nexus4812/nixie-jjy-clock/hardware/pcb/generated/routing/README.md

# control-r1 配線セッションの保存版

2026-11-08のローカル配線入力DSN、結果SES、SHA-256対応記録を保存する。`build/control-board/` から検査後にコピーした生成物で、直接編集しない。製造用出力ではない。

現在のPCBを開いて検査するだけなら、このSESを再取り込みする必要はない。配置/接続/制約/ライブラリ版やclone先のパスを変えた場合は、現在のDSNを生成して再配線する。DSN先頭の絶対パスもハッシュ対象なので、他PCで保存セッションを無条件に再利用しない。

再開コマンド、ツール取得元/版/チェックサム、線幅拡幅後の再DRCについては `git show 4e38a86:HANDOFF.md` を参照。`.routing.json` は実行時のパスを含む履歴であり、ユーザー設定ではない。
