nexus4812/nixie-jjy-clock/docs/decisions.md

# 設計判断と変更履歴

状態の意味：採用方針＝要求に基づく進め方、候補＝定格/調達/実測待ち、未決定＝比較に必要な証拠が不足。

| ID / 日付 | 状態 | 判断・理由 | 比較・影響範囲 |
| --- | --- | --- | --- |
| D01 / 2026-11-08 | 採用方針 | macOS/Ubuntu両対応、Python標準ライブラリ中心 | 実ホストはmacOS。OS固有のシェル加工を避け、KiCad版とライブラリは両OSで揃える |
| D02 / 2026-11-08 | 採用方針 | 利用者の追加希望でArduino IDE / CLIを優先 | 調査途中のPico第一候補案を変更。5V Nano互換を優先し、RTC/I2Cも5Vへ。価格の安さは未保証 |
| D03 / 2026-11-08 | 候補 | クラシックNano互換 ATmega328P 5V/16MHz | 純正/国内互換/Picoと総額比較。RAM 2KB前提、USB逆給電とブートローダー差を要検証 |
| D04 / 2026-11-08 | 候補 | 4桁静的駆動、K155ID1×4と74HCT595×2 | 多重化より制御・負荷の見通しがよく高速スキャン不要。非選択出力の保護が解決しなければ再選定 |
| D05 / 2026-11-08 | 候補 | 1桁表示子板×4、制御板とコロンを分離 | 固定4桁基板より管間隔の調整が容易。配線・カバー・基板費用が増える |
| D06 / 2026-11-08 | 候補 | 12Vアダプター＋既製HV＋5V降圧＋JJY3V LDO | 自作HV不要。5V回路と3V受信部の変換、昇降圧の雑音対策が必要 |
| D07 / 2026-11-08 | 未決定 | HV170〜180Vを確定しない | 管原資料の200V以上条件と不一致。抵抗、ドライバー、絶縁、モジュール容量まで影響するためR01/R02で比較 |
| D08 / 2026-11-08 | 採用方針 | DS3231 IC＋CR2032の非充電構成を優先 | 安価なモジュールの充電回路差を避けるため。ICの正規調達費が増える可能性 |
| D09 / 2026-11-08 | 候補 | 3V JJY OUT→HCT125、選局入力は別途降圧変換 | AVR直結のしきい値余裕がない。HCT14はLow側しきい値の余裕を保証できず第一候補にしない |
| D10 / 2026-11-08 | 採用方針 | KiCad公式CLIの検査・出力を基準、MCPは任意 | CLI未導入で検証未実施。MCP/APIは導入後に実ツールとスキーマで確認する |
| D11 / 2026-11-08 | 採用方針 | KiCad 10.0.8でPhase 2回路図初版を作成 | 公式S式書式で生成しCLIで読戻し、ERC/ネットリスト/BOM/PDFを検査。SWIGは機械基板に使用。MCP追加設定は不要 |
| D12 / 2026-11-08 | 採用方針 | 利用者の追加指定でケースを並行設計、OpenSCADを採用 | `enclosure/layout.json` を共通寸法の正本にし、管中心・基板/穴・操作/電源・アンテナ・隙間を共有。寸法は現物確認前の暫定値 |
| D13 / 2026-11-08 | 候補 | 595 OEをGND固定に変更しD8を予備にする | 起動時の高インピーダンス入力を避ける。ラッチ初期値は未定義なので、HV許可前のデータ設定とハードウェア停止が必要。回路図・ピン表へ反映 |
| D14 / 2026-11-08 | 候補 | 表示板は42mmピッチ、コロン板は表示板より10mm前へ | 同一平面のコロン板が中央2枚と重なることを包絡検査で検出し解消。ケース240×110×90mmの仮案。R04/R08/R15で再評価 |
| D15 / 2026-11-08 | 候補 | 制御板の54部品に標準フットプリントを割当。595はNexperia 74HCT595D、バッファはSN74HCT125D | メーカー資料のSOICと整合。DS3231SN#、Keystone 1060、0805、TO-92 Wideを候補配置。R04の現物確認は継続 |
| D16 / 2026-11-08 | 採用方針 | 制御板へ5V/3V/論理のみ配置し、HV許可とコロン制御はJ42で別板へ | HV_RAW/12V/SHDNの配線を含めない。共通GNDは維持、絶縁を保証しない。J41/J45/J40/J50〜53を追加し全体111部品へ |
| D17 / 2026-11-08 | 候補 | RTC直下は両面の配線・ビア禁止。基板外形/穴はケースJSONから導出 | DS3231実装指示S06を反映。放射ノイズ/部品高さ/現物は未検証。GNDベタは未作成 |
| D18 / 2026-11-08 | 採用方針 | Freerouting 2.5.0 JVM＋KiCad取り込み/DRCで配線を検証 | ルーターの細線化に対し配線時0.30mmの間隔を指定し、取り込み後に幅0.20mm以上へ拡幅して再DRC。設計クリアランス0.25mm・線幅下限0.20mmは維持。実機/製造承認は別 |
| D19 / 2026-11-08 | 採用方針 | DSN/SESのSHA-256対応、回路図フィールド/NCネットも照合 | 古いSESの誤取り込み防止。KiCad 10のXMLの/とPCBの{slash}差をNC名で正規化。標準MountingHoleの識別子を保持してSESの空component問題を回避 |
| D20 / 2026-11-08 | 利用者指定 | 作業を引き継ぎ資料へ整理しcommit/push | HANDOFF、README、AGENTSと最新検査スナップショットを保存。設計作業の次の続行は引き継ぎ先へ |
| D21 / 2026-11-08 | 候補 | HV 200V候補・アノード18kΩ候補 | S01の電源200V以上に合わせる。維持電圧145Vは仮定で未実測。R01継続。回路図値を `18k_0.5W_R01_CANDIDATE` に変更 |
| D22 / 2026-11-08 | 候補 | K155ID1を維持し、桁ごとにダイオード10本＋47Vツェナーでクランプ | S03の55V以下/60V超で寿命500時間に基づく。40ch個別駆動より部品が少ない。型番未選定・未実測でR02継続。各桁に11部品追加 |
| D23 / 2026-11-08 | 候補 | 表示板は4桁共通の1設計、コロンのHV/論理コネクターを分離、コロンの放電抵抗を削除 | 発注設計を1種に減らす。コロン板に蓄電部品がないため放電抵抗は不要と判断 |
| D24 / 2026-11-08 | 候補 | 電源板90×60mmを新設、HVモジュールはS12の固定穴で載せハーネス接続 | 端子/ヘッダー版の差を基板へ持ち込まない。`hv_module_envelope` を電源板上へ移動。R06継続 |
| D25 / 2026-11-08 | 候補 | コロン板を14×42→16×60mm、穴±26へ変更 | HV間隔と部品配置に必要。管ガラスとの横隙間は2.5mmに減る。R15で現物確認 |
| D26 / 2026-11-08 | 候補 | HV-LV 2.5mm等のDRC規則を基板別 `.kicad_dru` に定義 | 当初案3mmより小さい。根拠は5.08mmコネクターとTO-92等の物理制約で、規格由来ではない。Q4のみ例外。R08継続 |

次の変更では、対象リスクID、根拠資料、BOM・ピン表・回路図・基板・ソフトウェア・検査手順への影響を追記する。Gitへのコミットは利用者の明示指示がある場合に行う。
