nexus4812/nixie-jjy-clock/docs/hv-boards-r1.md

# HV表示/コロン/電源板 r1

2026-11-08、状態：候補フットプリント・現物未照合・**製造/通電不可**。ERC/DRCの結果は幾何とネットの整合だけを示し、定格・絶縁・感電防止を保証しない。

| 基板 | 正本 | KiCad | 外形 | 部品 |
| --- | --- | --- | --- | --- |
| 表示板（4桁共通の1設計） | [display_layout.json](../hardware/pcb/display_layout.json) | [display-board](../hardware/pcb/generated_display/display-board.kicad_pro) | 34×54 | 18 |
| コロン板 | [colon_layout.json](../hardware/pcb/colon_layout.json) | [colon-board](../hardware/pcb/generated_colon/colon-board.kicad_pro) | 16×60 | 9 |
| 電源板 | [power_layout.json](../hardware/pcb/power_layout.json) | [power-board](../hardware/pcb/generated_power/power-board.kicad_pro) | 90×60 | 24 |

表示板の回路図は桁0の定義を基準とし、桁1〜3は同じPCBを4枚使う（全体回路図では別参照番号）。外形/穴は `enclosure/layout.json`。

## 根拠から決めた候補と、未確定のまま残すもの

**事実（資料）**

- S01 p.4：始動電圧 最大170V、電源200V以上、数字電流 DC 2.5〜3.5mA。p.5：DC動作は250V推奨。維持電圧の規定なし。
- S01 p.3 図A：底面視で 列±5.75（端子2〜4, 8〜10）、y=±4.5, 0、±4（端子1,5,7,11）y=±8、0（端子6,12）y=±9、ピンφ1。端子1から番号順。
- S03 p.2：閉じた出力は点灯ちらつき防止に55V以下、外付けの抵抗/ツェナー/共通カソードのダイオードマトリクスで60V以下へ制限する。60V超（内蔵ツェナーの降伏領域）での使用は寿命500時間。S03は原メーカー不明。
- S12 p.1, p.3：12V入力で170V時 typ 35mA、220V時 typ 24mA。外形45×37×17.6、固定穴φ2.2×2（間隔41）。SHDNはVINへ接続で停止。

**計算上の候補（実測なし）**

- HV公称200V（S01下限）。R100系を18kΩと仮定：維持145V・ドライバー降下1Vで (200−146)/18k ≈ 3.0mA。維持135Vなら約3.6mA（上限超）、155Vなら約2.4mA（下限未満）。維持電圧は実測値ではないためR01を閉じない。モジュールの可変出力で調整する前提。損失は3.5mAで約0.22W。短絡故障時 200²/18k≈2.2Wで定格を超える。
- 非選択出力クランプ：10本のダイオード＋47V共通ツェナー。47V±5%＋順方向約1Vで最大約50V。S03の55V以下を狙う。ダイオードとツェナーの個別型番・定格は未選定（`CLAMP_DIODE_100V_R02`、`ZENER_47V_R02`）。ゴースト点灯、ツェナー電流は実測が必要。R02は閉じない。
- BCD 10〜15のブランク時：HV−クランプ≈150Vは最大始動170Vより低く無点灯を見込むが、全ロットの保証ではない。ブランク機能を消灯の安全手段として扱わない。

**未確定のまま**：ネオン抵抗（`TBD_R07_NEON`）、ヒューズ、降圧器/HVモジュールの個別品、ソケット。数字の上下（端子12が上の候補）とソケット寸法は1:1印刷と現物で確認する（R04）。

## 回路変更

- 各桁に D100〜D109（カソード→クランプ）と Z10（クランプ→GND）。
- コロンのHVと論理を分離（J30=HV_RAWのみ、J31=GND/COLON_ENABLE）。コロン板には蓄電部品がないので放電抵抗R154を削除。J30.2はNC。
- 電源板へ保護・JP2・HV許可・放電、J43（→制御J41）、J44（←制御J42）、J47（降圧器）、J48/J49（HVモジュール LV/HV）、J60〜J63（→表示J20〜J23）、J64（→J30）、J65（→J31）を追加。モジュールはS12の固定穴でスペーサー固定し、端子はハーネス接続（端子/ヘッダー版の差を基板に持ち込まない）。

## 検査規則（`*.kicad_dru`）

| 対象 | 最小 | 備考 |
| --- | --- | --- |
| HV ↔ 低電圧 | 2.5mm | 当初案の3mmより小さい。5.08mmコネクターのパッド間は3.0mm |
| HV ↔ カソード系 | 1.5mm | 管の隣接ピン（端子1-2）は約1.9mm |
| カソード系 ↔ 低電圧 | 0.9mm | DIP隣接ピンの制約 |
| HV ↔ 基板端 / NPTH | 1.5 / 2.5mm | |
| 例外 | 1.0mm | Q4のコレクター(NEON_CATHODES)とベース(COLON_BASE)。TO-92端子間隔による |

これらは配置検討値で、材料/汚損/標高/規格から導いた絶縁距離ではない（R08）。

## 実行結果（KiCad 10.0.8 / macOS）

| 基板 | ERC | DRC | 未配線 | 等価性 | パッド照合 | 配線+ビア |
| --- | --- | --- | --- | --- | --- | --- |
| display | 0 | 0 | 0 | 0 | 64 | 260+14 |
| colon | 0 | 0 | 0 | 0 | 19 | 37+0 |
| power | 0 | 0 | 0 | 0 | 54 | 121+4 |

全体回路図：11ページ/166部品/543接続、資料基準106ピン、ERC 0。制御板は再取り込み後も ERC/DRC/未配線/等価性 0（共通寸法のハッシュ更新のため再生成）。記録は [validation/2026-11-08-hv](validation/README.md)。

配線は Freerouting 2.5.0。HV・カソードの一部と表示板のGND幹線は `seed_tracks` の手動定義で、残りを自動配線した。ルーターには実際より大きい間隔と内側へ寄せた外形を渡し、結果はKiCad DRCで再検査した。片面接続のビアは除去している。

## 未実施

実物照合、実装/通電、HV定格/過渡/放電/絶縁/熱、ゴースト点灯、Ubuntu、Arduino、OpenSCADの再実行（今回は共通寸法の定数とKiCad機械基板のみ更新）、Gerber出力。**製造データは意図して出力していない**。HV部の絶縁カバーは基板と別に必要（R08/R16）。
