nexus4812/nixie-jjy-clock/docs/requirements.md

# 要求仕様 v0.1

作成日：2026-11-08。状態：設計入力。以下の「必須」は利用者指定、「提案」は今回の構成案であり、実装済みではない。

## 必須要件と受け入れ方法

| ID | 要求 | 最終的な確認方法 |
| --- | --- | --- |
| REQ-01 | IN-12B ×4、24時間 `HH:MM`、交換可能なソケット | 全数字・00:00/23:59を表示、電源切断・放電後に交換確認 |
| REQ-02 | JJY 40kHz/60kHz、Wi-Fi/GPS/インターネット不使用 | 両選局の電気試験と実受信、ネットワーク依存がない構成確認 |
| REQ-03 | DS3231と電池で時刻保持、受信失敗中も時計を継続 | アンテナ切断、停電/復帰、RTCを独立した基準と比較 |
| REQ-04 | JJY未受信を識別できる状態表示、手動時刻設定 | 状態遷移、手動操作、無効RTC起動を試験 |
| REQ-05 | 安全性を確認できる市販低電圧ACアダプター、既製HVモジュール | 選定品の証憑・極性・定格と現物を照合 |
| REQ-06 | 高電圧端子に接触できない構造、交換と保守が可能 | カバー・ハーネス・固定具・放電の実物検査 |
| REQ-07 | 管位置と間隔を変更可能、ケース外形・穴は今確定しない | 独立表示子基板の仮配置とケースモックで確認 |
| REQ-08 | 調達、製造、はんだ付け、検査まで実行可能な日本語資料 | Phase 5の成果物・検査記録を照合 |
| REQ-09 | macOS/Ubuntuで開発を引き継げる | 同一KiCadメジャー版で開く、両OSでスクリプトとビルドを実行 |
| REQ-10 | Arduino系の開発環境で動く | Arduino IDEとArduino CLIで同じスケッチをコンパイル・書込 |

## 優先条件・任意機能

| 区分 | 内容 |
| --- | --- |
| 第一候補 | 橙色ネオン2灯でコロン、表示用と制御用の分離、AliExpress/秋月/aitendo等で調達 |
| 予算目標 | 完成電子回路15,000〜20,000円。アダプター、基板、コネクターを含めて評価。送料・予備品は別にも集計 |
| 任意 | 夜間消灯、定期数字巡回、受信中の表示消灯、診断用USBシリアル |
| 今回対象外 | 木製ケース・真鍮板の実製作、秒用の追加管、RGB演出、ネット同期、自作HV昇圧回路。ケース設計は追加指定により並行実施 |

## 使用・表示動作の提案

- 時刻・日付はJSTで保持し、DS3231は24時間モード。JJYの西暦下2桁は2000〜2099年として扱う案で、年の扱いをテストで固定する。
- `SET / + / -` の3ボタン。長押しで設定へ入り、時・分と必要な日付を設定できるようにする。表示は4桁なので日付は順番に編集する案。
- 状態は `RTC_INVALID / RTC_ONLY / RECEIVING / SYNCED / STALE` を区別する。LEDの点滅パターンと対応表を用意する。
- 有効なRTCがない起動時は架空の時刻を表示しない。管を消灯し状態LEDで設定待ちを知らせる。
- 初回未受信でも手動設定後は時刻表示を続ける。最新JJY成功日時を保持し、古い成功を「現在同期済み」と誤認させない。
- 自動受信は夜間の静かな時間帯に有限回、40/60kHzを順番に試す。具体的な時間、タイムアウト、消灯の許容時間はR09で調整する。
- 管の数字巡回は寿命を保証するものではない。表示電流・時間を守り、劣化した管への過大電流による復活処理は仕様に入れない。

## Phase 1資料整備の完了条件

仕様、出典付きの部品調査、構成比較、仮BOM、保留条件、Phase 2以降の計画があり、検査の実施状況を第三者が追跡できること。主要部品の採用や製造移行まで承認されたことは意味しない。
