nexus4812/nixie-jjy-clock/docs/components.md

# 採用候補部品・互換性調査

調査日：2026-11-08。資料IDのURLは [資料台帳](references/sources.json) にまとめる。資料記載と現物保証は異なる。購入可能なロット、写真、寸法はまだ照合していない。

## 選定の結論（暫定）

| 機能 | 第一候補 | 判定 |
| --- | --- | --- |
| MCU | ATmega328P、5V/16MHzのクラシックNano互換機 | Arduinoの希望により優先。販売品未確定（R03） |
| 数字 | IN-12B ×4、ソケット式 | 指定を維持。HV動作条件の確認が必要（R01/R04） |
| カソード駆動 | K155ID1 ×4 | 条件付き候補。非選択端子の電圧を要検討（R02） |
| 出力拡張 | Nexperia 74HCT595D ×2 | control-r1候補：SOIC-16。現物・調達未確認 |
| RTC | DS3231SN#のIC＋CR2032/Keystone 1060候補 | 基板上に充電回路を設けない構成を優先 |
| JJY | RCCM-6181B-JJY＋付属アンテナ | モジュール資料あり、調達は未成立（R05） |
| JJY信号変換 | SN74HCT125D | control-r1候補：SOIC-14。下り制御は別の変換回路 |
| HV | NCH6100HV相当の資料と実物が一致する既製品 | 電圧と負荷試験、出荷版照合が必要（R06） |
| コロン | 抵抗を内蔵しない橙色ネオン2個 | NE-2等の名称だけでは同定しない（R07） |

control-r1では上記に加えMCP1700-3002E/TO、0805受動部品、2.54mmヘッダーを候補配置した。端子表と標準ライブラリの全パッド番号を照合し、元ライブラリファイルのSHA-256を保存した。現物確認・購入見積は未完了。[制御板記録](control-board-r1.md) を参照。

## Arduino系MCUと費用の比較

Arduinoは開発環境・ボードの系統であり、Raspberry Pi PicoはLinuxを動かす通常のRaspberry Piとは別のマイコン基板。Picoが高価とは限らないが、今回の優先条件はArduino IDEで使いやすい構成とする。

| 候補 | 電気・開発上の差 | 価格の根拠 | 判断 |
| --- | --- | --- | --- |
| 汎用Nano互換 ATmega328P 5V/16MHz | 5Vロジックと直結しやすい。USB部品・寸法の差がある | 500〜1,000円は予算仮置き。AliExpress等の個別見積は未取得 | 第一候補。安価と断定して購入しない |
| Maker Nano | 国内販売のArduino互換候補 | 秋月116282の税込1,680円表示（S20） | 汎用品が不確かな場合の代替。付加回路と寸法を再調査 |
| AE-ATMEGA328-MINI | Arduino互換の小型ボード。外部書込器等が必要 | 秋月110347の税込950円表示（S21） | 書込器を含む総額で比較。Nanoとピン互換とはしない |
| Arduino Nano純正 | 5V、16MHz（S13） | 国内検索で税込4,200円の表示。確定BOMには未採用 | 初回予算には高め |
| Raspberry Pi Pico SC0915 | 無線なし、3.3V GPIO、Arduino対応には別コアが必要 | 秋月116132の税込800円表示（S19） | 比較候補。現在の第一候補から外す |
| ESP32-C3 | 無線を使わない方針に対して機能過多、3.3V | 今回価格・全端子の精査は行わない | 暫定候補から外す |

ATmega328PはRAM 2KBなので、受信の動的文字列や大きな波形保存を避ける。60秒フレーム、固定長イベントバッファ、整数のタイムスタンプで実現する案。NanoのD0/D1は書込・診断のため空ける。純正Nanoの資料を互換機の電源回路保証に流用しない。

## IN-12B

S01のPDF p.3〜4を画像として確認し、S02の翻訳とも比較した。

- 原資料の始動電圧は最大170V、DCの数字電流は2.5〜3.5mA。数字の表示試験値2.5mAとDC動作範囲を混同しない。
- 原資料の電源条件は200V以上、英訳の使用説明にはDC250Vの推奨もある。**170〜180Vでの全ロット・暗所・低温の始動を保証できない**（R01）。250Vへ自動的に引き上げる判断もしない。
- 外形図の最大高さ35mm、ピン径は約1mm。穴寸法はソケットの実際の端子寸法・推奨穴径から決める。
- 底面の矢印と図の視点が基準。正面から見た番号をそのままPCBへ置かない。座標・間隔・ソケットの向きはR04で実物と照合する。

| 図中端子 | 機能 | 図中端子 | 機能 |
| --- | --- | --- | --- |
| 1 | Anode | 7 | Cathode 5 |
| 2 | Cathode 0 | 8 | Cathode 4 |
| 3 | Cathode 9 | 9 | Cathode 3 |
| 4 | Cathode 8 | 10 | Cathode 2 |
| 5 | Cathode 7 | 11 | Cathode 1 |
| 6 | Cathode 6 | 12 | Cathode comma |

端子表は原資料の図中番号。KiCad番号との対応は独立レビューする。commaは今回未使用で開放し、HV領域に含める。ソケットはSK-136または適合した個別レセプタクルを比較し、接触径・保持力・挿抜力・耐電圧を確認する。安価な丸ピンICソケットで代用できるとはみなさない。

## K155ID1

S03は販売元配布のロシア語技術資料で、原メーカーと版は特定できていない。図と端子説明は画像で確認したが、調達品への適用保証は保留。

| 端子 | 機能 | 端子 | 機能 |
| --- | --- | --- | --- |
| 1 | Y8 | 9 | Y3 |
| 2 | Y9 | 10 | Y7 |
| 3 | X1（重み1） | 11 | Y6 |
| 4 | X4（重み8） | 12 | GND |
| 5 | VCC | 13 | Y4 |
| 6 | X2（重み2） | 14 | Y5 |
| 7 | X3（重み4） | 15 | Y1 |
| 8 | Y2 | 16 | Y0 |

資料記載の電源5V±5%、消費電流最大25mA/個を予算計算に用いる。入力Low時の負荷は端子3が最大1.6mA、4/6/7が最大3.2mAで、CMOS入力の軽負荷と同じ扱いにしない。

10〜15のBCDは選択出力なしとの記載があるが、これを安全な消灯保証には使わない。非選択出力は60V以下の制約とクランプに関する注意があり、管の電源180〜200Vを出力に直接加えてよいICではない。消灯・始動・断線・管抜去・停電中を含む全状態を評価する（R02）。SN74141等への置き換えも型番ごとに再評価する。

R02が解消しなければ、300V級の個別トランジスター40ch＋シフトレジスター等を比較する。これは部品点数・面積・価格が大きく変わり、現BOMには含めていない。

## 74HCT595 ×2

S04/S05で論理と端子を確認。5Vで使用し、各出力はK155ID1入力1本だけを駆動する。HCTとHCは入力しきい値が異なる。S04のTI `SN74HCT595PW` はTSSOPであり、DIP品の見積やフットプリントと混在させない。

| 端子 | 機能 |
| --- | --- |
| 16 / 8 | VCC / GND |
| 14 / 11 / 12 | SER / SRCLK / RCLK |
| 13 / 10 | OE（Lowで有効） / SRCLR（Lowでシフトレジスター消去） |
| 15,1,2,3,4,5,6,7 | QA〜QH |
| 9 | QH'（次段SERへ、MCUの入力へ戻さない） |

5V HCTの入力はHigh最小2.0V、Low最大0.8V。出力の試験条件±6mAはK155ID1の最大3.2mA入力負荷を上回る。1パッケージで2桁分のLow負荷は `2 × (1.6 + 3×3.2) = 22.4mA`。ただし採用メーカーの全温度・VCCでのVOL、電源/GND合計電流、配線、余裕をPhase 2で最終照合する。

OEはHighで**高インピーダンス**になるだけ。K155ID1入力の浮きと表示電源の許可を別に設計する。SRCLRだけでは出力ラッチを消去しない。起動時はHVをハードウェアで禁止し、データ設定・ラッチ確定後に許可する。

## DS3231とバックアップ

S06：VCC 2.3〜5.5V、I2C 7bitアドレス `0x68`、SO-16 300mil。5VのMCUに合わせてVCCとI2Cプルアップを5Vへ統一する案。Picoへ変更する場合は電源・プルアップも見直す。

| 端子 | 接続案 |
| --- | --- |
| 1 32kHz | 未使用、出力無効化し開放 |
| 2 VCC | +5V、直近に0.1µF〜1µF |
| 3 INT/SQW | MCUへ1Hz同期用、外部プルアップ |
| 4 RST | 使わなければ開放。外部プルアップは付けない |
| 5〜12 N.C. | 資料指示に従ってGNDへ接続 |
| 13 GND / 14 VBAT | GND / CR2032正極。電池負極はGND |
| 15 SDA / 16 SCL | Nano A4 / A5、短い配線、プルアップ4.7kΩは初期検討値 |

CR2032は一次電池で充電しない。DS3231のIC自身と、市販RTCモジュールに追加された充電回路は区別する。廉価な充電回路付きモジュールをそのまま使わない。OSFと日付・時刻範囲を確認し、有効時刻を書き込んでからOSFをクリアする。RTCの初回発振開始条件も実機で検証する。

## RCCM-6181B-JJYとレベル変換

S07の税込1,045円は価格表示であり、「準備中」のため購入成立とは扱わない。S08のPDF p.3〜4で基板22×13.5mm、端子ピッチ2.5mmと記載される。**2.54mmと決めつけない**。図は配線面を示しており、現物と表裏・PIN1を照合する（R04）。

| モジュール端子 | 記載名 | 接続案 |
| --- | --- | --- |
| 1 | VDD | 専用LDOによる3.0V |
| 2 | GND | 静かな電源リターン |
| 3 | PON/PDN2 | 3V領域の選局/停止制御 |
| 4 | OUT | SN74HCT125等の高入力抵抗バッファを介してMCU |
| 5 | SEL/PDN1 | 3V領域の選局/停止制御 |

| PDN1（pin5） | PDN2（pin3） | S08の動作 |
| --- | --- | --- |
| H | H | Power Down |
| H | L | 60kHz |
| L | H | 40kHz |
| L | L | 40kHz |

S08には1.1〜5.0Vとあるが、S07と搭載ICのS09は1.1〜3.6Vで、ICの絶対最大も3.6V。モジュールの5V動作は採用しない。3V電源でも電圧変換を省略してよいとは限らない。

MAS6181BのOUTは搬送波最大時Low、減衰時High。出力能力はµA級で、一般的な数kΩのプルアップやLEDは駆動しない。MCUの内部プルアップも無効にする。

5V AVR入力へ直結するのは保証を満たさない可能性があるため、S32のHCT125を候補にする。3V時の `VOH > 0.8 VDD ≈ 2.4V`、`VOL < 0.2 VDD ≈ 0.6V` を、HCT125のHigh最小2.0V / Low最大0.8Vと比較できる。電源誤差、入力漏れ、起動中の電流、実モジュールの出力段はR05で詰める。HCT14はヒステリシスのLow側しきい値に対する余裕を保証できないため第一候補にしない。

MCU→PDN1/PDN2は5V直結不可。3Vへのプルアップ＋小信号NPNによるオープンコレクター等を検討し、初期状態をH/H＝停止とする。抵抗、トランジスター型番、信号の反転、立上り中の逆給電は未確定。モジュールOUTの反転極性をファームウェアで正規化し、NICTのRFパルス幅を出力High幅と取り違えない。

## 既製HVモジュール

S12のNCH6100HVは、入力12〜24Vを想定、出力85〜235V可変。表には12V入力/170V出力時35mAのtyp値があるが、全ロットでの連続保証値とはみなさない。200V付近の必要負荷・温度特性は未確認。SHDNは開放/Lowで動作、VIN側で停止という記載で、入力逆接保護はない。

3V/5V GPIOをSHDNへ無条件に直結しない。12V領域の変換段と、起動時停止を保証する入力電源ゲートを検討する。出力遮断・残留電荷・放電抵抗は別に必要。販売中の同名品/類似NCH8200HV/NCH6300HVの定格やピン配置を流用しない。個別販売ページ、価格、出荷版写真、EN回路は未確認（R06）。

## ネオン・電源・受動部品

- NE-2という通称には始動電圧・電流・寸法の異なる品がある。S18はNE-2とNE-2Hの差を示す参考で、採用品の確定資料ではない。2灯には独立した抵抗を付ける。並列2灯を抵抗1本で共用しない。
- MPSA42（S17）のVCEOは300V。端子1=Emitter、2=Base、3=Collectorはこのメーカーの当該パッケージに限定する。ネオン1〜2mA級のローサイド制御候補だが、実際の抵抗・飽和条件とピン形状を確定していない。
- アダプター候補ATS012S-W120UはS22で12V1A、税込980円、センタープラス5.5/2.1mmを確認。PSE等の証憑・現物ラベルと絶縁の確認は未完了なので、安全性確認済み部品とはまだ呼ばない（R10）。
- 12→5Vは既製降圧モジュールを優先。型番、リップル、待機電力は未確定。12→5Vのリニア方式は仮0.15Aでも約1.05Wとなるので放熱・受信雑音との比較が必要。
- HV抵抗は抵抗値・W数だけでなく連続使用電圧、故障時電圧、難燃性を確認。HVコンデンサーとコネクターはモジュール最大出力も考慮し、最終部品の定格を個別に確認する。

## 既存設計・ライブラリの再利用候補

| 候補 | 利用できそうな部分 | 制約・現状 |
| --- | --- | --- |
| Adafruit RTClib（S29） | Arduino向けDS3231の読書き | MITを確認。版・依存関係を固定してから評価、未導入 |
| STM32_NixieClock（S30） | 作者公開KiCadでの制御/表示分離、RTC接続の考え方 | MITを確認。管とMCUが異なり、そのまま流用しない。未取り込み |
| KiCad公式標準ライブラリ | ロジック、RTC、受動部品、Nano関連の候補検索 | KiCad 10.0.8導入版を使用し、54部品と取り付け穴に候補を選定。全ピン番号/ネットを検査、ファイルハッシュを記録。現物適合は未確認。ライセンスはS39 |
| NICT（S10/S11） | JJY復号仕様と擬似フレームの根拠 | プロトコル一次資料。復号器は小さく自作する案、既存JJYライブラリは未選定 |

第三者の回路やフットプリントを取り込む際は、出典・commit・ライセンス・修正内容を記録する。既存設計の存在は電気的安全性の証明には使わない。
