nexus4812/nixie-jjy-clock/docs/validation/2026-11-08/system-bom.csv

Reference | Value | Sources | OpenRisks | ReviewStatus | Footprint | Qty
A1 | NANO_328P_5V16MHz | S13;S14 | R03;R11;R04 | HOLD | Module:Arduino_Nano | 1
BT1 | Keystone 1060 | S06 | R04 | HOLD | Battery:BatteryHolder_Keystone_1060_1x2032 | 1
C1 | 100u_25V |  |  | DRAFT |  | 1
C2 | 100n_50V |  |  | DRAFT |  | 1
C3 | 47u_16V |  | R04 | HOLD | Capacitor_THT:CP_Radial_D5.0mm_P2.00mm | 1
C4 | 100n_50V |  | R04 | HOLD | Capacitor_SMD:C_0805_2012Metric | 1
C10 | 100n_50V |  | R04 | HOLD | Capacitor_SMD:C_0805_2012Metric | 1
C11 | 100n_50V |  | R04 | HOLD | Capacitor_SMD:C_0805_2012Metric | 1
C12 | 10u_16V |  | R04 | HOLD | Capacitor_SMD:C_0805_2012Metric | 1
C20 | 100n_50V |  | R04 | HOLD | Capacitor_SMD:C_0805_2012Metric | 1
C30 | 10u_16V |  | R04 | HOLD | Capacitor_SMD:C_0805_2012Metric | 1
C31 | 100n_50V |  | R04 | HOLD | Capacitor_SMD:C_0805_2012Metric | 1
C32 | 1u_EFFECTIVE_MIN | S33 | R04 | HOLD | Capacitor_SMD:C_0805_2012Metric | 1
C33 | 100n_50V |  | R04 | HOLD | Capacitor_SMD:C_0805_2012Metric | 1
C34 | 100n_50V |  | R04 | HOLD | Capacitor_SMD:C_0805_2012Metric | 1
C40 | 100n_50V |  | R04 | HOLD | Capacitor_SMD:C_0805_2012Metric | 1
C41 | 100n_50V |  | R04 | HOLD | Capacitor_SMD:C_0805_2012Metric | 1
C42 | 100n_50V |  | R04 | HOLD | Capacitor_SMD:C_0805_2012Metric | 1
C100 | 100n_50V |  |  | DRAFT |  | 1
C110 | 100n_50V |  |  | DRAFT |  | 1
C120 | 100n_50V |  |  | DRAFT |  | 1
C130 | 100n_50V |  |  | DRAFT |  | 1
D1 | 1N5819 | S36 |  | DRAFT |  | 1
D2 | AMBER_STATUS |  |  | DRAFT |  | 1
F1 | FUSE_T1A_TBD |  | R06 | HOLD |  | 1
J1 | 12V_DC_INPUT |  | R10 | HOLD |  | 1
J2 | HV_RAW_GUARDED_TP |  | R08 | HOLD |  | 1
J3 | I2C_TEST |  | R04 | HOLD | Connector_PinHeader_2.54mm:PinHeader_1x04_P2.54mm_Vertical | 1
J4 | JJY_DIAGNOSTIC |  | R05;R04 | HOLD | Connector_PinHeader_2.54mm:PinHeader_1x03_P2.54mm_Vertical | 1
J10 | DIGIT0_LOGIC |  | R04 | HOLD |  | 1
J11 | DIGIT1_LOGIC |  | R04 | HOLD |  | 1
J12 | DIGIT2_LOGIC |  | R04 | HOLD |  | 1
J13 | DIGIT3_LOGIC |  | R04 | HOLD |  | 1
J20 | DIGIT0_HV_GUARDED |  | R04;R08 | HOLD |  | 1
J21 | DIGIT1_HV_GUARDED |  | R04;R08 | HOLD |  | 1
J22 | DIGIT2_HV_GUARDED |  | R04;R08 | HOLD |  | 1
J23 | DIGIT3_HV_GUARDED |  | R04;R08 | HOLD |  | 1
J30 | COLON_HARNESS_GUARDED |  | R04;R08 | HOLD |  | 1
J40 | REAR_UI_HARNESS |  | R04 | HOLD | Connector_PinHeader_2.54mm:PinHeader_1x05_P2.54mm_Vertical | 1
J41 | EXTERNAL_5V_BUCK |  | R11;R04 | HOLD | Connector_PinHeader_2.54mm:PinHeader_1x02_P2.54mm_Vertical | 1
J42 | LV_CONTROL_ONLY |  | R06;R08;R04 | HOLD | Connector_PinHeader_2.54mm:PinHeader_1x03_P2.54mm_Vertical | 1
J45 | TO_EXTERNAL_JJY |  | R04;R05 | HOLD | Connector_PinHeader_2.54mm:PinHeader_1x05_P2.54mm_Vertical | 1
J50 | TO_DIGIT0_LV |  | R04 | HOLD | Connector_PinHeader_2.54mm:PinHeader_1x06_P2.54mm_Vertical | 1
J51 | TO_DIGIT1_LV |  | R04 | HOLD | Connector_PinHeader_2.54mm:PinHeader_1x06_P2.54mm_Vertical | 1
J52 | TO_DIGIT2_LV |  | R04 | HOLD | Connector_PinHeader_2.54mm:PinHeader_1x06_P2.54mm_Vertical | 1
J53 | TO_DIGIT3_LV |  | R04 | HOLD | Connector_PinHeader_2.54mm:PinHeader_1x06_P2.54mm_Vertical | 1
JP1 | REMOVE_FOR_USB |  | R11;R04 | HOLD | Connector_PinHeader_2.54mm:PinHeader_1x02_P2.54mm_Vertical | 1
JP2 | HV_ARM_NORMALLY_OPEN |  | R06;R11 | HOLD |  | 1
NE1 | ORANGE_NEON_R07 | S18 | R07 | HOLD |  | 1
NE2 | ORANGE_NEON_R07 | S18 | R07 | HOLD |  | 1
PS1 | 12V_TO_5V_TBD |  | R06 | HOLD |  | 1
PS2 | NCH6100HV_R06 | S12 | R06 | HOLD |  | 1
Q1 | MPSA42 | S17 | R06;R11 | HOLD |  | 1
Q2 | MPSA42 | S17 | R04 | HOLD | Package_TO_SOT_THT:TO-92_Inline_Wide | 1
Q3 | MPSA42 | S17 | R04 | HOLD | Package_TO_SOT_THT:TO-92_Inline_Wide | 1
Q4 | MPSA42 | S17 |  | DRAFT |  | 1
R1 | 2k2_0.25W |  | R06 | HOLD |  | 1
R2 | 4k7 |  |  | DRAFT |  | 1
R3 | 100k |  |  | DRAFT |  | 1
R4 | 110k_0.5W_HV |  | R06;R08 | HOLD |  | 1
R5 | 110k_0.5W_HV |  | R06;R08 | HOLD |  | 1
R10 | 100R |  | R04 | HOLD | Resistor_SMD:R_0805_2012Metric | 1
R11 | 100R |  | R04 | HOLD | Resistor_SMD:R_0805_2012Metric | 1
R12 | 100R |  | R04 | HOLD | Resistor_SMD:R_0805_2012Metric | 1
R13 | 10k |  | R04 | HOLD | Resistor_SMD:R_0805_2012Metric | 1
R14 | 10k |  | R04 | HOLD | Resistor_SMD:R_0805_2012Metric | 1
R20 | 4k7 |  | R04 | HOLD | Resistor_SMD:R_0805_2012Metric | 1
R21 | 4k7 |  | R04 | HOLD | Resistor_SMD:R_0805_2012Metric | 1
R22 | 10k |  | R04 | HOLD | Resistor_SMD:R_0805_2012Metric | 1
R30 | 100R |  | R04 | HOLD | Resistor_SMD:R_0805_2012Metric | 1
R31 | 1k |  | R04 | HOLD | Resistor_SMD:R_0805_2012Metric | 1
R32 | 47k |  | R04 | HOLD | Resistor_SMD:R_0805_2012Metric | 1
R33 | 47k |  | R04 | HOLD | Resistor_SMD:R_0805_2012Metric | 1
R34 | 100k |  | R04 | HOLD | Resistor_SMD:R_0805_2012Metric | 1
R35 | 47k |  | R04 | HOLD | Resistor_SMD:R_0805_2012Metric | 1
R36 | 47k |  | R04 | HOLD | Resistor_SMD:R_0805_2012Metric | 1
R37 | 100k |  | R04 | HOLD | Resistor_SMD:R_0805_2012Metric | 1
R40 | 1k |  | R04 | HOLD | Resistor_SMD:R_0805_2012Metric | 1
R41 | 10k |  | R04 | HOLD | Resistor_SMD:R_0805_2012Metric | 1
R42 | 10k |  | R04 | HOLD | Resistor_SMD:R_0805_2012Metric | 1
R43 | 10k |  | R04 | HOLD | Resistor_SMD:R_0805_2012Metric | 1
R100 | TBD_R01_ANODE |  | R01;R02;R08 | HOLD |  | 1
R101 | 1M_0.25W_HV |  | R06;R08 | HOLD |  | 1
R110 | TBD_R01_ANODE |  | R01;R02;R08 | HOLD |  | 1
R111 | 1M_0.25W_HV |  | R06;R08 | HOLD |  | 1
R120 | TBD_R01_ANODE |  | R01;R02;R08 | HOLD |  | 1
R121 | 1M_0.25W_HV |  | R06;R08 | HOLD |  | 1
R130 | TBD_R01_ANODE |  | R01;R02;R08 | HOLD |  | 1
R131 | 1M_0.25W_HV |  | R06;R08 | HOLD |  | 1
R150 | TBD_R07_NEON |  | R01;R07;R08 | HOLD |  | 1
R151 | TBD_R07_NEON |  | R01;R07;R08 | HOLD |  | 1
R152 | 10k |  |  | DRAFT |  | 1
R153 | 100k |  |  | DRAFT |  | 1
R154 | 1M_0.25W_HV |  | R06;R08 | HOLD |  | 1
RX1 | RCCM-6181B-JJY | S08;S09 | R04;R05 | HOLD |  | 1
SW1 | SET |  |  | DRAFT |  | 1
SW2 | PLUS |  |  | DRAFT |  | 1
SW3 | MINUS |  |  | DRAFT |  | 1
U1 | 74HCT595D | S04;S05 | R04 | HOLD | Package_SO:SOIC-16_3.9x9.9mm_P1.27mm | 1
U2 | 74HCT595D | S04;S05 | R04 | HOLD | Package_SO:SOIC-16_3.9x9.9mm_P1.27mm | 1
U3 | DS3231SN# | S06 | R10;R04 | HOLD | Package_SO:SOIC-16W_7.5x10.3mm_P1.27mm | 1
U4 | MCP1700-3002E/TO | S33 | R04 | HOLD | Package_TO_SOT_THT:TO-92_Inline_Wide | 1
U5 | SN74HCT125D | S32 | R04 | HOLD | Package_SO:SOIC-14_3.9x8.7mm_P1.27mm | 1
U10 | K155ID1_R02_HOLD | S03 | R02;R04 | HOLD |  | 1
U11 | K155ID1_R02_HOLD | S03 | R02;R04 | HOLD |  | 1
U12 | K155ID1_R02_HOLD | S03 | R02;R04 | HOLD |  | 1
U13 | K155ID1_R02_HOLD | S03 | R02;R04 | HOLD |  | 1
V1 | IN-12B_SOCKET_R04 | S01 | R01;R04 | HOLD |  | 1
V2 | IN-12B_SOCKET_R04 | S01 | R01;R04 | HOLD |  | 1
V3 | IN-12B_SOCKET_R04 | S01 | R01;R04 | HOLD |  | 1
V4 | IN-12B_SOCKET_R04 | S01 | R01;R04 | HOLD |  | 1
