nexus4812/nixie-jjy-clock/enclosure/generated/layout.scad

layout_revision = "mechanical-r0";
layout_sha256 = "ad1ad668798e220fcee5c1cdb3e5d12154a8be6403f1569c8be29b2554062733";
case_size = [240, 110, 90];
case_wall = 10;
rear_thickness = 3;
brass_thickness = 1.5;
tube_centers = [[-63.0, -3, 48], [-21.0, -3, 48], [21.0, -3, 48], [63.0, -3, 48]];
tube_size = [21, 35, 31];
tube_radial_gap = 1;
tube_corner_radius = 5;
display_plane_y = 40;
colon_centers_z = [40, 56];
colon_aperture_diameter = 6;
colon_lamp_diameter = 5;
colon_center_x = 0;
colon_front_y = -2;
colon_depth = 16;
panel_mount_holes = [[-111, 9], [111, 9], [-111, 81], [111, 81]];
panel_hole_diameter = 3.2;
button_centers_x = [-35, -15, 5];
button_center_z = 42;
button_hole_diameter = 7;
power_jack_center = [75, 55];
power_jack_hole_diameter = 8;
status_led_center = [35, 42];
status_led_hole_diameter = 3.2;
antenna_center = [-75, 88, 70];
antenna_length = 60;
antenna_diameter = 10;
hv_center = [80.5, 78.5, 33];
hv_size = [46, 38, 20];
hv_cover_wall = 2;
hv_cover_gap = 4;
boards = [["display_0", "XZ", [-63.0, 40, 48], 34, 54, 1.6, [[-13, -23], [13, -23], [-13, 23], [13, 23]], 3.2], ["display_1", "XZ", [-21.0, 40, 48], 34, 54, 1.6, [[-13, -23], [13, -23], [-13, 23], [13, 23]], 3.2], ["display_2", "XZ", [21.0, 40, 48], 34, 54, 1.6, [[-13, -23], [13, -23], [-13, 23], [13, 23]], 3.2], ["display_3", "XZ", [63.0, 40, 48], 34, 54, 1.6, [[-13, -23], [13, -23], [-13, 23], [13, 23]], 3.2], ["control", "XY", [-45, 72, 16], 100, 55, 1.6, [[-46, -23.5], [46, -23.5], [-46, 23.5], [46, 23.5]], 3.2], ["power", "XY", [62, 75, 16], 90, 60, 1.6, [[-41, -26], [41, -26], [-41, 26], [41, 26]], 3.2], ["colon", "XZ", [0, 30, 48], 16, 60, 1.6, [[0, -26], [0, 26]], 2.2]];
