nexus4812/nixie-jjy-clock/manufacturing/README.md

# 製造準備の状態

**未製造承認。Gerber、穴あけデータ、発注用BOMはまだない。** `docs/bom.csv` は調査・費用見積用であり、確定部品番号や最終値を持つ製造BOMではない。

Phase 2の `build/phase2/bom.csv` も回路図由来のレビュー用BOM。`TBD` と保留項目が残る。`hardware/mechanical/generated/` の基板は外形・穴のみで回路を含まないため、JLCPCBへ送らない。ケースのSCAD/SVG/STLも現物公差を確認する前の検討用。

Phase 5で元のKiCadデータから `build/manufacturing/<revision>/` にGerber、Excellon、検査結果、出力履歴、ハッシュ一覧を生成する。ここにはリリース手順と発注条件を置き、手編集元と生成物を区別する。

発注前に確認する内容：

- 回路図/PCB/確定BOMの部品番号・ネット・フットプリントが一致し、ERC/DRCの未解決項目が説明されている。
- 外形、穴、管間隔、ソケット、保護カバー、コネクターを現物と照合できている。
- JLCPCBの加工条件、層/板厚/銅厚/表面処理、注文枚数、送料を見積で確認している。
- Gerberと穴あけデータを別ビューアーで確認し、層、原点、外形、表裏、穴とランドの対応を検査している。
- HVの耐圧・絶縁・放電・初期OFF・電源逆給電が別の検査対象になっている。

実装後は低電圧のみから段階通電し、HVダミー負荷、単管、全管、受信の順に進める。通電前の具体的な測定値・合否基準は最終回路が決まってから作成する。製造ファイルの出力成功と、安全に動く完成品の確認は別の記録にする。

低電圧制御板 `control-r1` は候補配置/配線済みでERC/DRC/未配線/回路図等価性の問題0を確認した。`hardware/pcb/generated/control-board.kicad_pcb` と保存したDSN/SESもレビュー用であり、現物未照合のまま発注しない。高電圧表示/電源/コロンPCBも候補配置/配線済みだが同じくレビュー用で、Gerberは出力していない。`git show 4e38a86:HANDOFF.md` を参照する。
