nexus4812/nixie-jjy-clock/docs/verification.md

# Phase 1の検証記録

このページはPhase 1時点の履歴。KiCad導入後の履歴は [Phase 2初版](phase2-review.md)、最新の制御PCB検査は [control-r1](control-board-r1.md) を参照する。このページの未実施一覧・32件という出典数・未導入状態はPhase 1当時の記録で、現在値ではない。実測は引き続き未実施。

2026-11-08。実施結果を追記するための正本。自動検査の成功は資料の整合性に限定する。

## 環境・資料の確認

- リポジトリは `LICENSE` とGit管理情報のみから開始した。既存ファイルや利用者の変更を上書きしていない。
- macOS 15.7.4 / arm64、Python 3.13.1、Git、curlを確認。KiCad CLIと現在のPythonのpcbnewは未検出。環境結果は [JSON](environment-2026-11-08.json)。
- メーカー、販売元、NICT、ツール開発元を閲覧し、URLと資料区分を [資料台帳](references/sources.json) に記録した。
- IN-12B原資料p.3〜4、K155ID1資料p.1〜2、JJYモジュール図面p.3はダウンロードしたPDFを画像化して確認した。補助のPDF画像化ツールはGit対象外の `build/research-tools/` に導入した一時調査用で、共通スクリプトの依存ではない。
- 初回と再取得の結果・SHA-256は [取得記録](references/retrieval-2026-11-08.json) に残す。ローカル取得できない資料は閲覧した資料と区別し、未取得として管理する。

## 金額の意味

`docs/bom.csv` の `observed` は税込販売表示、`budget` は見積未取得の予算枠。技術資料への参照は価格の根拠を意味しない。JJYの準備中表示やアダプターの安全証憑未確認も別の状態として記録している。

集計は資料整合性スクリプトで再計算する。外装、工具、測定器、予備管、再設計費用は未算入。K155ID1に追加保護が必要になった場合も増額する可能性がある。15,000〜20,000円は目標であり、達成した予算ではない。

| 集計区分 | 下限の予算枠 | 上限の予算枠 |
| --- | --- | --- |
| 電子回路・アダプター・初回裸基板 | 15,315円 | 26,325円 |
| 送料等 | 1,000円 | 2,500円 |
| 合計 | 16,315円 | 28,825円 |

予算目標に収まる可能性はあるが、現時点の幅では超過する。特に管とソケット、HVモジュール、RTC、分割基板の送料を見積で絞る必要がある。安全部品を削って帳尻を合わせない。

## 実行した資料検査

- `python3 scripts/check_phase1.py --output build/phase1-check.json`：成功。32件の出典と21行のBOM、必須資料、リンク、出典参照、金額区分を検査。取得済みキャッシュがある場合は記録のSHA-256とも照合した。
- `python3 -m py_compile scripts/inspect_environment.py scripts/fetch_references.py scripts/check_phase1.py`：Python構文検査に成功。
- PDF取得は16件を対象に11件を保存、5件は失敗。S05/S16はHTTP 403、S06は通信タイムアウト、S17は証明書期限エラー、S18は名前解決失敗。失敗を修正済みとして扱っていない。
- 通常の資料検査は未取得項目を報告しつつ続行する。`--require-downloads` は全PDF取得を要求する厳格モードで、現状では失敗するのが正しい。
- 厳格モードの終了コード1を確認。作業ディレクトリを `/tmp` に変えて資料検査を実行しても成功した。新規資料・スクリプトは `git diff --no-index --check` で空白エラーがないことを確認した。
- この記録のコマンドはmacOSで実行。両OS対応はスクリプトの実装方針であり、Ubuntu上で成功したという記録ではない。

## 未実施の検査

| 検査 | 状態・理由 |
| --- | --- |
| KiCad読込・ERC・DRC・ネット整合 | 未実施。KiCad未準備、設計データ未作成 |
| Gerber・穴あけ出力・製造適合 | 未実施。基板未設計、JLCPCBの個別条件/見積未確認 |
| Arduinoのビルド・書込・ロジック単体試験 | 未実施。ファームウェアと開発ツール未準備 |
| Ubuntu上の実行 | 未実施。現在のホストはmacOS |
| 部品現物・ソケット/フットプリント | 未実施。部品未調達 |
| HV電圧・電流・熱・放電・絶縁・接触防止 | 未実施。回路・実装品未作成 |
| JJY40/60kHzの実受信・雑音評価 | 未実施。受信品未調達 |

未実施項目は将来の試験計画であり、成功扱いにしない。
