nexus4812/nixie-jjy-clock/docs/validation/2026-11-08/enclosure.png

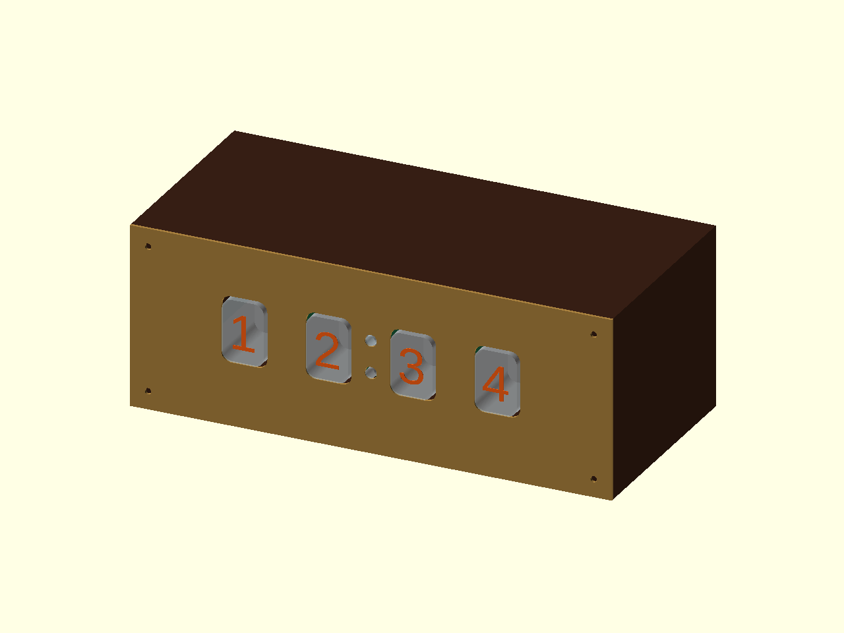
docs/validation/2026-11-08/enclosure.png
