nexus4812/nixie-jjy-clock/docs/risks.md

# 未確定事項と設計上のリスク

2026-11-08時点。R13のKiCad導入・回路図検査は進展したが、各項目の現物条件は未完了。資料があること、試算できること、実測で確認したことを別に扱う。担当AIは資料・回路・試験設計、人間は購入品の現物照合と通電測定。

| ID | 重要度 | 未確定事項・危険 | 閉じるための証拠 / 次の作業 | 保留する工程 |
| --- | --- | --- | --- | --- |
| R01 | 高 | IN-12Bの原資料は電源200V以上。170〜180Vでの始動・電流保証がない | 原資料の条件を再確認、180V/200V案の比較、実ロットの全数字・暗所・温度での始動と2.5〜3.5mAの確認 | HV電圧・抵抗確定、製造リリース |
| R02 | 高 | K155ID1の非選択出力に60V制約。消灯・断線時の過電圧、クランプ、資料の原メーカー不明 | 通常/起動/停止/管抜去を解析、保護と電源遮断を設計、現物と負荷で測定。解消しなければ別ドライバーを比較 | ドライバー回路凍結 |
| R03 | 中 | Nano互換機の製品、価格、ブートローダー、電源回路が未確定 | ATmega328P 5V/16MHz品の個別ページ、回路図、寸法、写真、書込試験。LGT8F等は別製品として評価 | MCUフットプリント・書込条件確定 |
| R04 | 高 | 管/ソケットの向き、穴径、モジュールの2.5mmピッチ、現物寸法未照合 | 実物写真と寸法、原図とKiCadピン表の独立照合、1:1印刷と挿抜確認 | 対象フットプリント確定 |
| R05 | 高 | JJYモジュールは準備中。資料5V表記とIC3.6V上限が矛盾。OUTはµA級 | 調達成立または代替資料、3V給電、双方向のレベル変換と逆給電を設計、出力極性/遅延/選局を測定 | JJYインターフェース凍結 |
| R06 | 高 | HV販売品の出荷版、連続電流、最大電圧、EN、出力容量、過渡が未確認 | 個別販売URL・設計者資料と照合、ダミー負荷/温度/無負荷/起動/停止の実測。15mA級を無条件採用しない | 電源・保護・放電回路確定 |
| R07 | 中 | ネオンの正式仕様、消灯時漏れ、抵抗未確定 | 供給品の電流・維持/始動電圧・暗所特性・寸法とメーカーの端子資料 | コロン抵抗/フットプリント確定 |
| R08 | 高 | HV/LV距離、ソケット/DIP隣接端子、真鍮や固定具への絶縁が未評価 | 電圧・材料・汚損・標高・コネクター定格を定義し規格根拠を確認、配置レビュー、カバー/沿面距離の現物検査 | PCB安全設計・通電許可 |
| R09 | 中 | 昇降圧・USB・真鍮板による受信妨害、受信場所の電界強度 | 両局で表示/昇圧/USBのON/OFF比較、アンテナ位置方向と受信率・有限タイムアウトを記録 | ケース配置・受信スケジュール確定 |
| R10 | 高 | アダプターの安全証憑未確認、CR2032への誤充電、市販RTCモジュールの差 | 型番のPSE等資料と現物ラベル、一次電池の非充電構成・逆流確認 | 電源/RTCの最終調達 |
| R11 | 高 | Nano互換機のUSBと外部5Vによる逆給電、MCU起動中の意図しないHV許可 | 実際の電源回路を確認し電源選択・初期OFFを設計、USBのみ/外部のみ/両方/リセット時を測定 | 初回通電手順の承認 |
| R12 | 中 | 実売価格の大半は未取得、送料・再試作・追加保護で予算超過 | 部品別見積、基板見積、構成変更をBOMへ反映。安全部品を削らず再計算 | 購入総額の確定 |
| R13 | 中 | KiCad 10.0.8導入/制御PCB検査済み。Arduino CLI未準備、Ubuntu実行未確認 | 導入版とヘルプ記録、両OSで読込/出力/ビルド。MCPは必要時に設定を案内 | Ubuntuでの再現とPhase 4ビルド |
| R14 | 中 | PDFの一部がHTTP拒否/証明書/通信問題でローカル取得不可 | 取得記録を確認し公式別経路または供給元から入手、TLS検証を無効化しない | 該当資料のオフライン照合 |
| R15 | 高 | ケース・基板は共通寸法で生成したが、実寸/公差/保持治具/カバー固定は未照合 | ソケット高さ、管窓とガラスの隙間、基板部品高さ、穴、背面部品、木材伸縮を実物と照合。`enclosure/layout.json` を更新し再検査 | ケース加工・外形と穴の凍結 |
| R16 | 高 | 木製ケース内の熱、通風、表示子/ハーネスの接触防止が未設計 | 温度測定、放熱・難燃材料・独立カバー、ストレインリリーフと保守時の接触確認 | 外装完成・通電状態での運用 |

## HV基板r1の進展

- R01：HV200V/18kΩを計算上の候補にした。維持電圧は未実測で未解決。
- R02：S03に基づき外付けクランプを回路/基板へ追加。型番未選定・ゴースト/電流未実測で未解決。
- R04：IN-12Bの候補フットプリントをS01図Aから作成。数字の上下とソケット寸法は未照合。
- R06：電源板はモジュール固定穴とハーネス接続に限定。出荷版/端子順/過渡は未照合。
- R08：HV-LV 2.5mm等をDRCへ定義したが、規格根拠のある絶縁距離ではない。Q4に端子間隔の例外あり。
- R15：コロン板拡大と電源板追加で共通寸法を更新。OpenSCADは未再実行、現物未照合。

## control-r1までの進展

- R04：54部品に候補フットプリントを割り当て、219パッドとネット、M3穴、RTC禁止領域を読戻し検査。現物未照合のため確定ではない。Keystone 1060極性/寸法、Nano互換の外形/電源、TO-92リード成形等は残る。
- R13：macOSで制御板のERC/DRC/未配線/回路図等価性の問題0。配線はFreerouting JVM、APIはKiCad付属Pythonを使用。保存記録は `docs/validation/`。Ubuntu・Arduinoは未実施。
- R15：制御PCB100×55mm/板厚1.6mm/穴4個をケース正本と照合。部品高さを含む3D干渉、保持具、現物公差は未検証。

## Phase 2初版時点の進展

- R13：KiCad 10.0.8を検出。CLIのERC/PDF/ネットリスト/BOM、付属Pythonのpcbnewによる機械基板の生成/読戻しを実行。Arduino開発環境とUbuntu実行は未確認なので項目全体は閉じない。
- R04/R15：共通JSONに管中心・外形・穴を記録し、OpenSCAD定数とKiCad外形の一致を検査した。寸法そのものの現物適合は未確認。
- R01/R02/R06：回路図にTBDと保留理由を記録。ERCで検出できない部品定格・保護条件は未解決のまま管理する。

## 購入・製造に向けた扱い

回路図の検討はOpen項目を明示して進められるが、未確認端子を仮の番号で配線しない。既製モジュールが変われば周辺電源・EN・コネクター・フットプリントを再評価する。

部品購入の前に少なくとも管/ソケット、MCU、JJY、HVモジュールの個別販売品を特定する。大量購入ではなく現物照合用の少数サンプルから進める。基板発注と試作通電は別の判定で、Openな高重要度項目を自動的に承認扱いにしない。
