nexus4812/nixie-jjy-clock/docs/validation/2026-11-08/schematic.pdf

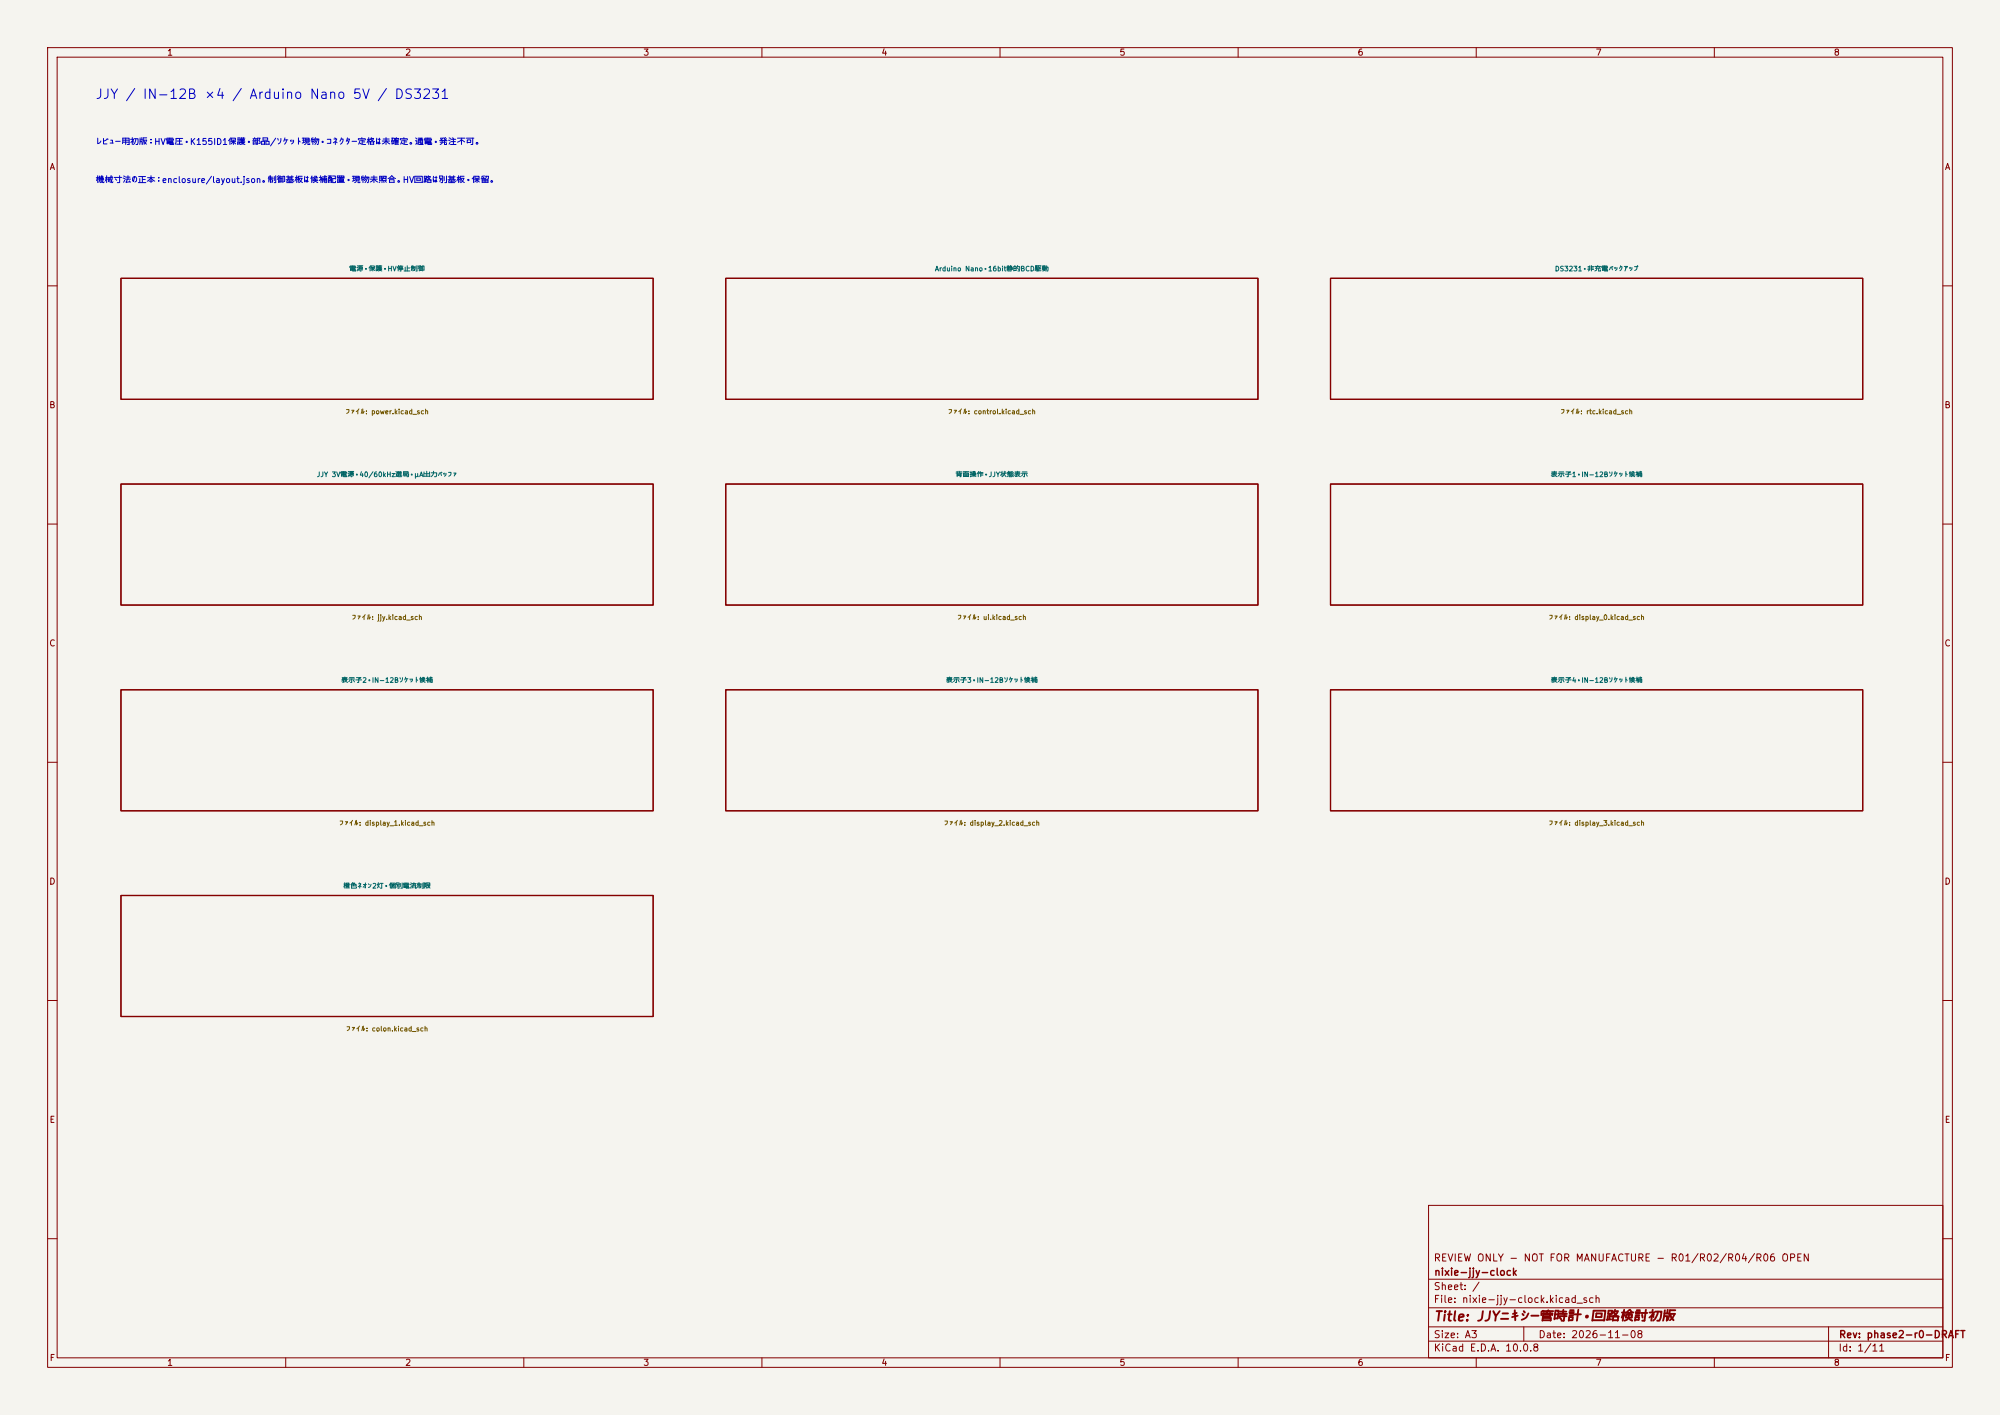
[picture p2: page 1]

JJY / IN-12B ×4 / Arduino Nano 5V / DS3231

レビュー用初版：HV電圧・K155ID1保護・部品/ソケット現物・コネクター定格は未確定。通電・発注不可。

機械寸法の正本：enclosure/layout.json。制御基板は候補配置・現物未照合。HV回路は別基板・保留。

ファイル: rtc.kicad_sch 背面操作・JJY状態表示

REVIEW ONLY - NOT FOR MANUFACTURE - R01/R02/R04/R06 OPEN
nixie-jjy-clock
Sheet: /
File: nixie-jjy-clock.kicad_sch
Title: JJYニキシー管時計・回路検討初版

F Date: 2026-11-08

KiCad E.D.A. 10.0.8 | Id: 1/11

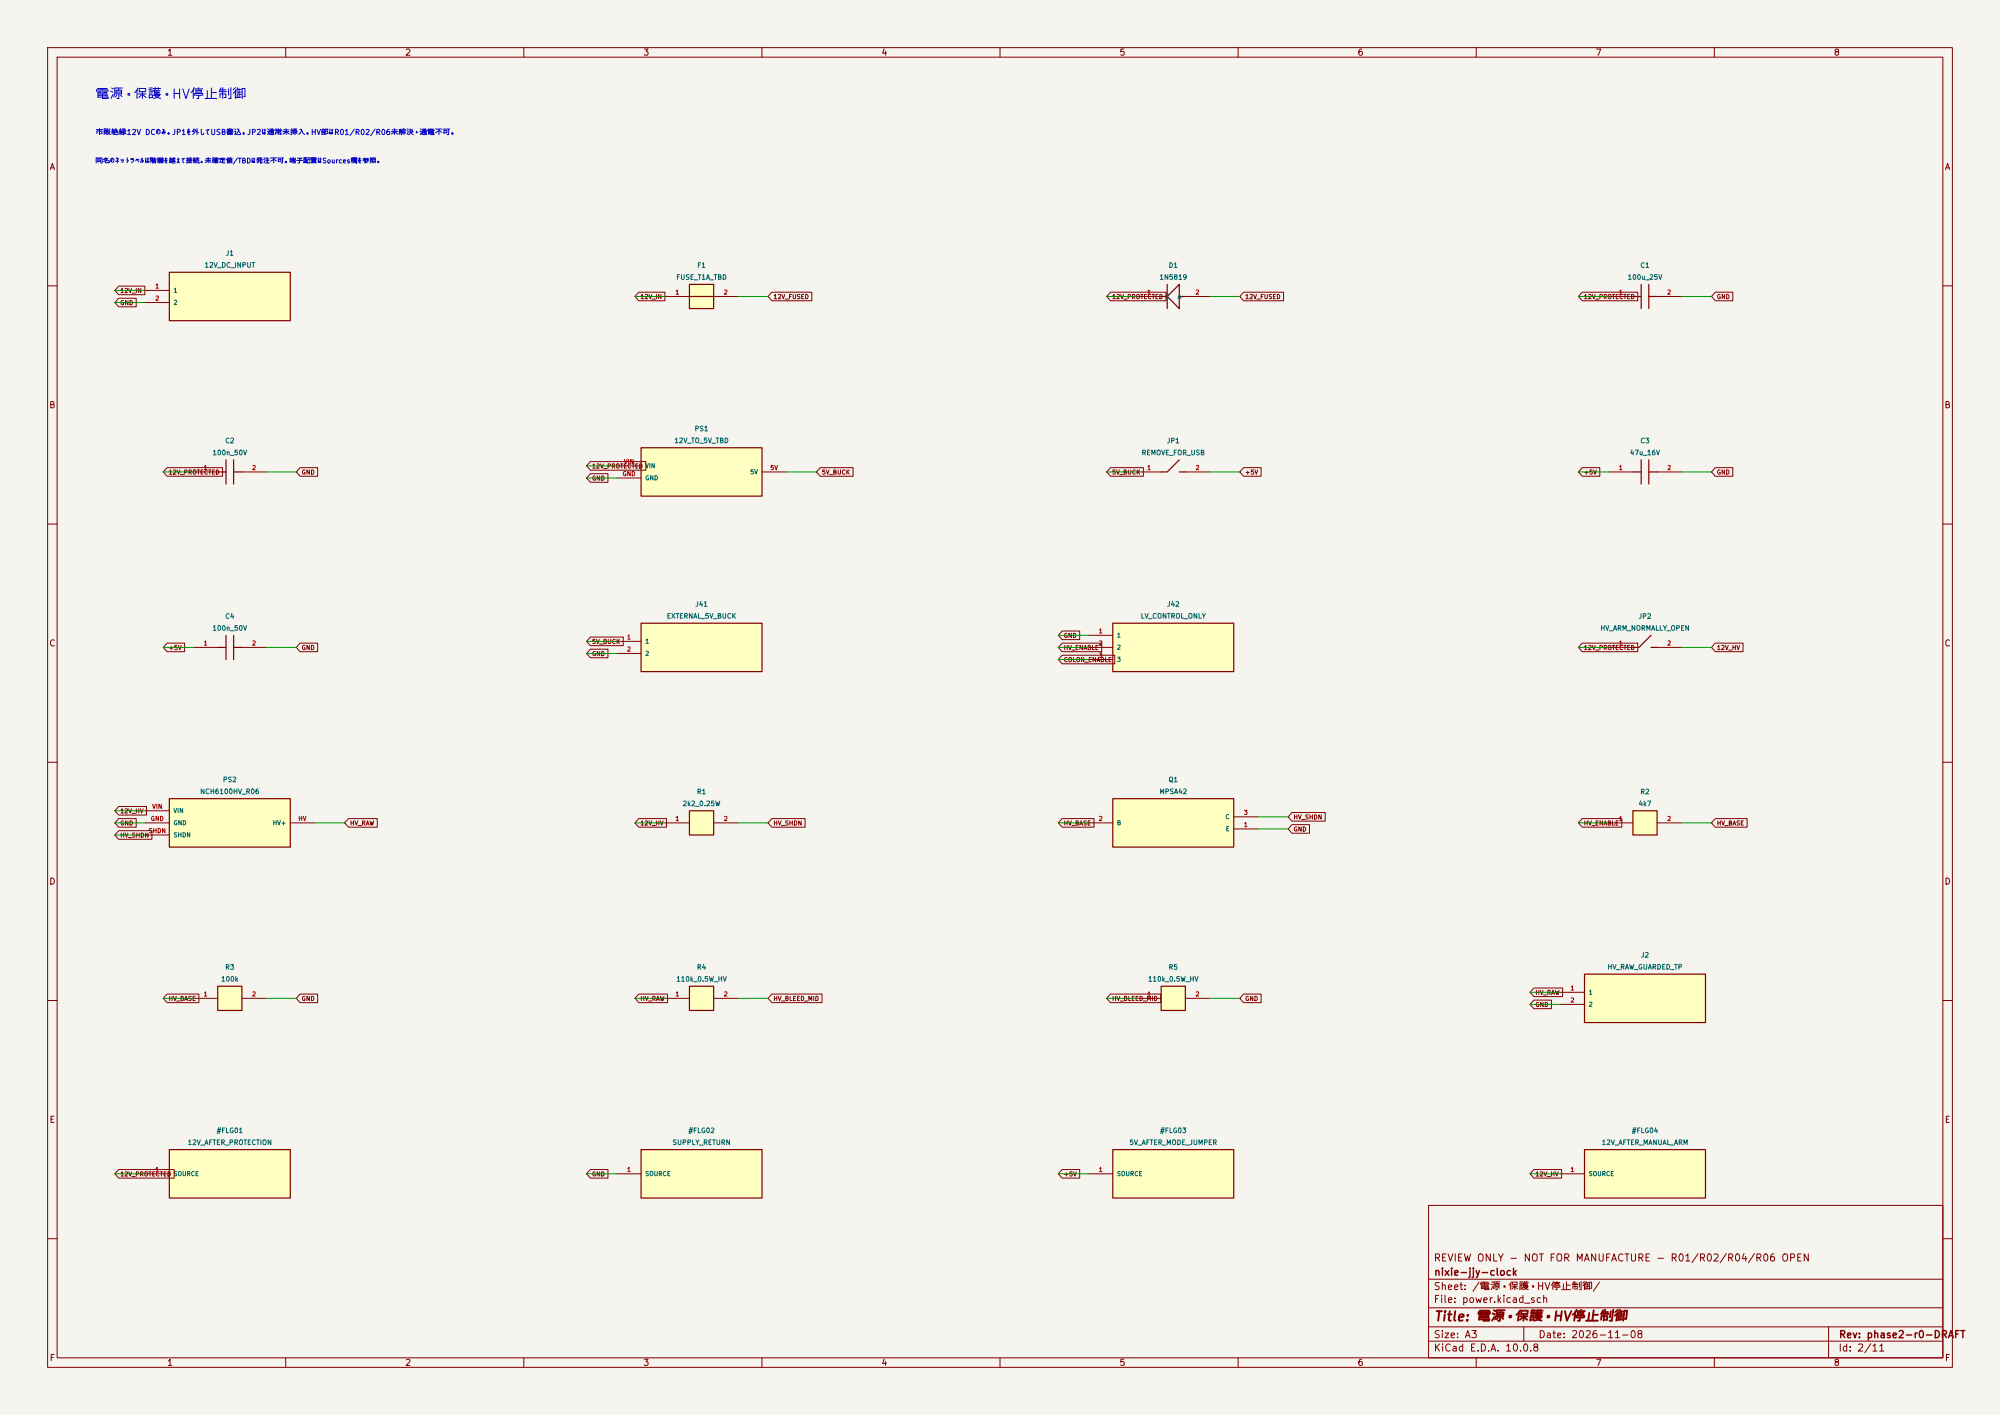
[picture p3: page 2]

市販絶縁12V DCのみ。JP1を外してUSB書込。JP2は通常未挿入。HV部はR01/R02/R06未解決・通電不可。 同名のネットラベルは階層を越えて接続。未確定値/TBDは発注不可。端子配置はSources欄を参照。 電源・保護・HV停止制御

REVIEW ONLY - NOT FOR MANUFACTURE - R01/R02/R04/R06 OPEN
nixie-jjy-clock
Sheet: /電源・保護・HV停止制御/
File: power.kicad_sch
Title: 電源・保護・HV停止制御

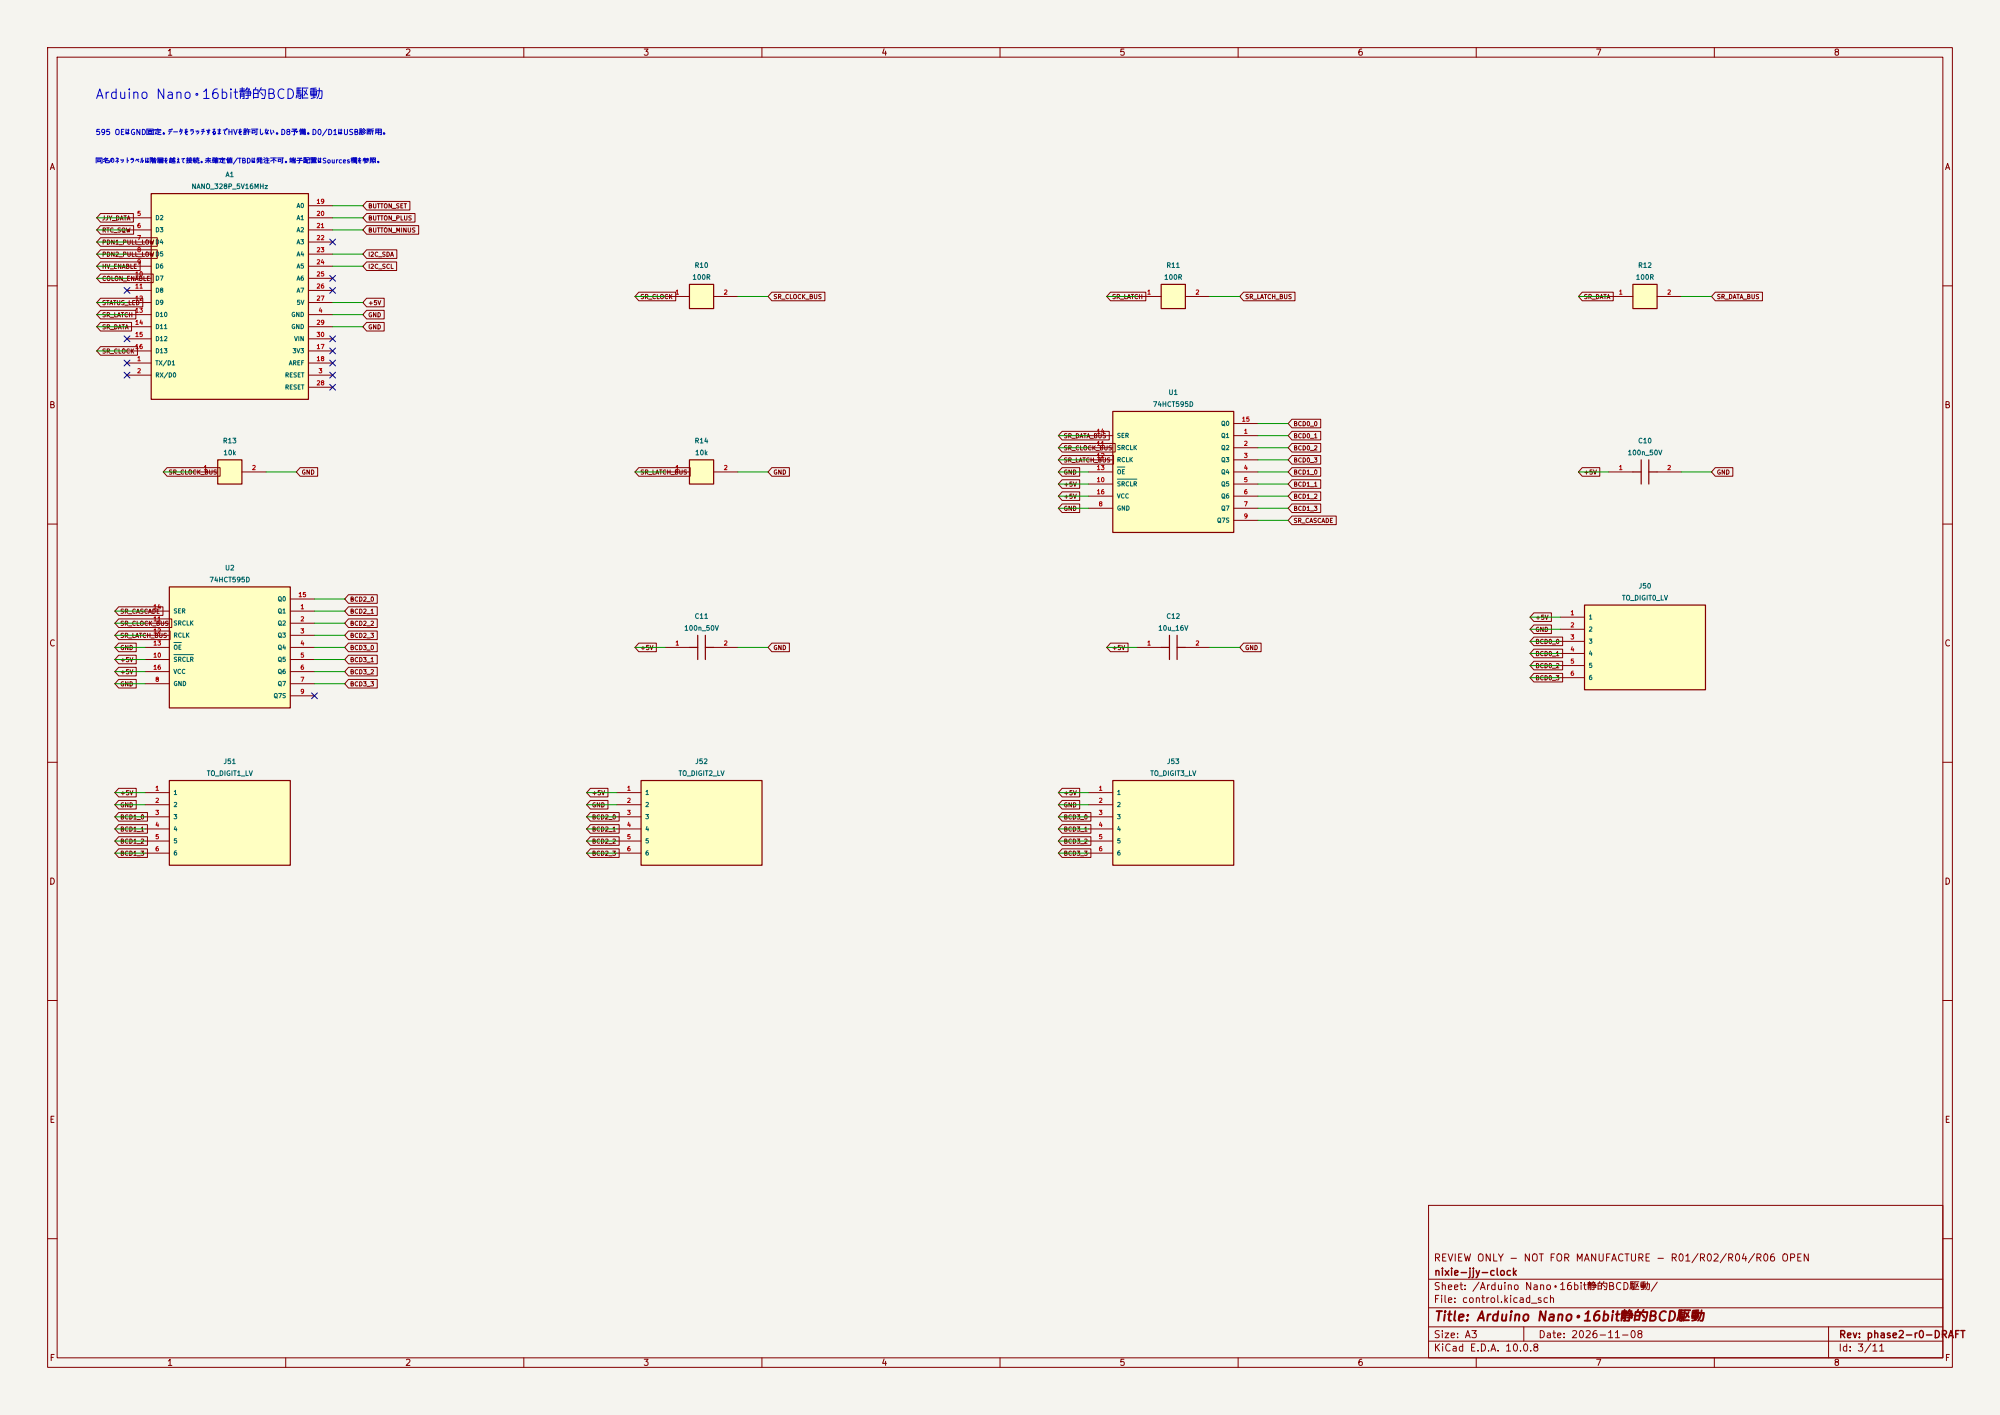
[picture p4: page 3]

SR_LATCH_BUS BCD0_1 HV_ENABLE 同名のネットラベルは階層を越えて接続。未確定値/TBDは発注不可。端子配置はSources欄を参照。

REVIEW ONLY - NOT FOR MANUFACTURE - R01/R02/R04/R06 OPEN
nixie-jjy-clock
Sheet: /Arduino Nano・16bit静的BCD駆動/
File: control.kicad_sch
Title: Arduino Nano・16bit静的BCD駆動

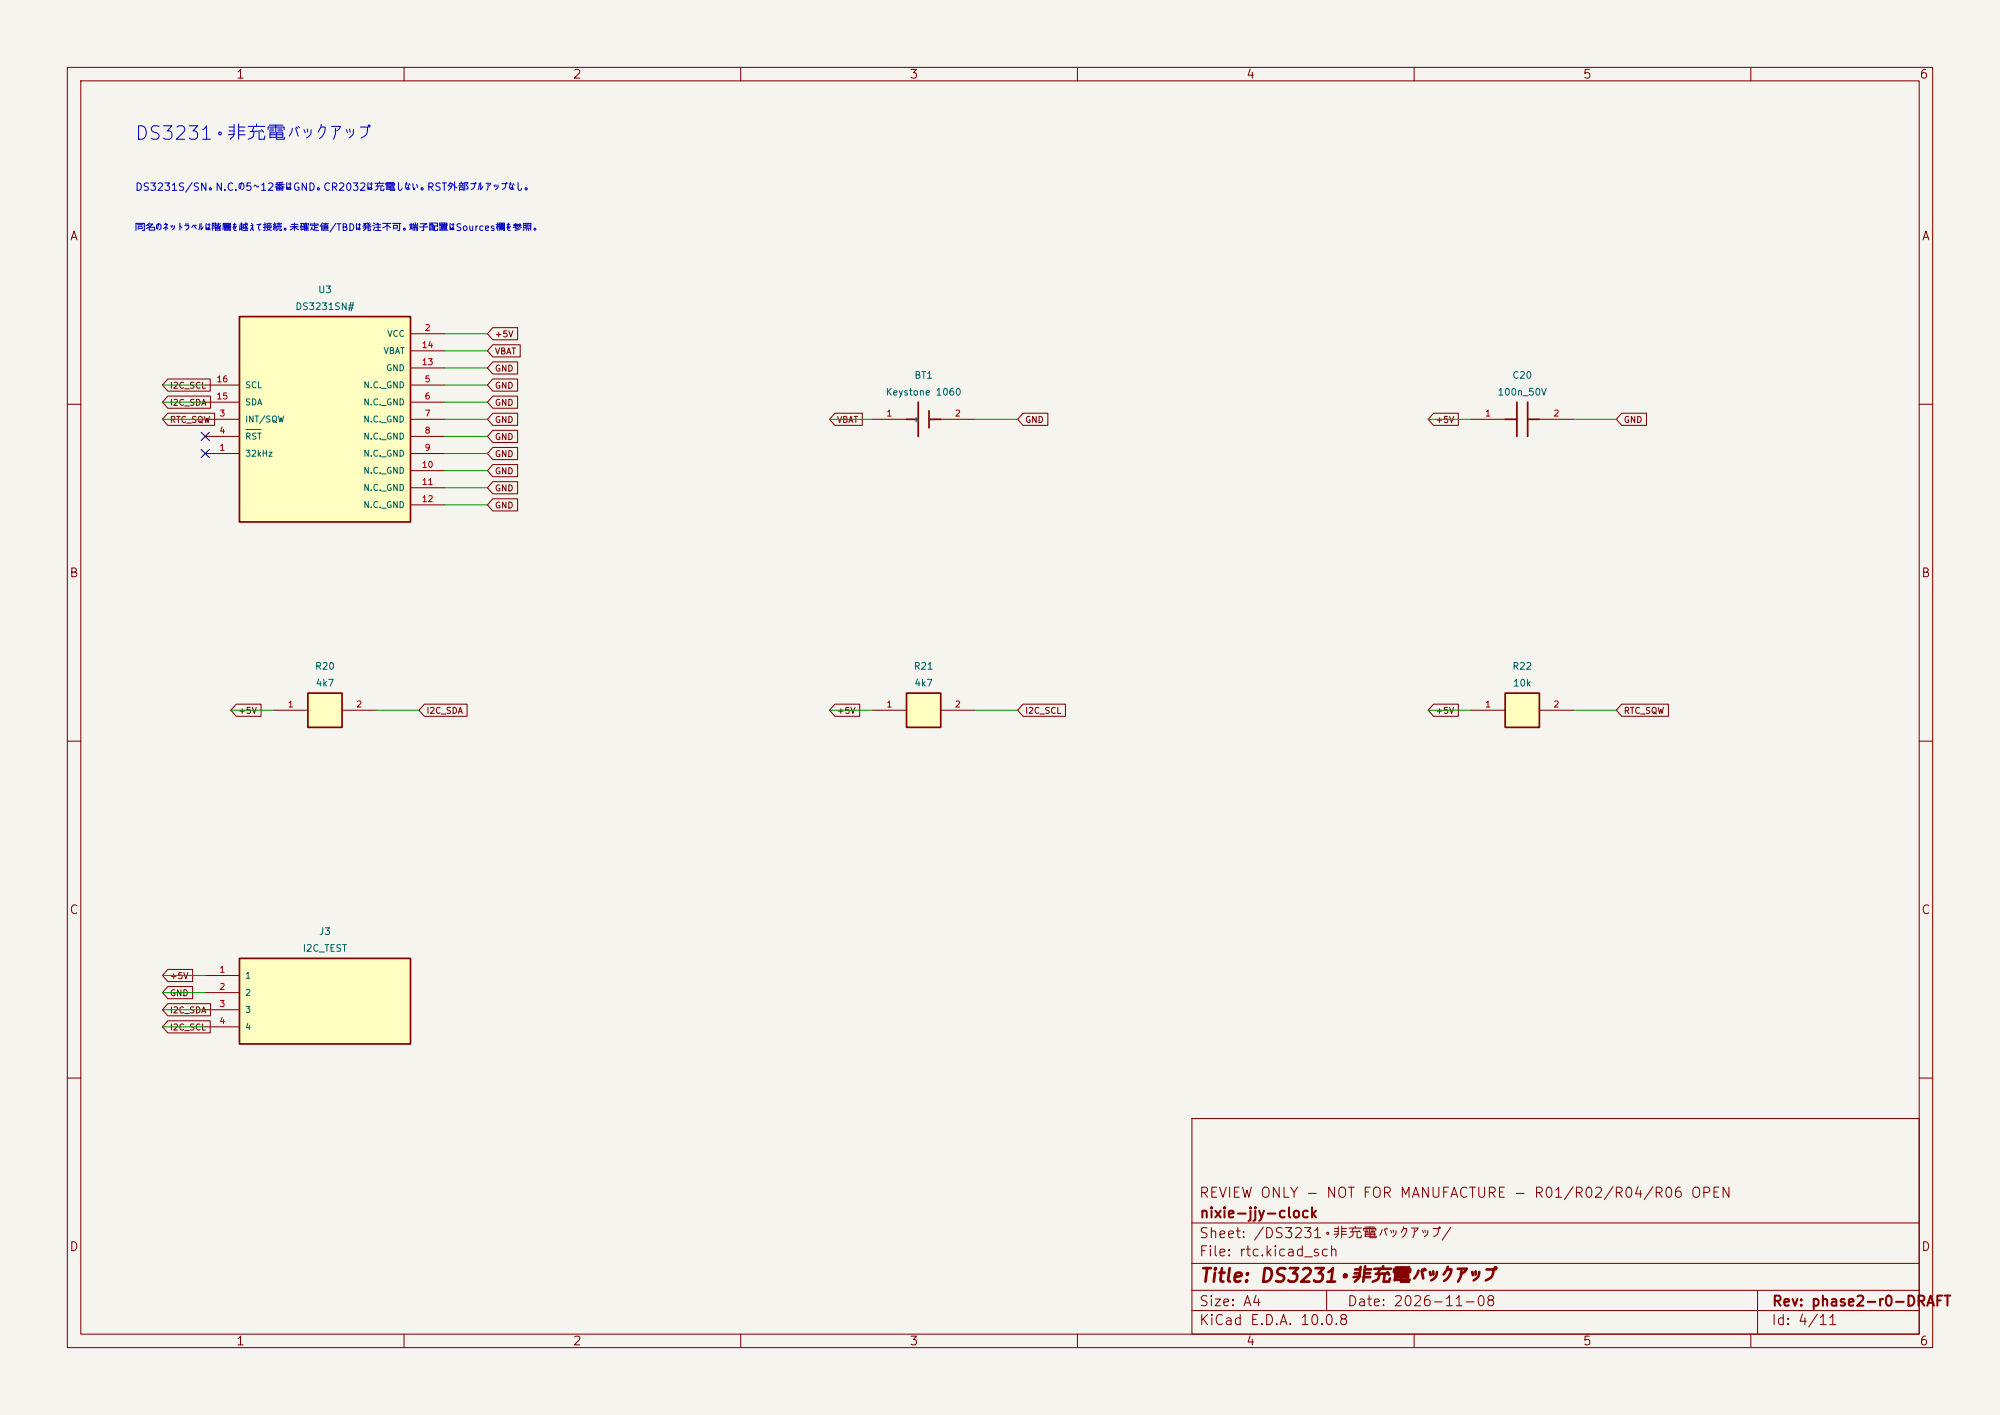
[picture p5: page 4]

REVIEW ONLY - NOT FOR MANUFACTURE - R01/R02/R04/R06 OPEN
nixie-jjy-clock
Sheet: /DS3231・非充電バックアップ/
File: rtc.kicad_sch
Title: DS3231・非充電バックアップ

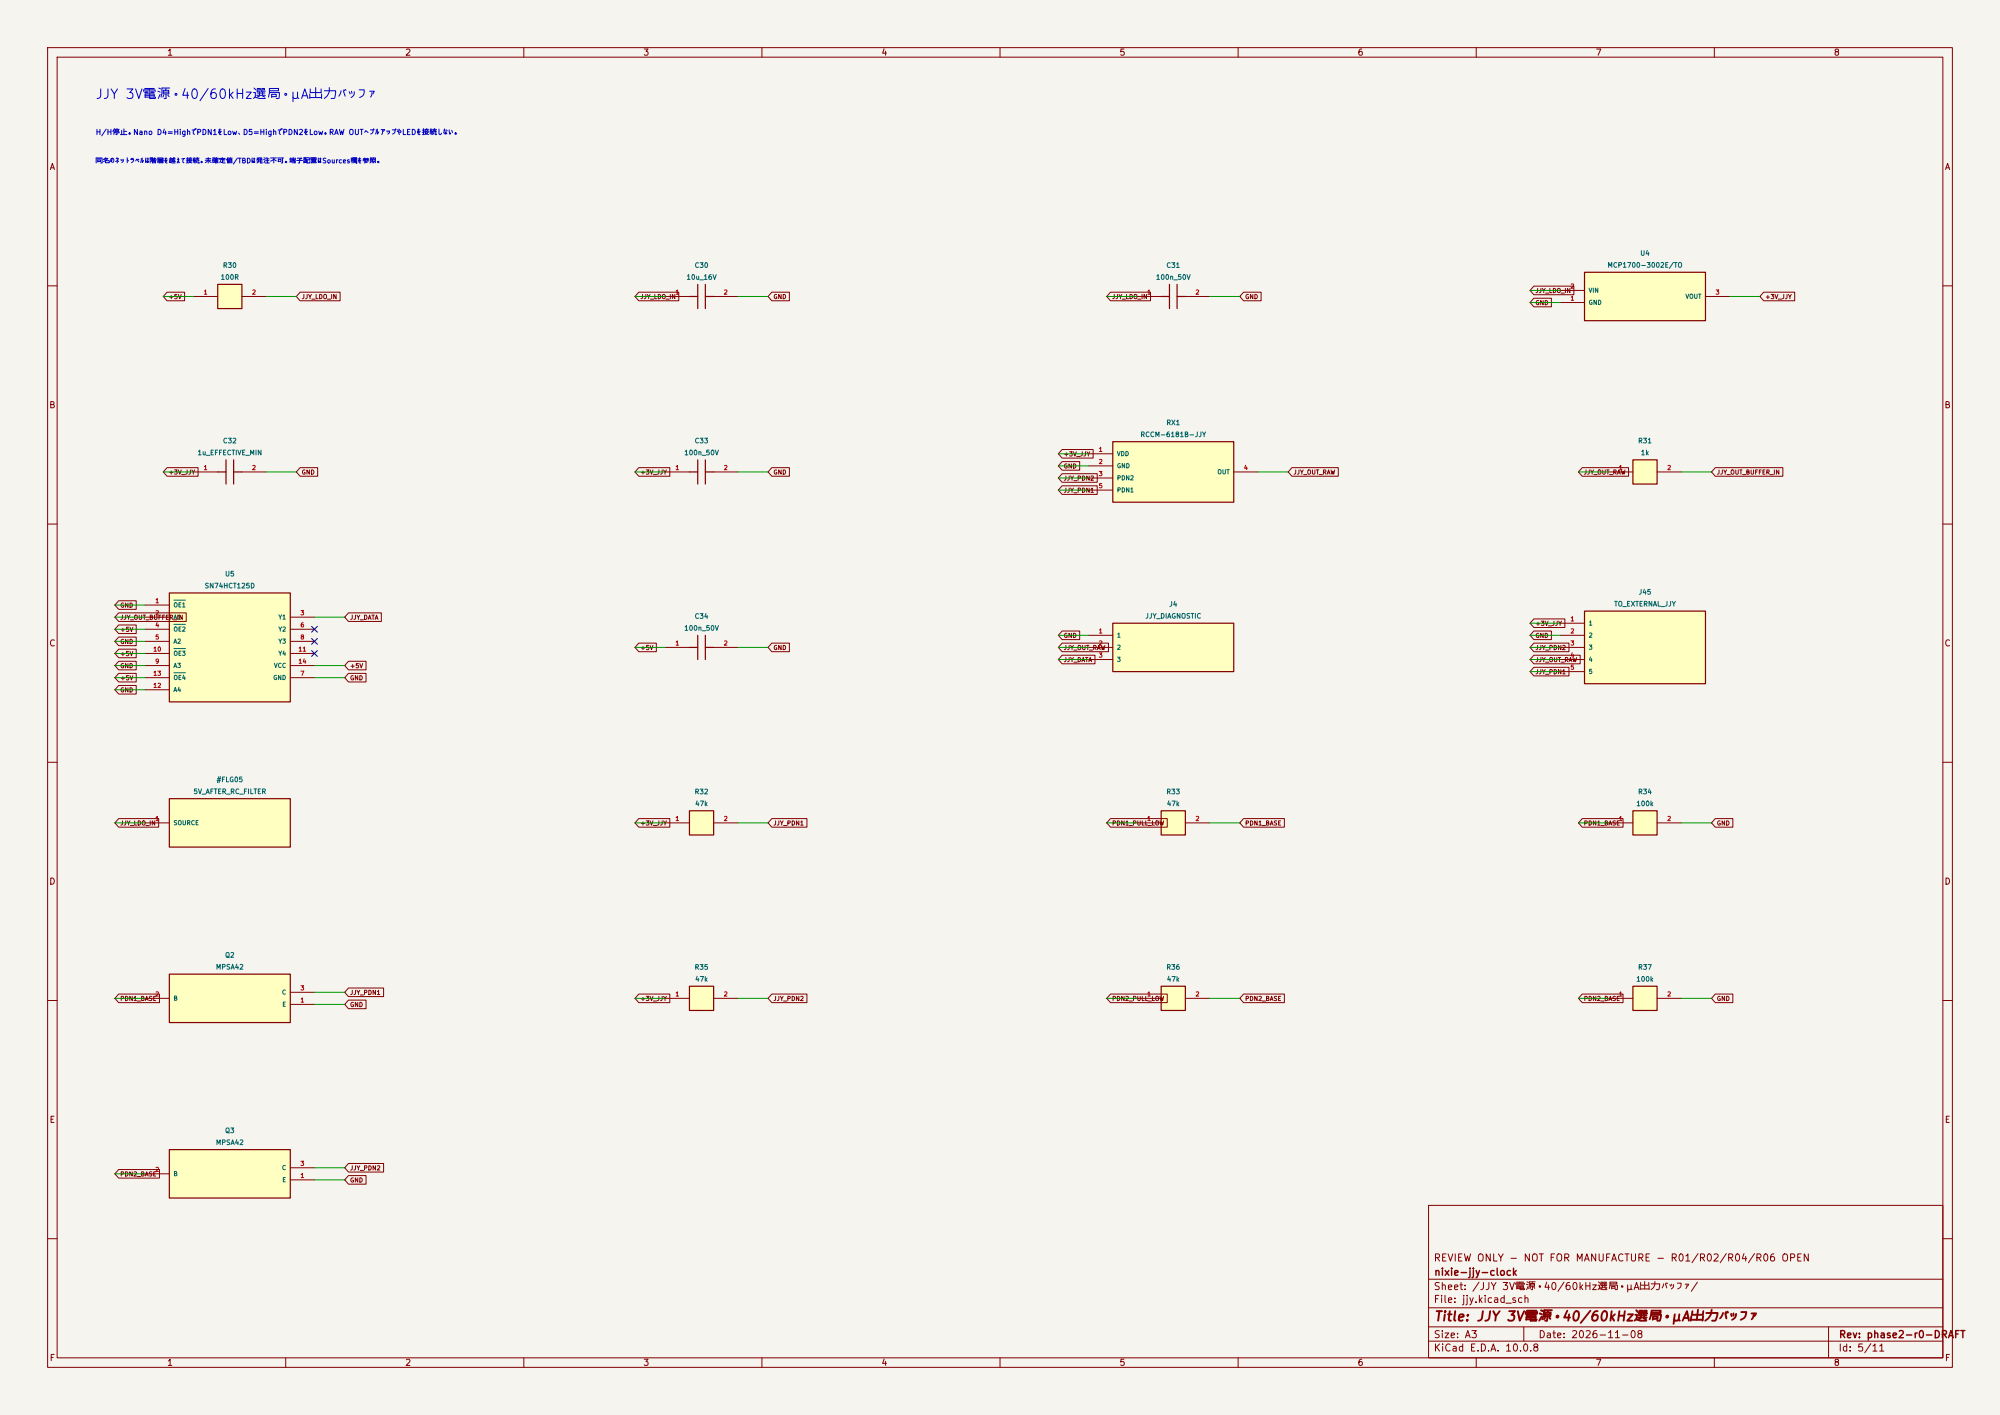
[picture p6: page 5]

同名のネットラベルは階層を越えて接続。未確定値/TBDは発注不可。端子配置はSources欄を参照。 H/H停止。Nano D4=HighでPDN1をLow、D5=HighでPDN2をLow。RAW OUTへプルアップやLEDを接続しない。 JJY 3V電源・40/60kHz選局・µA出力バッファ

REVIEW ONLY - NOT FOR MANUFACTURE - R01/R02/R04/R06 OPEN
nixie-jjy-clock
Sheet: /JJY 3V電源・40/60kHz選局・µA出力バッファ/
File: jjy.kicad_sch
Title: JJY 3V電源・40/60kHz選局・µA出力バッファ

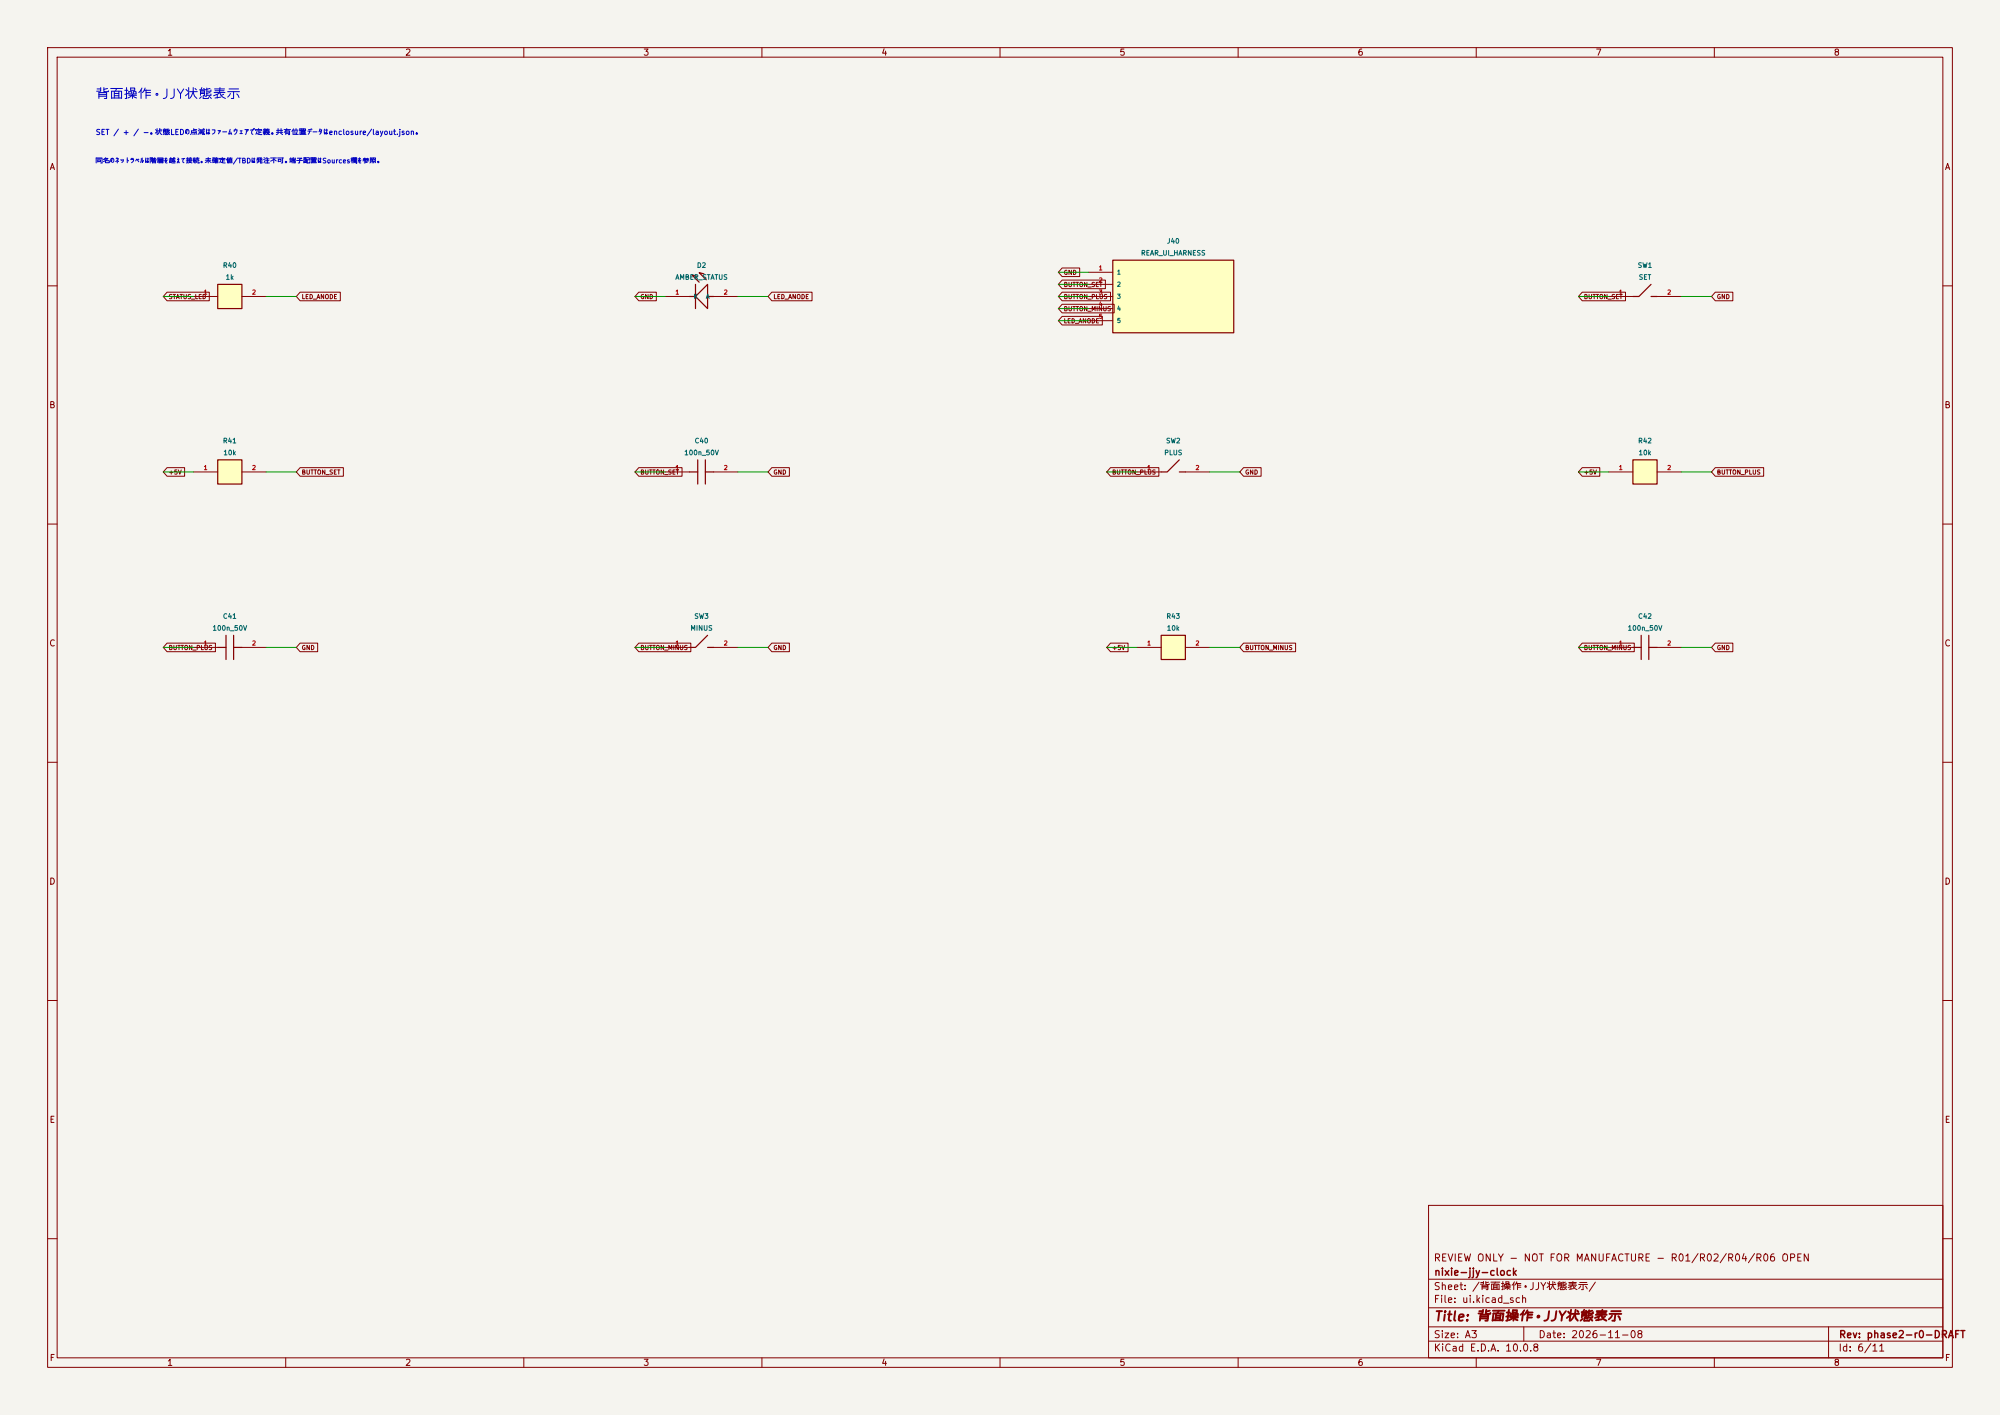
[picture p7: page 6]

LED_ANODE GND SET / + / -。状態LEDの点滅はファームウェアで定義。共有位置データはenclosure/layout.json。 同名のネットラベルは階層を越えて接続。未確定値/TBDは発注不可。端子配置はSources欄を参照。 背面操作・JJY状態表示

REVIEW ONLY - NOT FOR MANUFACTURE - R01/R02/R04/R06 OPEN
nixie-jjy-clock
Sheet: /背面操作・JJY状態表示/
File: ui.kicad_sch
Title: 背面操作・JJY状態表示

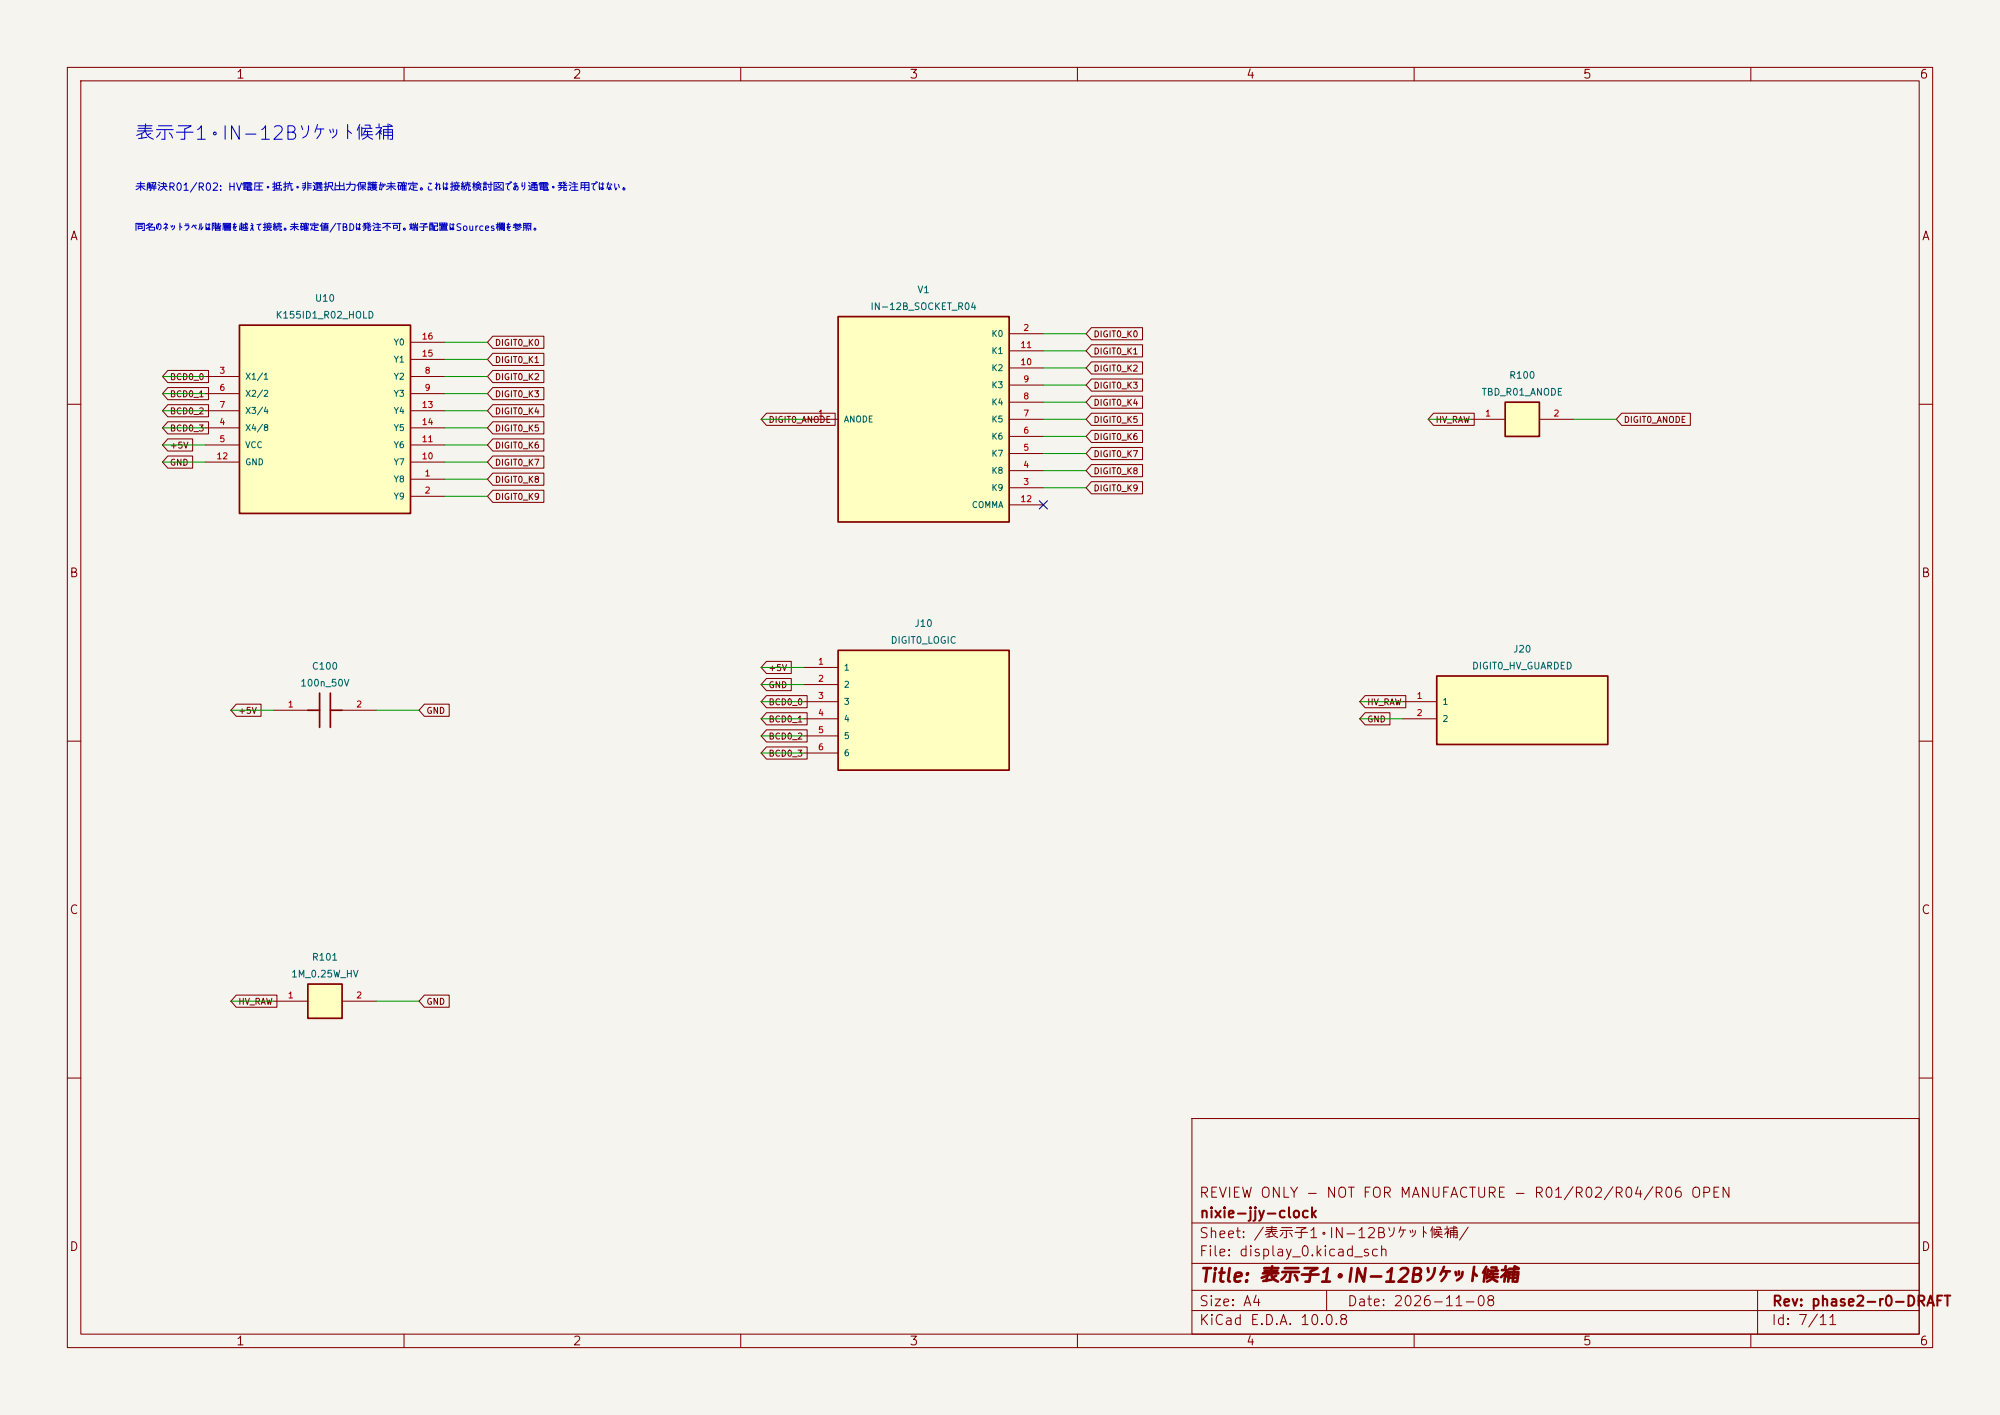
[picture p8: page 7]

BCD0_1 同名のネットラベルは階層を越えて接続。未確定値/TBDは発注不可。端子配置はSources欄を参照。 未解決R01/R02: HV電圧・抵抗・非選択出力保護が未確定。これは接続検討図であり通電・発注用ではない。 表示子1・IN-12Bソケット候補

REVIEW ONLY - NOT FOR MANUFACTURE - R01/R02/R04/R06 OPEN
nixie-jjy-clock
Sheet: /表示子1・IN-12Bソケット候補/
File: display_0.kicad_sch
Title: 表示子1・IN-12Bソケット候補

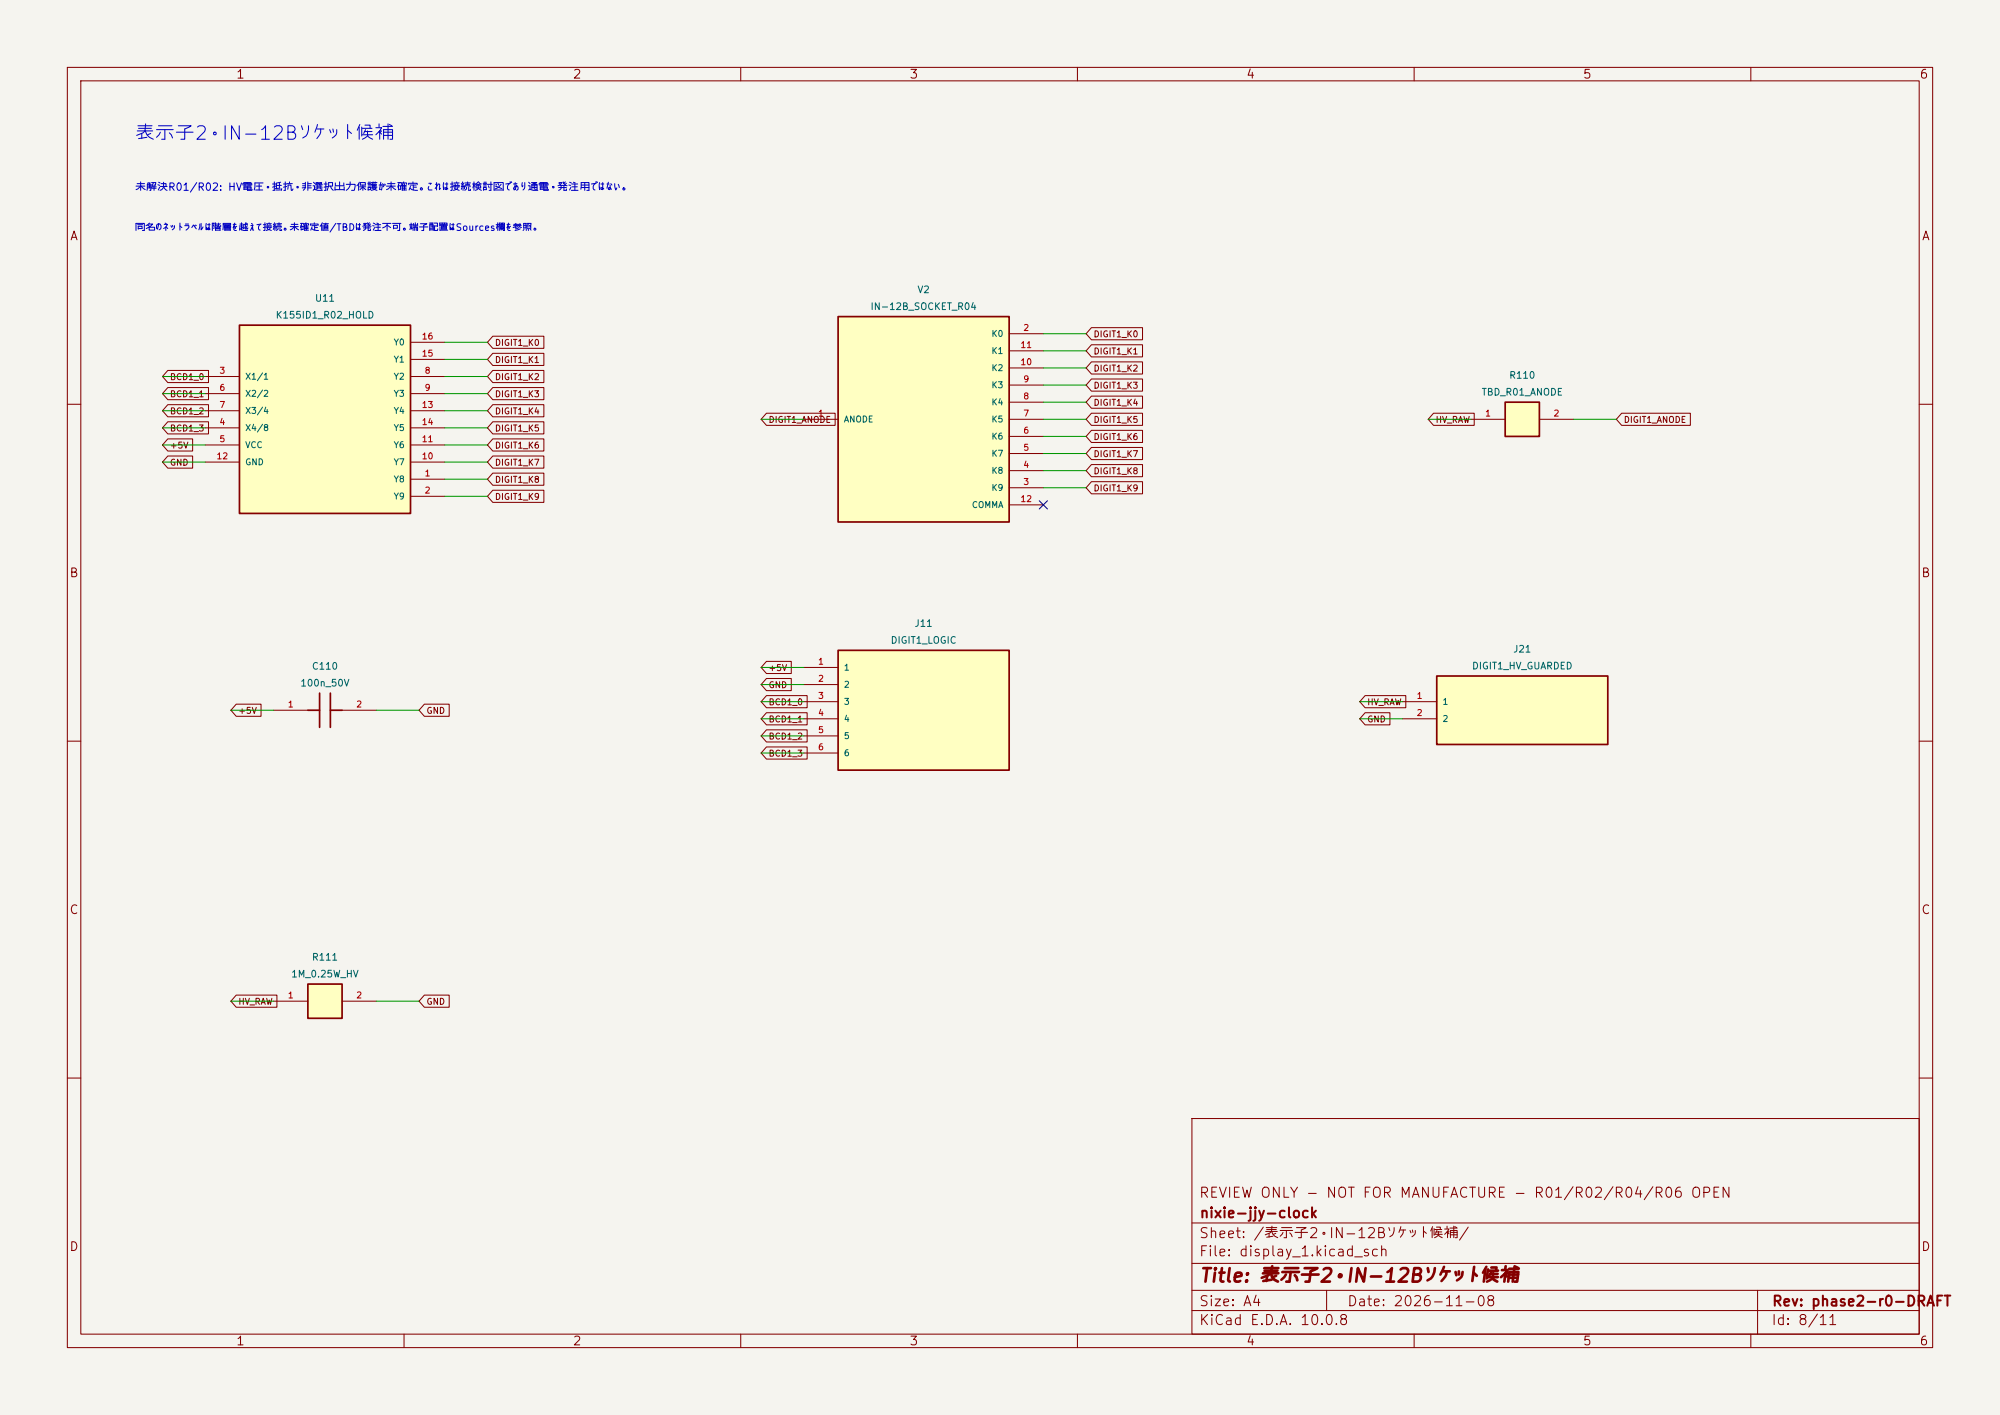
[picture p9: page 8]

BCD1_1 同名のネットラベルは階層を越えて接続。未確定値/TBDは発注不可。端子配置はSources欄を参照。 未解決R01/R02: HV電圧・抵抗・非選択出力保護が未確定。これは接続検討図であり通電・発注用ではない。 表示子2・IN-12Bソケット候補

REVIEW ONLY - NOT FOR MANUFACTURE - R01/R02/R04/R06 OPEN
nixie-jjy-clock
Sheet: /表示子2・IN-12Bソケット候補/
File: display_1.kicad_sch
Title: 表示子2・IN-12Bソケット候補

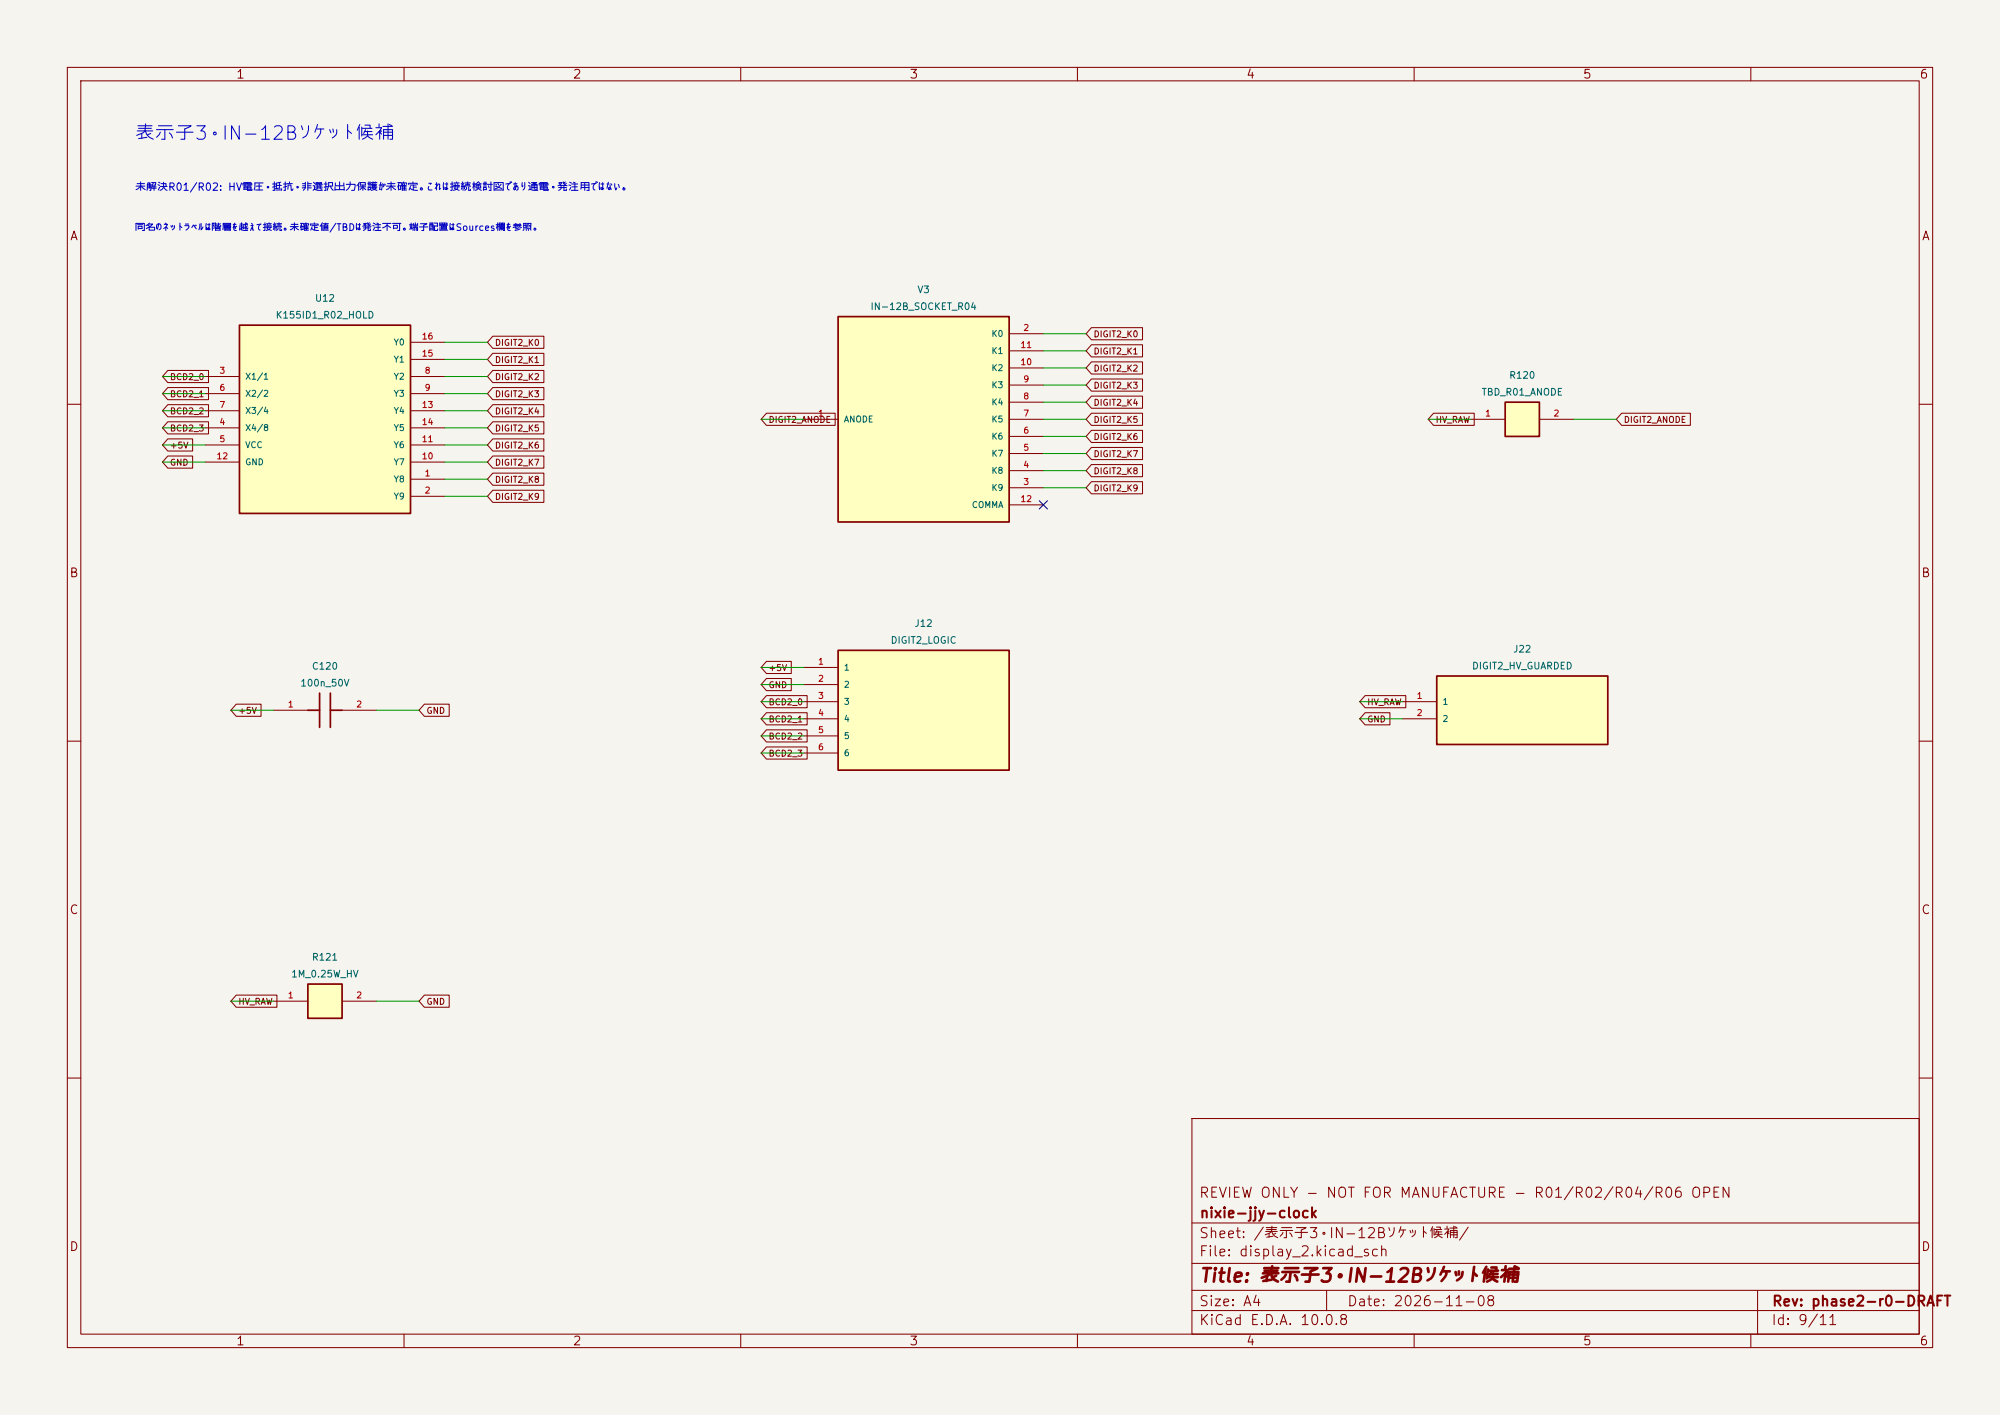
[picture p10: page 9]

BCD2_1 同名のネットラベルは階層を越えて接続。未確定値/TBDは発注不可。端子配置はSources欄を参照。 未解決R01/R02: HV電圧・抵抗・非選択出力保護が未確定。これは接続検討図であり通電・発注用ではない。 表示子3・IN-12Bソケット候補

REVIEW ONLY - NOT FOR MANUFACTURE - R01/R02/R04/R06 OPEN
nixie-jjy-clock
Sheet: /表示子3・IN-12Bソケット候補/
File: display_2.kicad_sch
Title: 表示子3・IN-12Bソケット候補

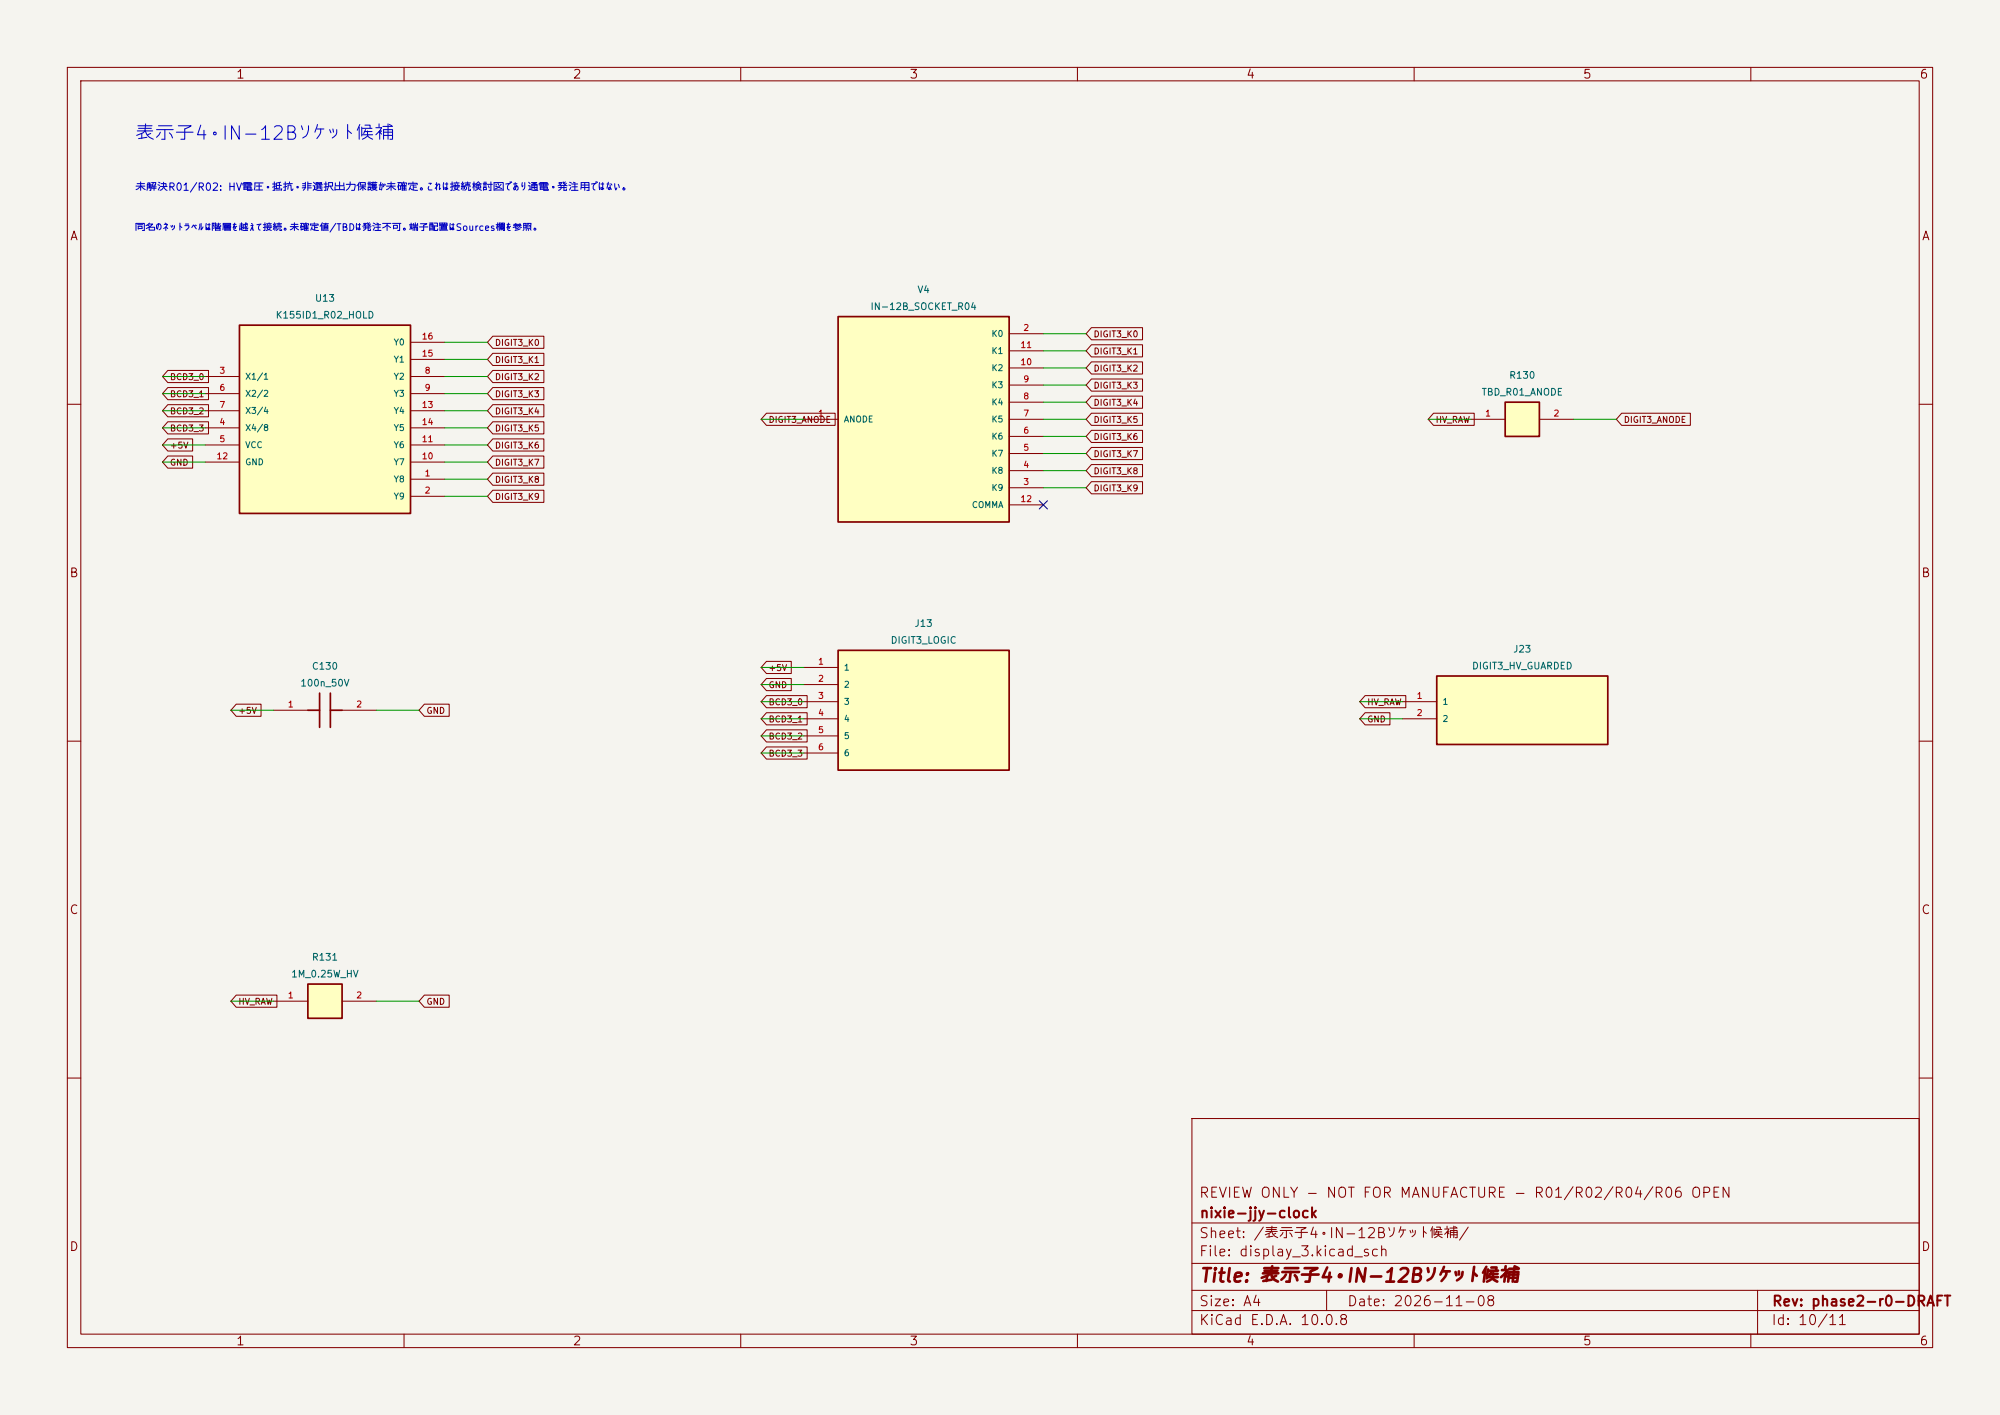
[picture p11: page 10]

BCD3_1 同名のネットラベルは階層を越えて接続。未確定値/TBDは発注不可。端子配置はSources欄を参照。 未解決R01/R02: HV電圧・抵抗・非選択出力保護が未確定。これは接続検討図であり通電・発注用ではない。 表示子4・IN-12Bソケット候補

REVIEW ONLY - NOT FOR MANUFACTURE - R01/R02/R04/R06 OPEN
nixie-jjy-clock
Sheet: /表示子4・IN-12Bソケット候補/
File: display_3.kicad_sch
Title: 表示子4・IN-12Bソケット候補

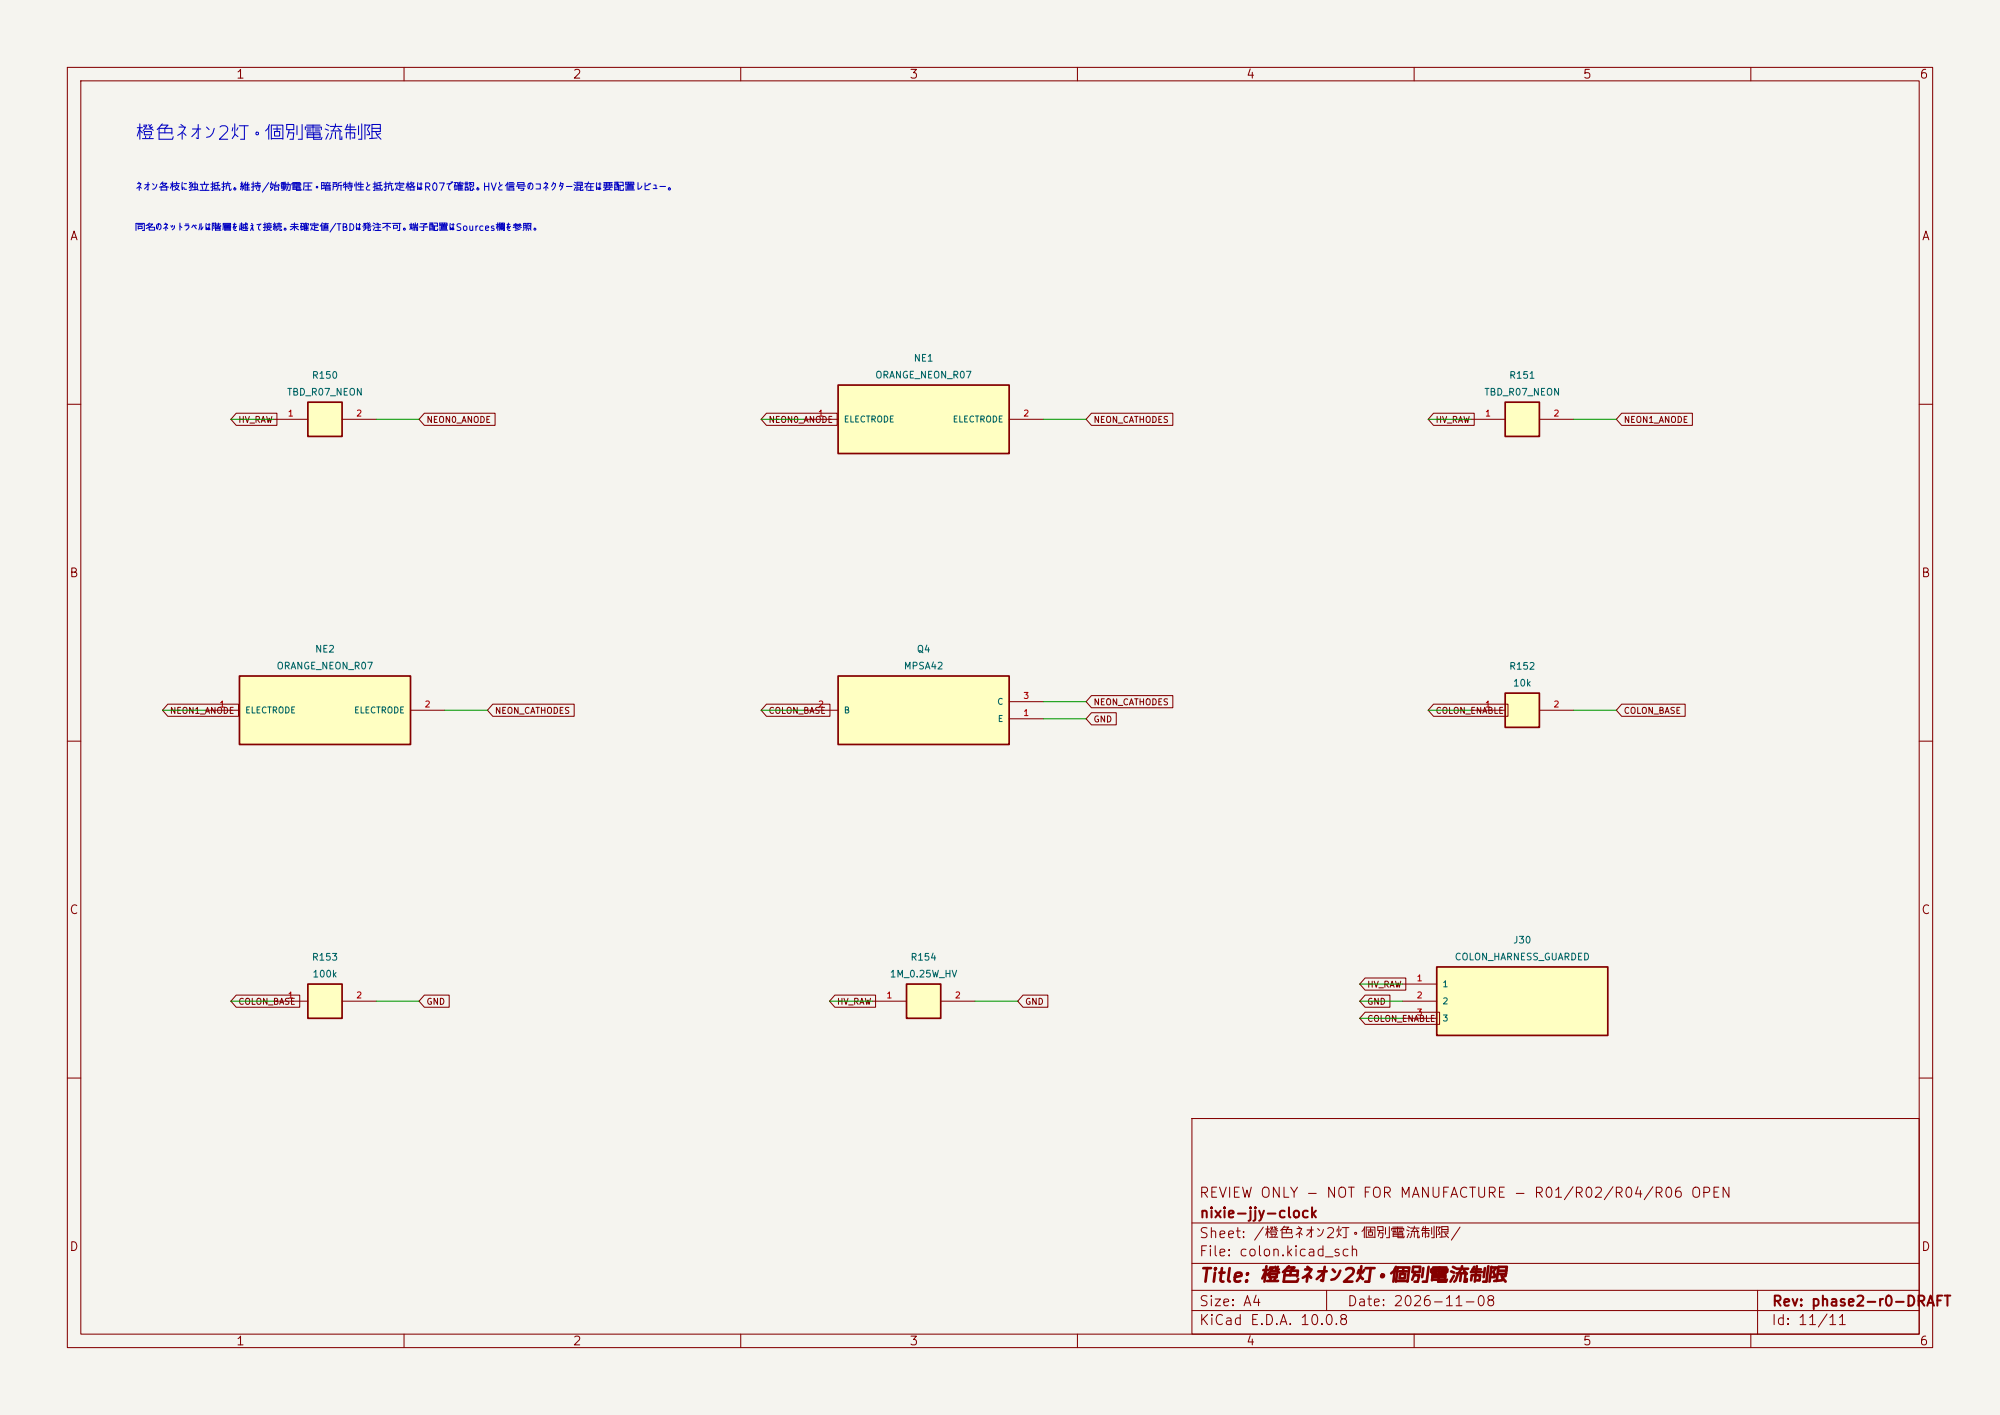
[picture p12: page 11]

NEON0_ANODE COLON_BASE 同名のネットラベルは階層を越えて接続。未確定値/TBDは発注不可。端子配置はSources欄を参照。 ネオン各枝に独立抵抗。維持/始動電圧・暗所特性と抵抗定格はR07で確認。HVと信号のコネクター混在は要配置レビュー。

REVIEW ONLY - NOT FOR MANUFACTURE - R01/R02/R04/R06 OPEN
nixie-jjy-clock
Sheet: /橙色ネオン2灯・個別電流制限/
File: colon.kicad_sch
Title: 橙色ネオン2灯・個別電流制限
