nexus4812/nixie-jjy-clock/(list of files, drawings)

Other design files:
hardware/pcb/generated/routing/control-board.dsn
hardware/pcb/generated_colon/routing/colon-board.dsn
hardware/pcb/generated_display/routing/display-board.dsn
hardware/pcb/generated_power/routing/power-board.dsn
