nexus4812/nixie-jjy-clock/hardware/pcb/generated_colon/colon-board.kicad_pcb

## KiCad design hardware/pcb/generated_colon/colon-board.kicad_pcb (2026-11-08)

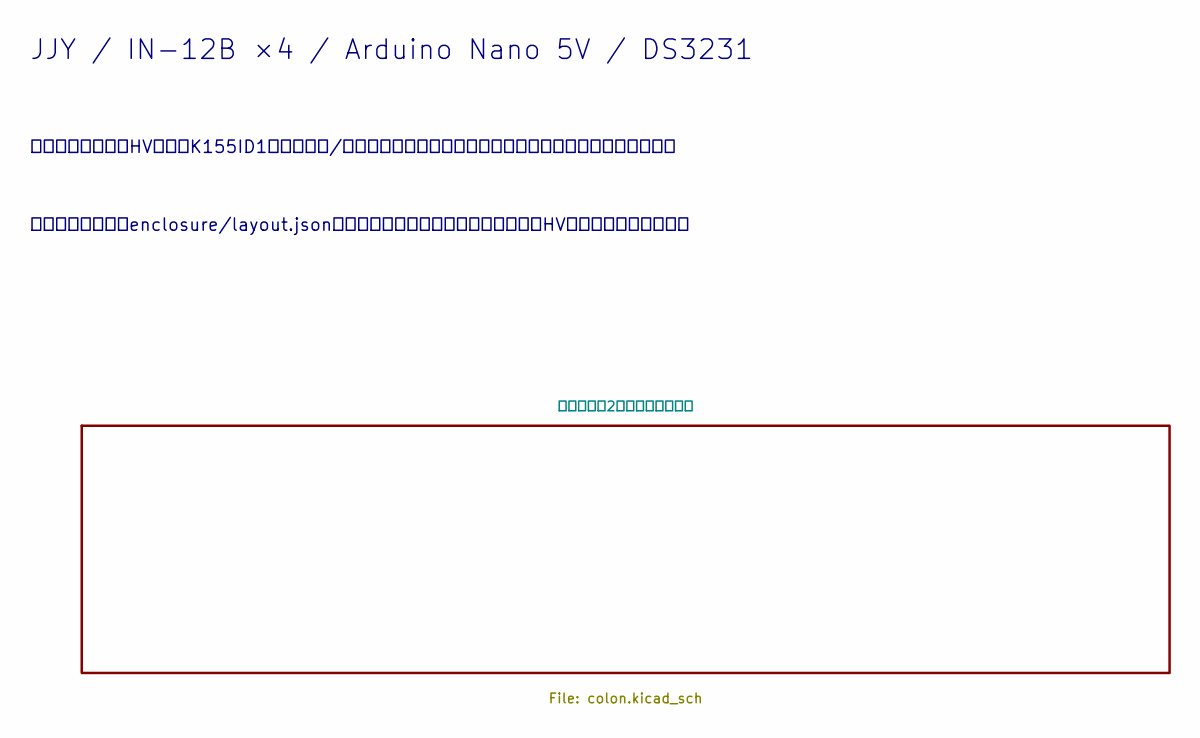
[picture p17: schematic colon-board.kicad_sch, JJYニキシー管時計・回路検討初版]

Notes on the sheet:
JJY / IN-12B ×4 / Arduino Nano 5V / DS3231
レビュー用初版：HV電圧・K155ID1保護・部品/ソケット現物・コネクター定格は未確定。通電・発注不可。
機械寸法の正本：enclosure/layout.json。制御基板は候補配置・現物未照合。HV回路は別基板・保留。

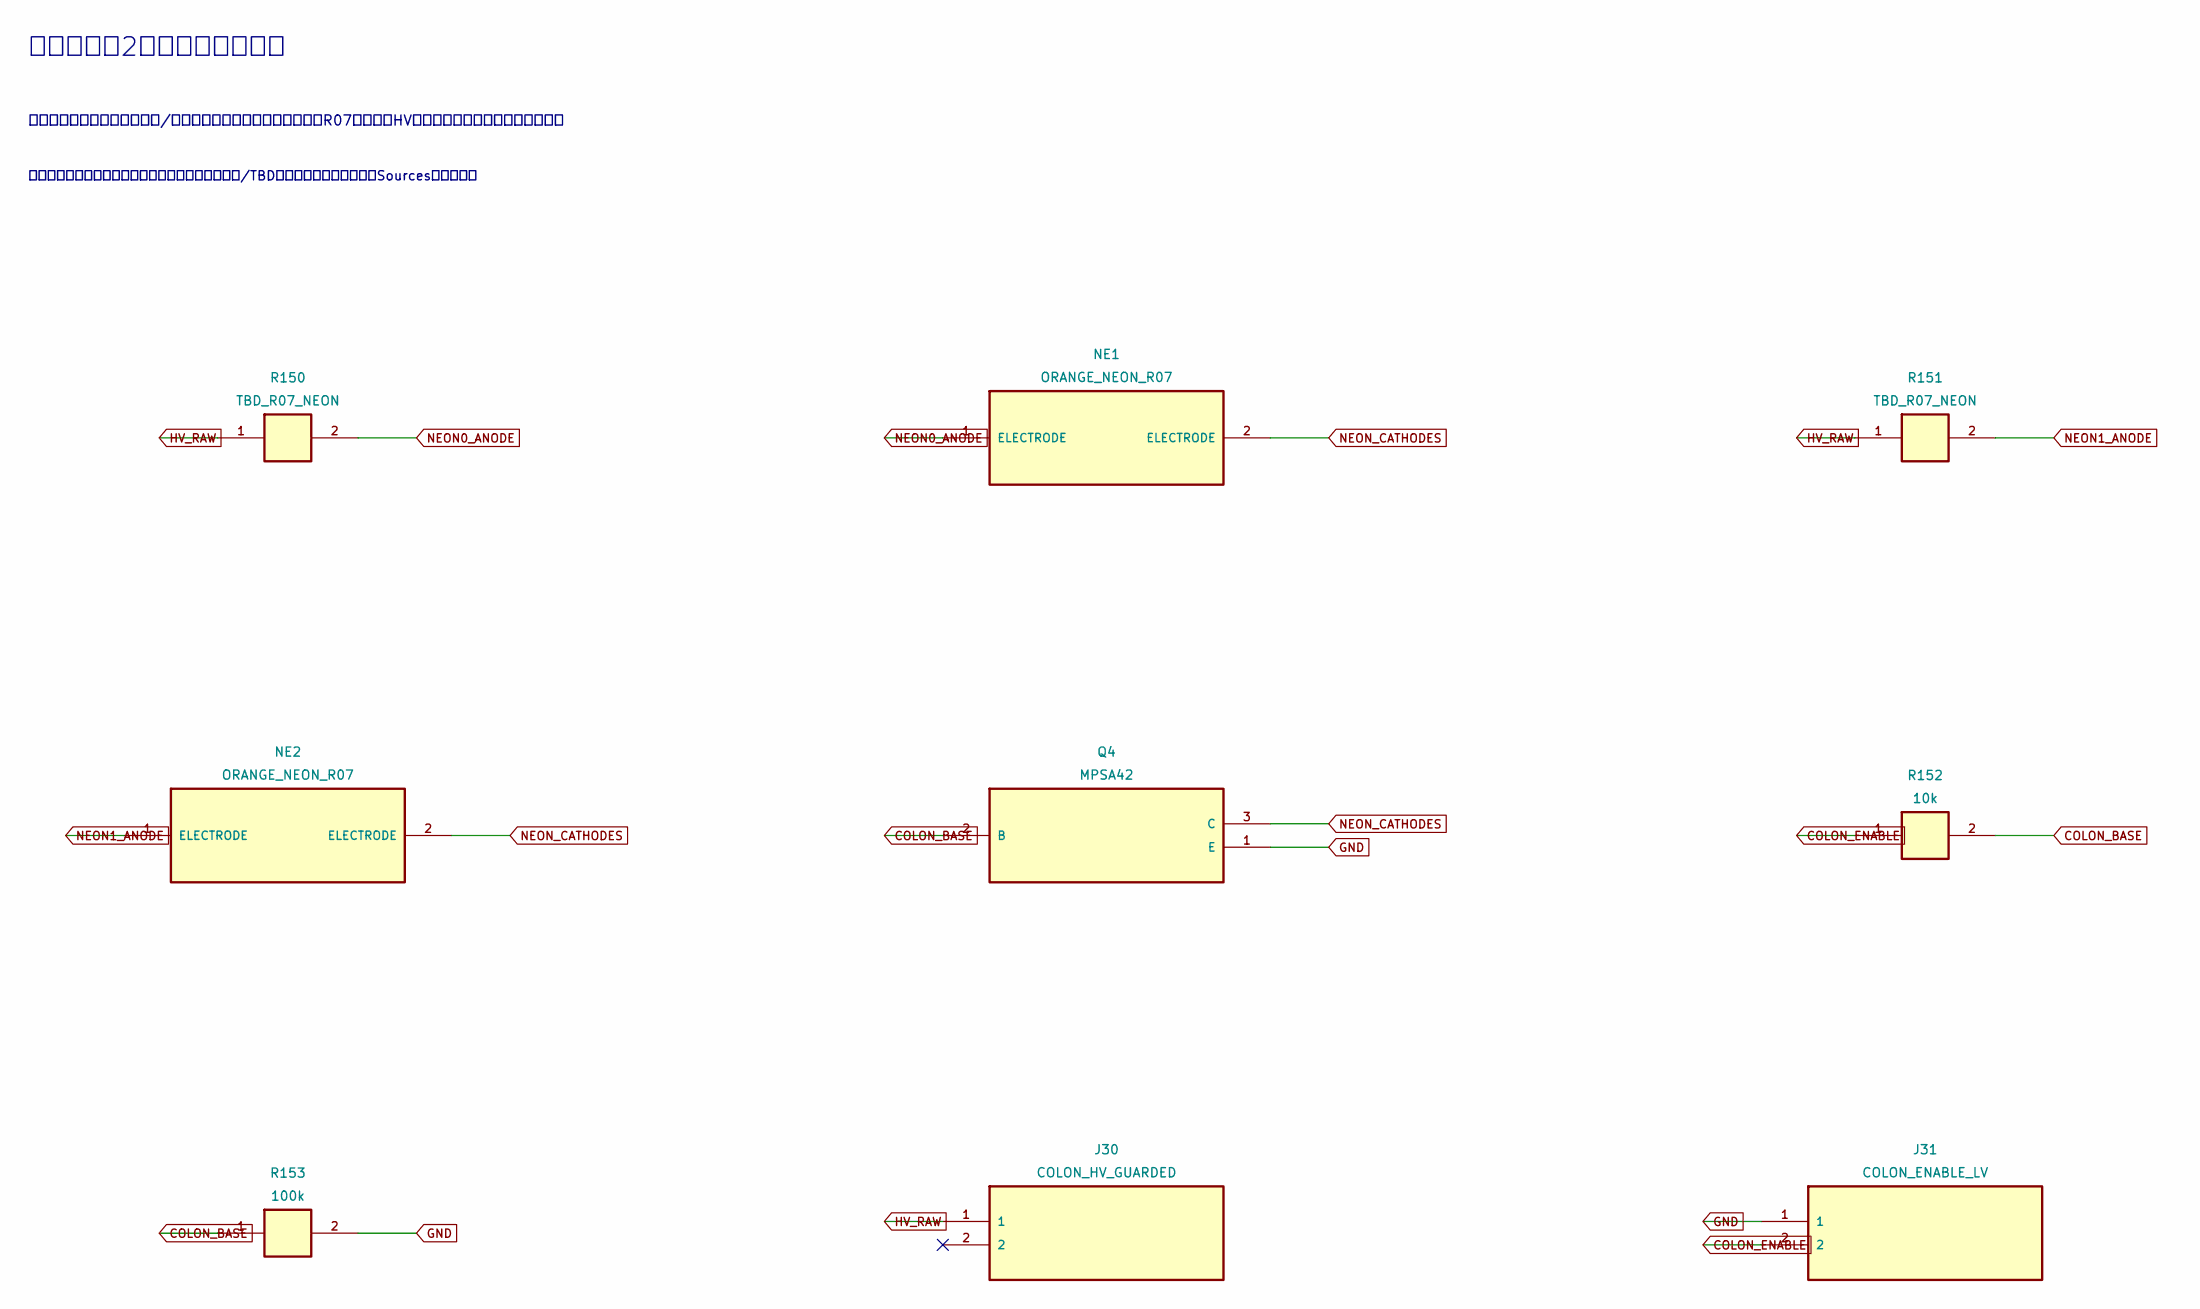
[picture p18: schematic colon.kicad_sch, 橙色ネオン2灯・個別電流制限]

Parts:
J30: COLON_HV_GUARDED; PhoenixContact_MSTBVA_2,5_2-G-5,08_1x02_P5.08mm_Vertical
J31: COLON_ENABLE_LV; PinHeader_1x02_P2.54mm_Vertical
NE1, NE2: ORANGE_NEON_R07; R_Axial_DIN0207_L6.3mm_D2.5mm_P5.08mm_Vertical
Q4: MPSA42; TO-92_Inline_Wide
R150, R151: TBD_R07_NEON; R_Axial_DIN0207_L6.3mm_D2.5mm_P5.08mm_Vertical
R152: 10k; R_0805_2012Metric
R153: 100k; R_0805_2012Metric

Connections:
COLON_BASE: Q4.2 (B), R152.2, R153.1
COLON_ENABLE: J31.2, R152.1
GND: J31.1, Q4.1 (E), R153.2
HV_RAW: J30.1, R150.1, R151.1
NEON0_ANODE: NE1.1, R150.2
NEON1_ANODE: NE2.1, R151.2
NEON_CATHODES: NE1.2, NE2.2, Q4.3 (C)

Notes on the sheet:
橙色ネオン2灯・個別電流制限
ネオン各枝に独立抵抗。維持/始動電圧・暗所特性と抵抗定格はR07で確認。HVと信号のコネクターは分離済み。
同名のネットラベルは階層を越えて接続。未確定値/TBDは発注不可。端子配置はSources欄を参照。

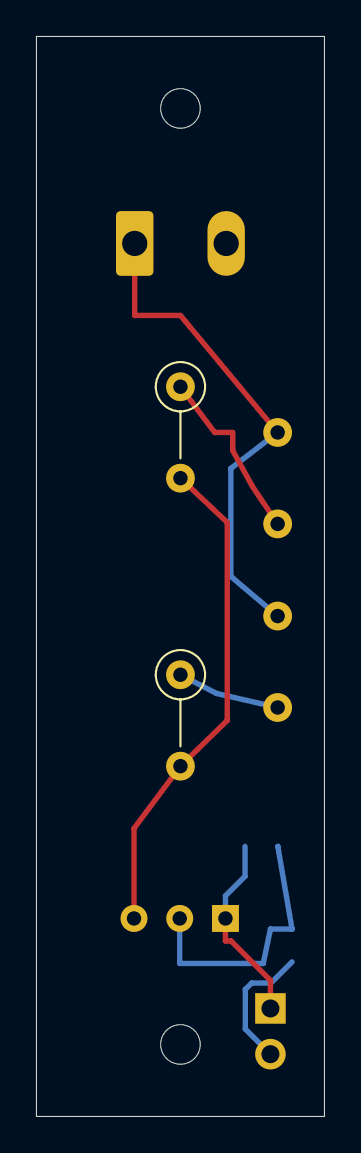
[picture p19: board colon-board.kicad_pcb from above]

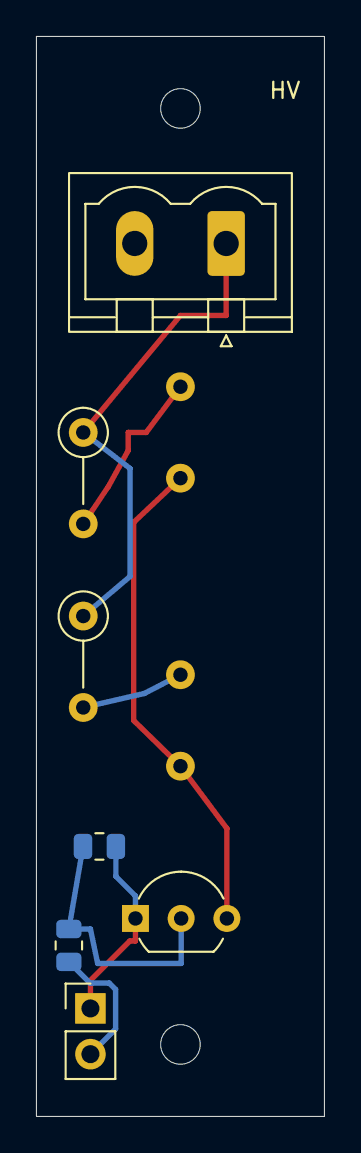
[picture p20: board colon-board.kicad_pcb from below]

Board: 2 copper layers, 16.0 x 60.0 mm, 11 parts (7 on the bottom side), 7 nets.

Other parts of the board:
H1, H2: NPTH_DRAFT; MountingHole_2.2mm_M2
