nexus4812/nixie-jjy-clock/hardware/pcb/generated_display/display-board.kicad_pcb

## KiCad design hardware/pcb/generated_display/display-board.kicad_pcb (2026-11-08)

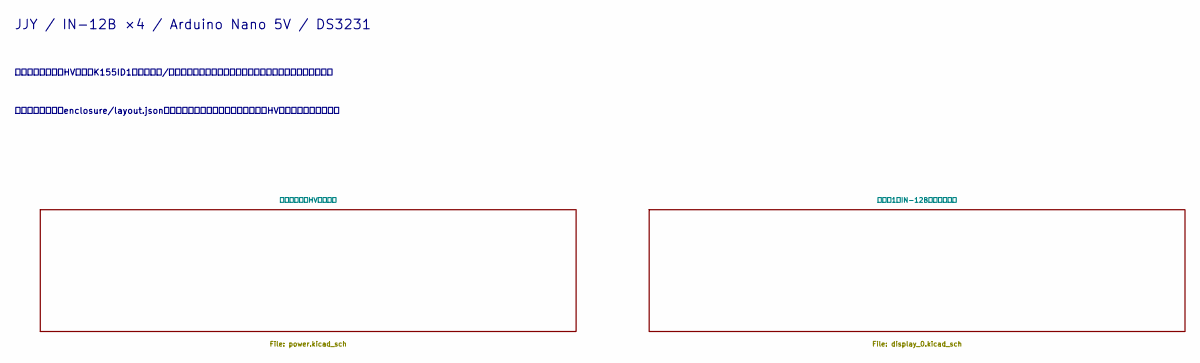
[picture p21: schematic display-board.kicad_sch, JJYニキシー管時計・回路検討初版]

Notes on the sheet:
JJY / IN-12B ×4 / Arduino Nano 5V / DS3231
レビュー用初版：HV電圧・K155ID1保護・部品/ソケット現物・コネクター定格は未確定。通電・発注不可。
機械寸法の正本：enclosure/layout.json。制御基板は候補配置・現物未照合。HV回路は別基板・保留。

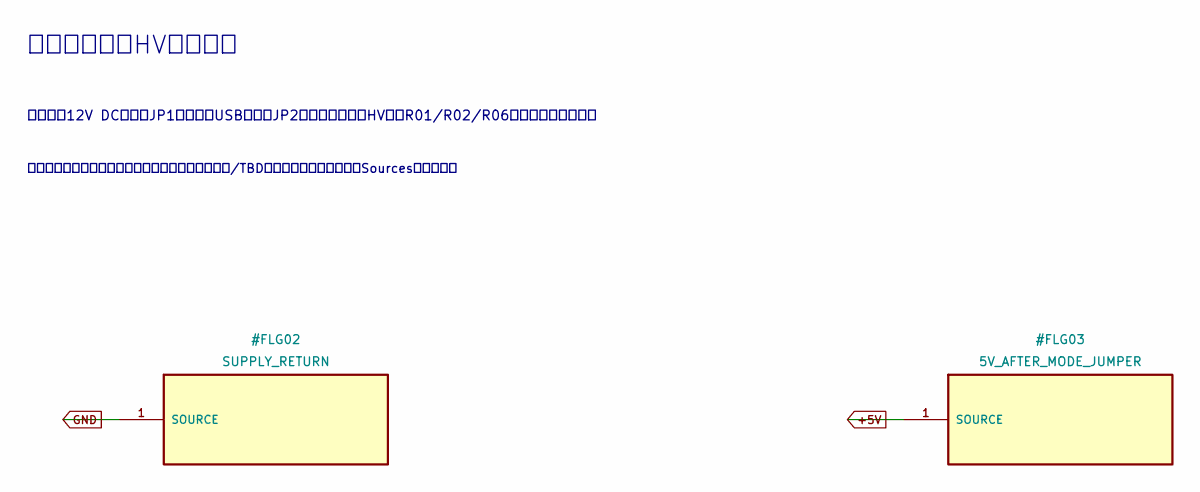
[picture p22: schematic power.kicad_sch, 電源・保護・HV停止制御]

Notes on the sheet:
電源・保護・HV停止制御
市販絶縁12V DCのみ。JP1を外してUSB書込。JP2は通常未挿入。HV部はR01/R02/R06未解決・通電不可。
同名のネットラベルは階層を越えて接続。未確定値/TBDは発注不可。端子配置はSources欄を参照。

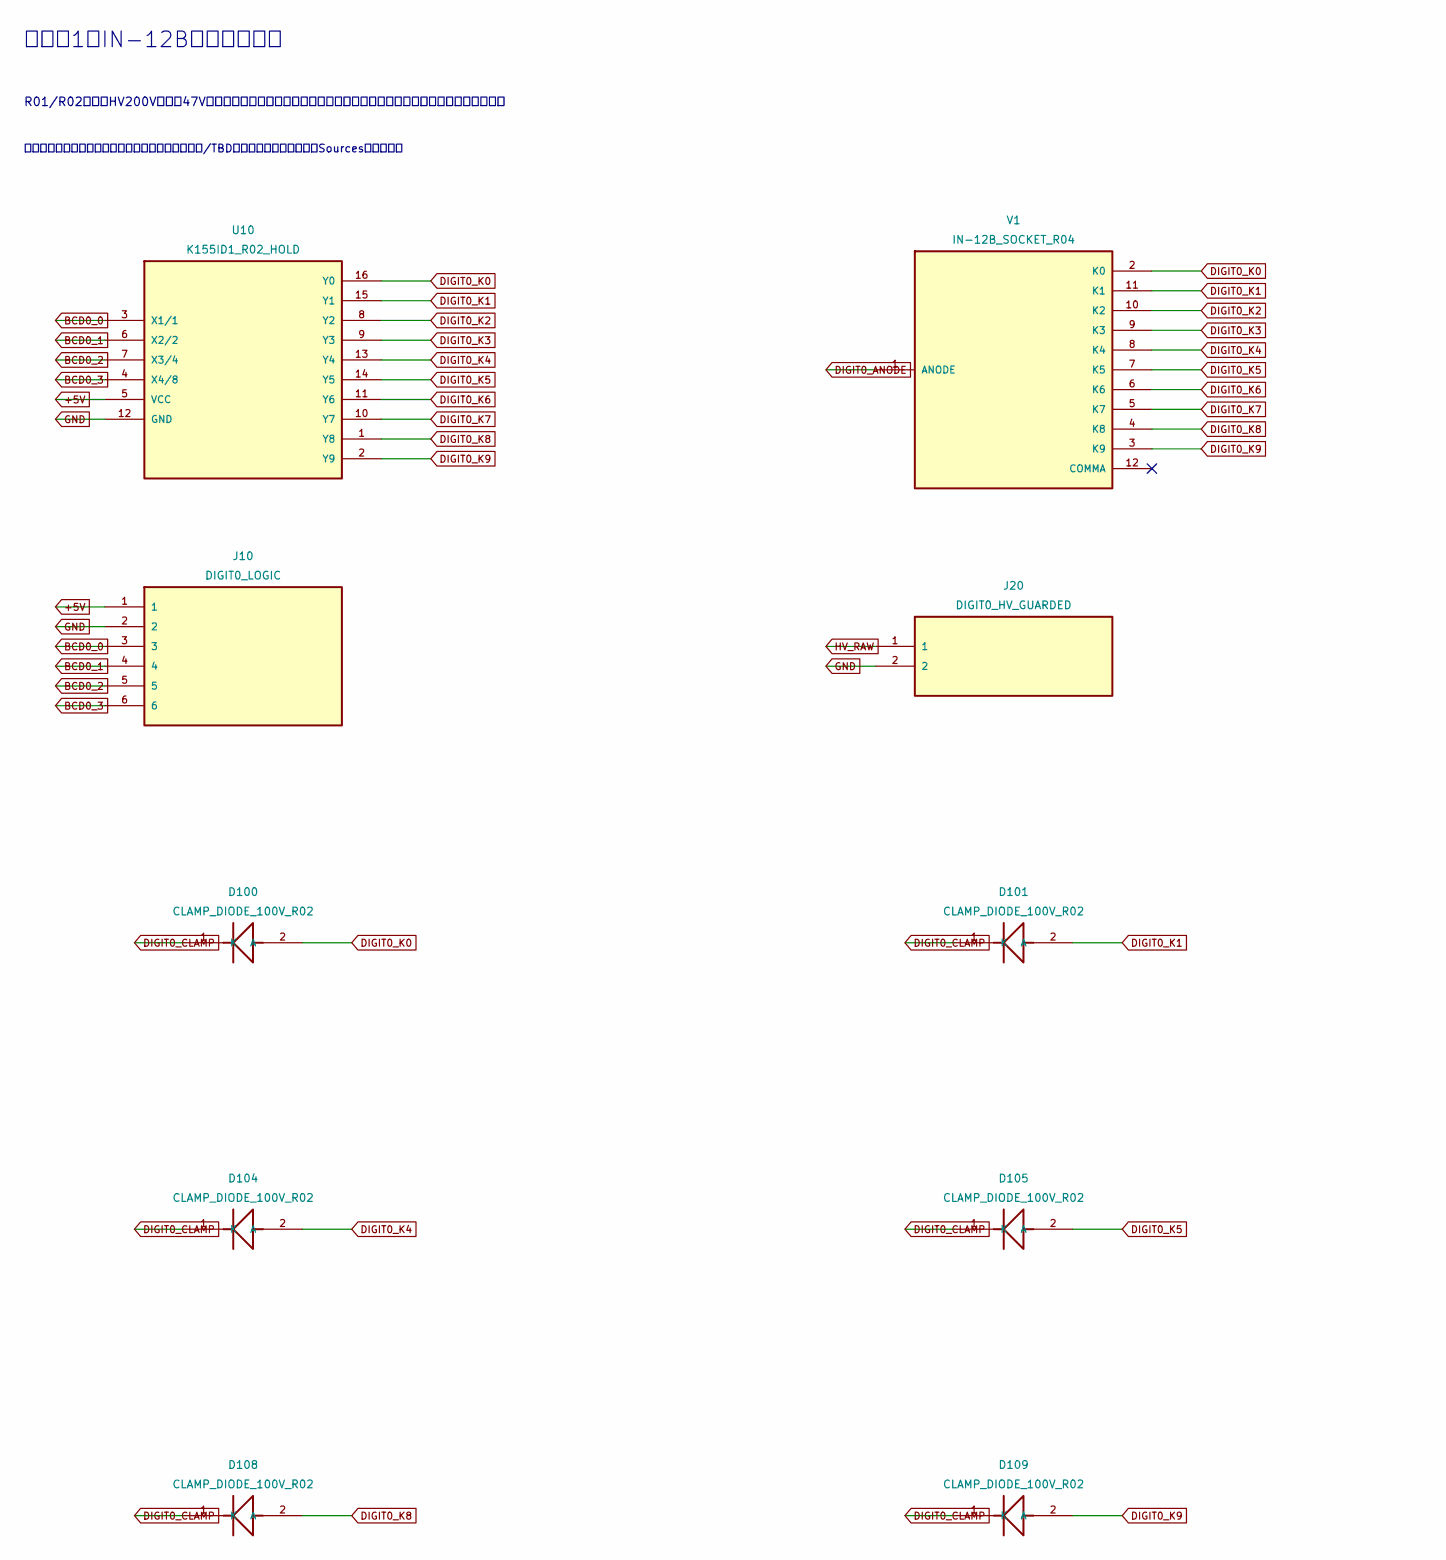
[picture p23: schematic display_0.kicad_sch, 表示子1・IN-12Bソケット候補, part in row 1, column 1]

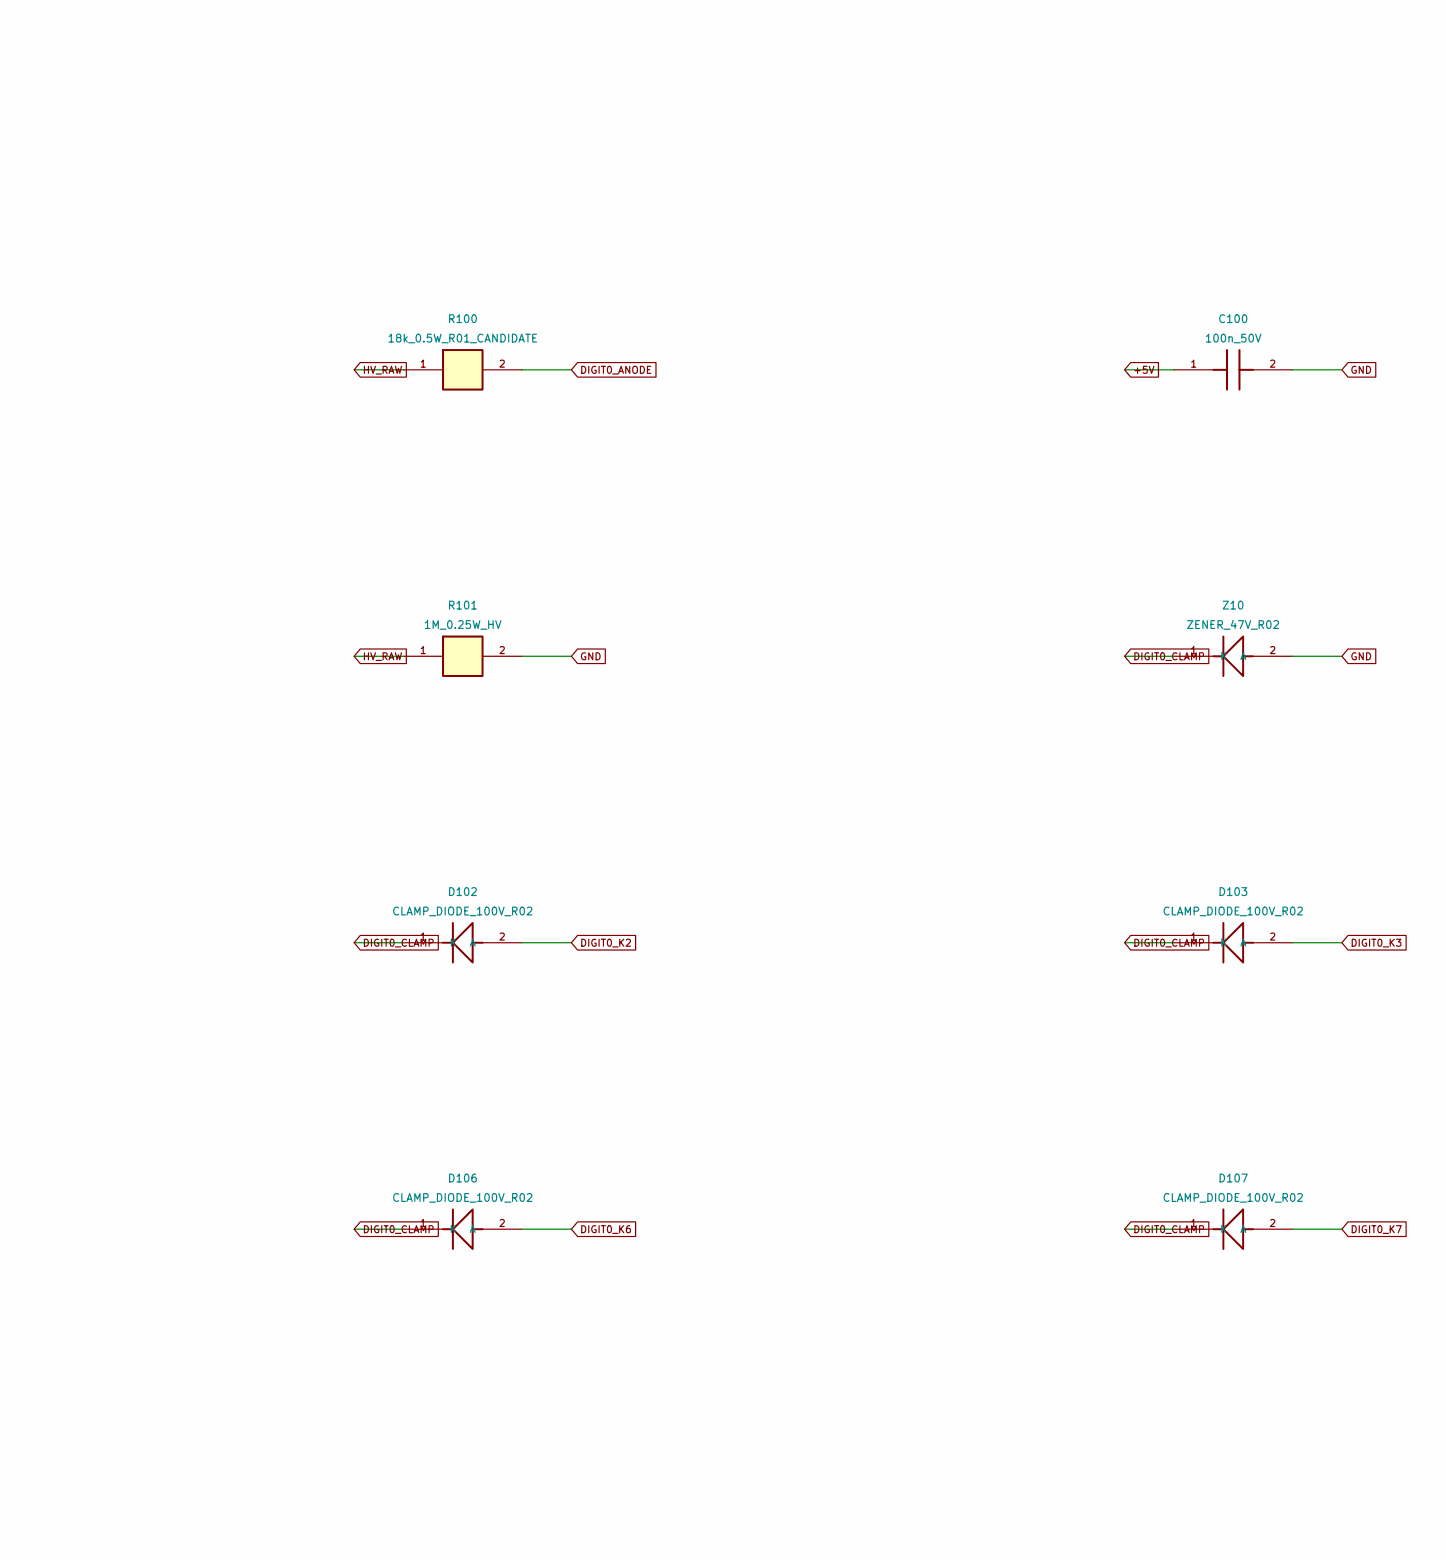
[picture p24: schematic display_0.kicad_sch, 表示子1・IN-12Bソケット候補, part in row 1, column 2]

Parts:
C100: 100n_50V; C_0805_2012Metric
D100, D101, D102, D103, D104, D105, D106, D107, D108, D109: CLAMP_DIODE_100V_R02; D_SOD-123
J10: DIGIT0_LOGIC; PinHeader_1x06_P2.54mm_Vertical
J20: DIGIT0_HV_GUARDED; PhoenixContact_MSTBVA_2,5_2-G-5,08_1x02_P5.08mm_Vertical
R100: 18k_0.5W_R01_CANDIDATE; R_Axial_DIN0309_L9.0mm_D3.2mm_P12.70mm_Horizontal
R101: 1M_0.25W_HV; R_Axial_DIN0309_L9.0mm_D3.2mm_P5.08mm_Vertical
U10: K155ID1_R02_HOLD; DIP-16_W7.62mm
V1: IN-12B_SOCKET_R04; IN-12B_Socket_Candidate
Z10: ZENER_47V_R02; D_SOD-123

Connections:
+5V: C100.1, J10.1, U10.5 (VCC)
BCD0_0: J10.3, U10.3 (X1/1)
BCD0_1: J10.4, U10.6 (X2/2)
BCD0_2: J10.5, U10.7 (X3/4)
BCD0_3: J10.6, U10.4 (X4/8)
DIGIT0_ANODE: R100.2, V1.1 (ANODE)
DIGIT0_CLAMP: D100.1 (K), D101.1 (K), D102.1 (K), D103.1 (K), D104.1 (K), D105.1 (K), D106.1 (K), D107.1 (K), D108.1 (K), D109.1 (K), Z10.1 (K)
DIGIT0_K0: D100.2 (A), U10.16 (Y0), V1.2 (K0)
DIGIT0_K1: D101.2 (A), U10.15 (Y1), V1.11 (K1)
DIGIT0_K2: D102.2 (A), U10.8 (Y2), V1.10 (K2)
DIGIT0_K3: D103.2 (A), U10.9 (Y3), V1.9 (K3)
DIGIT0_K4: D104.2 (A), U10.13 (Y4), V1.8 (K4)
DIGIT0_K5: D105.2 (A), U10.14 (Y5), V1.7 (K5)
DIGIT0_K6: D106.2 (A), U10.11 (Y6), V1.6 (K6)
DIGIT0_K7: D107.2 (A), U10.10 (Y7), V1.5 (K7)
DIGIT0_K8: D108.2 (A), U10.1 (Y8), V1.4 (K8)
DIGIT0_K9: D109.2 (A), U10.2 (Y9), V1.3 (K9)
GND: C100.2, J10.2, J20.2, R101.2, U10.12 (GND), Z10.2 (A)
HV_RAW: J20.1, R100.1, R101.1

Notes on the sheet:
表示子1・IN-12Bソケット候補
R01/R02未閉：HV200V候補と47Vクランプは計算上の候補で未実測。接続検討図であり通電・発注用ではない。
同名のネットラベルは階層を越えて接続。未確定値/TBDは発注不可。端子配置はSources欄を参照。
