nexus4812/nixie-jjy-clock/hardware/pcb/generated_display/display-board.kicad_pcb

## KiCad design hardware/pcb/generated_display/display-board.kicad_pcb (continued)

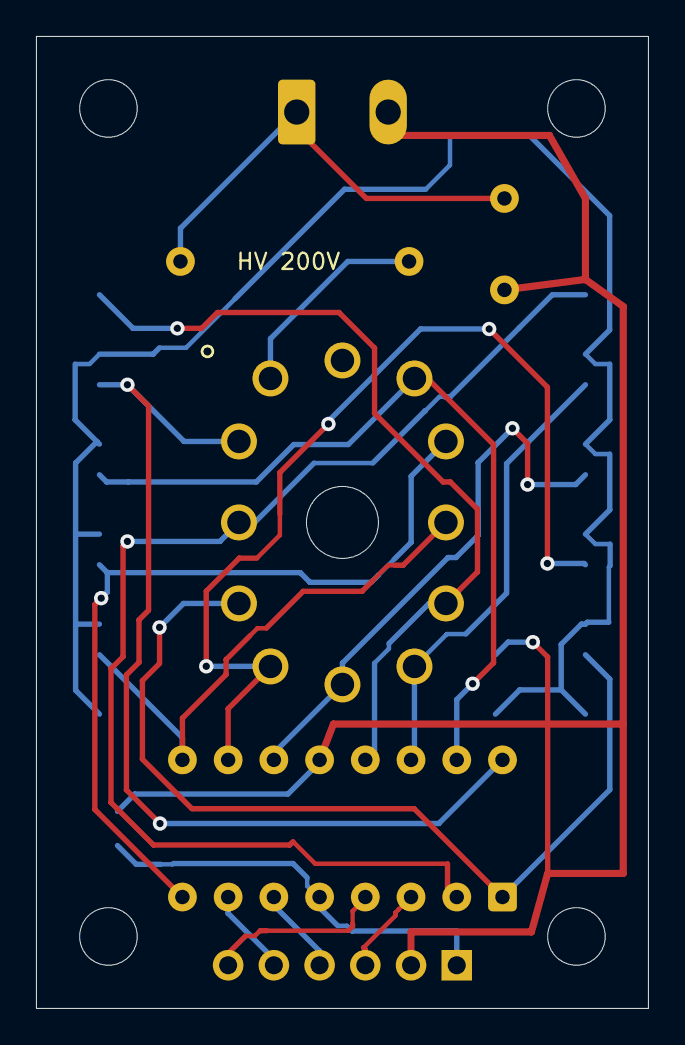
[picture p25: board display-board.kicad_pcb from above]

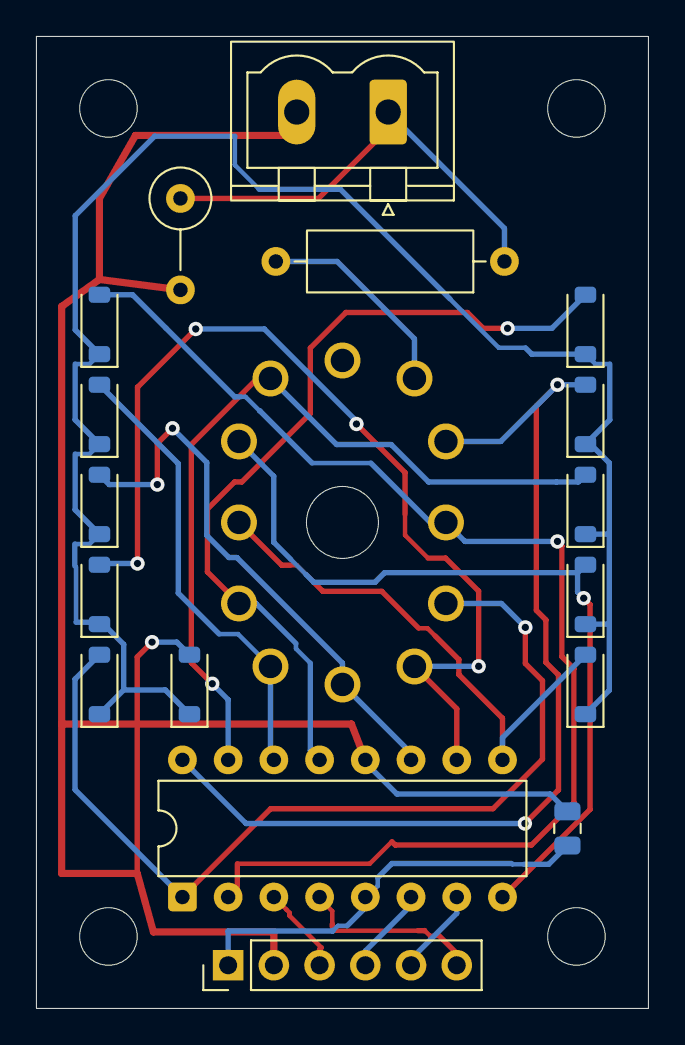
[picture p26: board display-board.kicad_pcb from below]

Board: 2 copper layers, 34.0 x 54.0 mm, 22 parts (17 on the bottom side), 19 nets.

Other parts of the board:
H1, H2, H3, H4: NPTH_DRAFT; MountingHole_3.2mm_M3
