nexus4812/nixie-jjy-clock/hardware/pcb/generated/control-board.kicad_pcb

## KiCad design hardware/pcb/generated/control-board.kicad_pcb (continued)

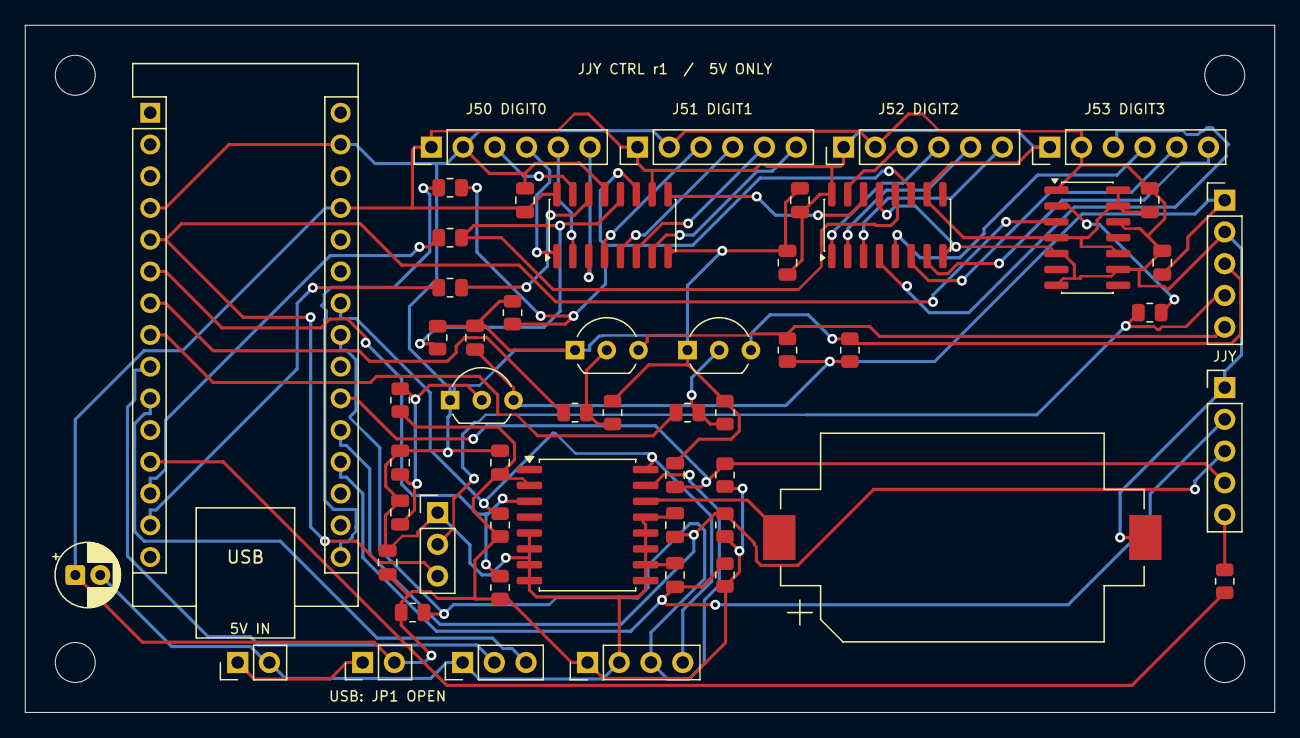
[picture p35: board control-board.kicad_pcb from above]

Board: 2 copper layers, 100.0 x 55.0 mm, 58 parts (0 on the bottom side), 48 nets.

Other parts of the board:
H1, H2, H3, H4: M3_NPTH_DRAFT; MountingHole_3.2mm_M3
