nexus4812/nixie-jjy-clock/hardware/schematic/generated/colon.kicad_sch

## KiCad design hardware/schematic/generated/colon.kicad_sch (2026-11-08)


Parts:
J30: COLON_HV_GUARDED; PhoenixContact_MSTBVA_2,5_2-G-5,08_1x02_P5.08mm_Vertical
J31: COLON_ENABLE_LV; PinHeader_1x02_P2.54mm_Vertical
NE1, NE2: ORANGE_NEON_R07; R_Axial_DIN0207_L6.3mm_D2.5mm_P5.08mm_Vertical
Q4: MPSA42; TO-92_Inline_Wide
R150, R151: TBD_R07_NEON; R_Axial_DIN0207_L6.3mm_D2.5mm_P5.08mm_Vertical
R152: 10k; R_0805_2012Metric
R153: 100k; R_0805_2012Metric

Connections:
COLON_BASE: Q4.2 (B), R152.2, R153.1
COLON_ENABLE: J31.2, R152.1
GND: J31.1, Q4.1 (E), R153.2
HV_RAW: J30.1, R150.1, R151.1
NEON0_ANODE: NE1.1, R150.2
NEON1_ANODE: NE2.1, R151.2
NEON_CATHODES: NE1.2, NE2.2, Q4.3 (C)

Notes on the sheet:
橙色ネオン2灯・個別電流制限
ネオン各枝に独立抵抗。維持/始動電圧・暗所特性と抵抗定格はR07で確認。HVと信号のコネクターは分離済み。
同名のネットラベルは階層を越えて接続。未確定値/TBDは発注不可。端子配置はSources欄を参照。
