nexus4812/nixie-jjy-clock/hardware/schematic/generated/control.kicad_sch

## KiCad design hardware/schematic/generated/control.kicad_sch (2026-11-08)



Parts:
A1: NANO_328P_5V16MHz; Arduino_Nano
C10, C11: 100n_50V; C_0805_2012Metric
C12: 10u_16V; C_0805_2012Metric
J50: TO_DIGIT0_LV; PinHeader_1x06_P2.54mm_Vertical
J51: TO_DIGIT1_LV; PinHeader_1x06_P2.54mm_Vertical
J52: TO_DIGIT2_LV; PinHeader_1x06_P2.54mm_Vertical
J53: TO_DIGIT3_LV; PinHeader_1x06_P2.54mm_Vertical
R10, R11, R12: 100R; R_0805_2012Metric
R13, R14: 10k; R_0805_2012Metric
U1, U2: 74HCT595D; SOIC-16_3.9x9.9mm_P1.27mm

Connections:
+5V: A1.27 (5V), C10.1, C11.1, C12.1, J50.1, J51.1, J52.1, J53.1, U1.10 (~SRCLR), U1.16 (VCC), U2.10 (~SRCLR), U2.16 (VCC)
BCD0_0: J50.3, U1.15 (Q0)
BCD0_1: J50.4, U1.1 (Q1)
BCD0_2: J50.5, U1.2 (Q2)
BCD0_3: J50.6, U1.3 (Q3)
BCD1_0: J51.3, U1.4 (Q4)
BCD1_1: J51.4, U1.5 (Q5)
BCD1_2: J51.5, U1.6 (Q6)
BCD1_3: J51.6, U1.7 (Q7)
BCD2_0: J52.3, U2.15 (Q0)
BCD2_1: J52.4, U2.1 (Q1)
BCD2_2: J52.5, U2.2 (Q2)
BCD2_3: J52.6, U2.3 (Q3)
BCD3_0: J53.3, U2.4 (Q4)
BCD3_1: J53.4, U2.5 (Q5)
BCD3_2: J53.5, U2.6 (Q6)
BCD3_3: J53.6, U2.7 (Q7)
BUTTON_MINUS: A1.21 (A2)
BUTTON_PLUS: A1.20 (A1)
BUTTON_SET: A1.19 (A0)
COLON_ENABLE: A1.10 (D7)
GND: A1.4 (GND), A1.29 (GND), C10.2, C11.2, C12.2, J50.2, J51.2, J52.2, J53.2, R13.2, R14.2, U1.8 (GND), U1.13 (~OE), U2.8 (GND), U2.13 (~OE)
HV_ENABLE: A1.9 (D6)
I2C_SCL: A1.24 (A5)
I2C_SDA: A1.23 (A4)
JJY_DATA: A1.5 (D2)
PDN1_PULL_LOW: A1.7 (D4)
PDN2_PULL_LOW: A1.8 (D5)
RTC_SQW: A1.6 (D3)
SR_CASCADE: U1.9 (Q7S), U2.14 (SER)
SR_CLOCK: A1.16 (D13), R10.1
SR_CLOCK_BUS: R10.2, R13.1, U1.11 (SRCLK), U2.11 (SRCLK)
SR_DATA: A1.14 (D11), R12.1
SR_DATA_BUS: R12.2, U1.14 (SER)
SR_LATCH: A1.13 (D10), R11.1
SR_LATCH_BUS: R11.2, R14.1, U1.12 (RCLK), U2.12 (RCLK)
STATUS_LED: A1.12 (D9)

Notes on the sheet:
Arduino Nano・16bit静的BCD駆動
595 OEはGND固定。データをラッチするまでHVを許可しない。D8予備。D0/D1はUSB診断用。
同名のネットラベルは階層を越えて接続。未確定値/TBDは発注不可。端子配置はSources欄を参照。
