nexus4812/nixie-jjy-clock/hardware/schematic/generated/display_1.kicad_sch

## KiCad design hardware/schematic/generated/display_1.kicad_sch (2026-11-08)

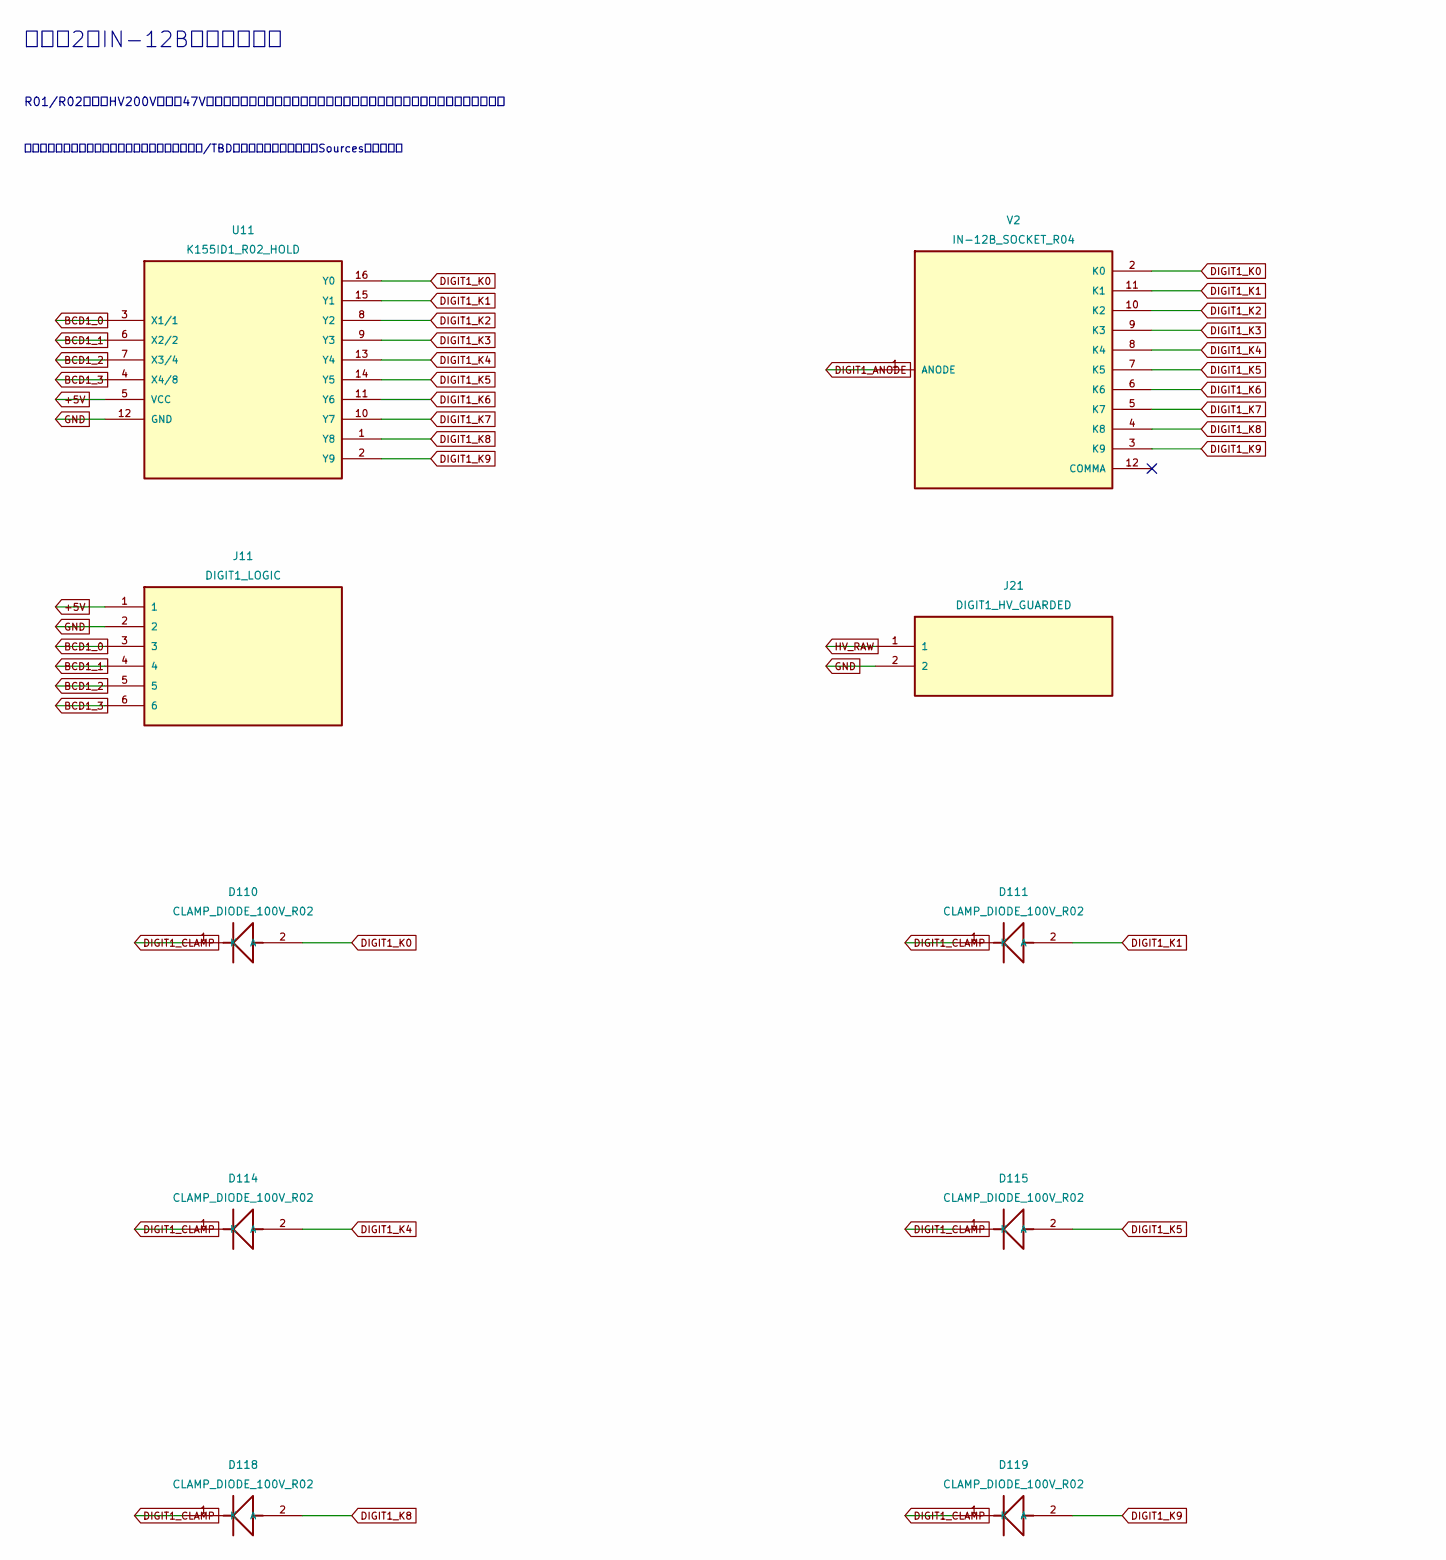
[picture p36: schematic display_1.kicad_sch, part in row 1, column 1]

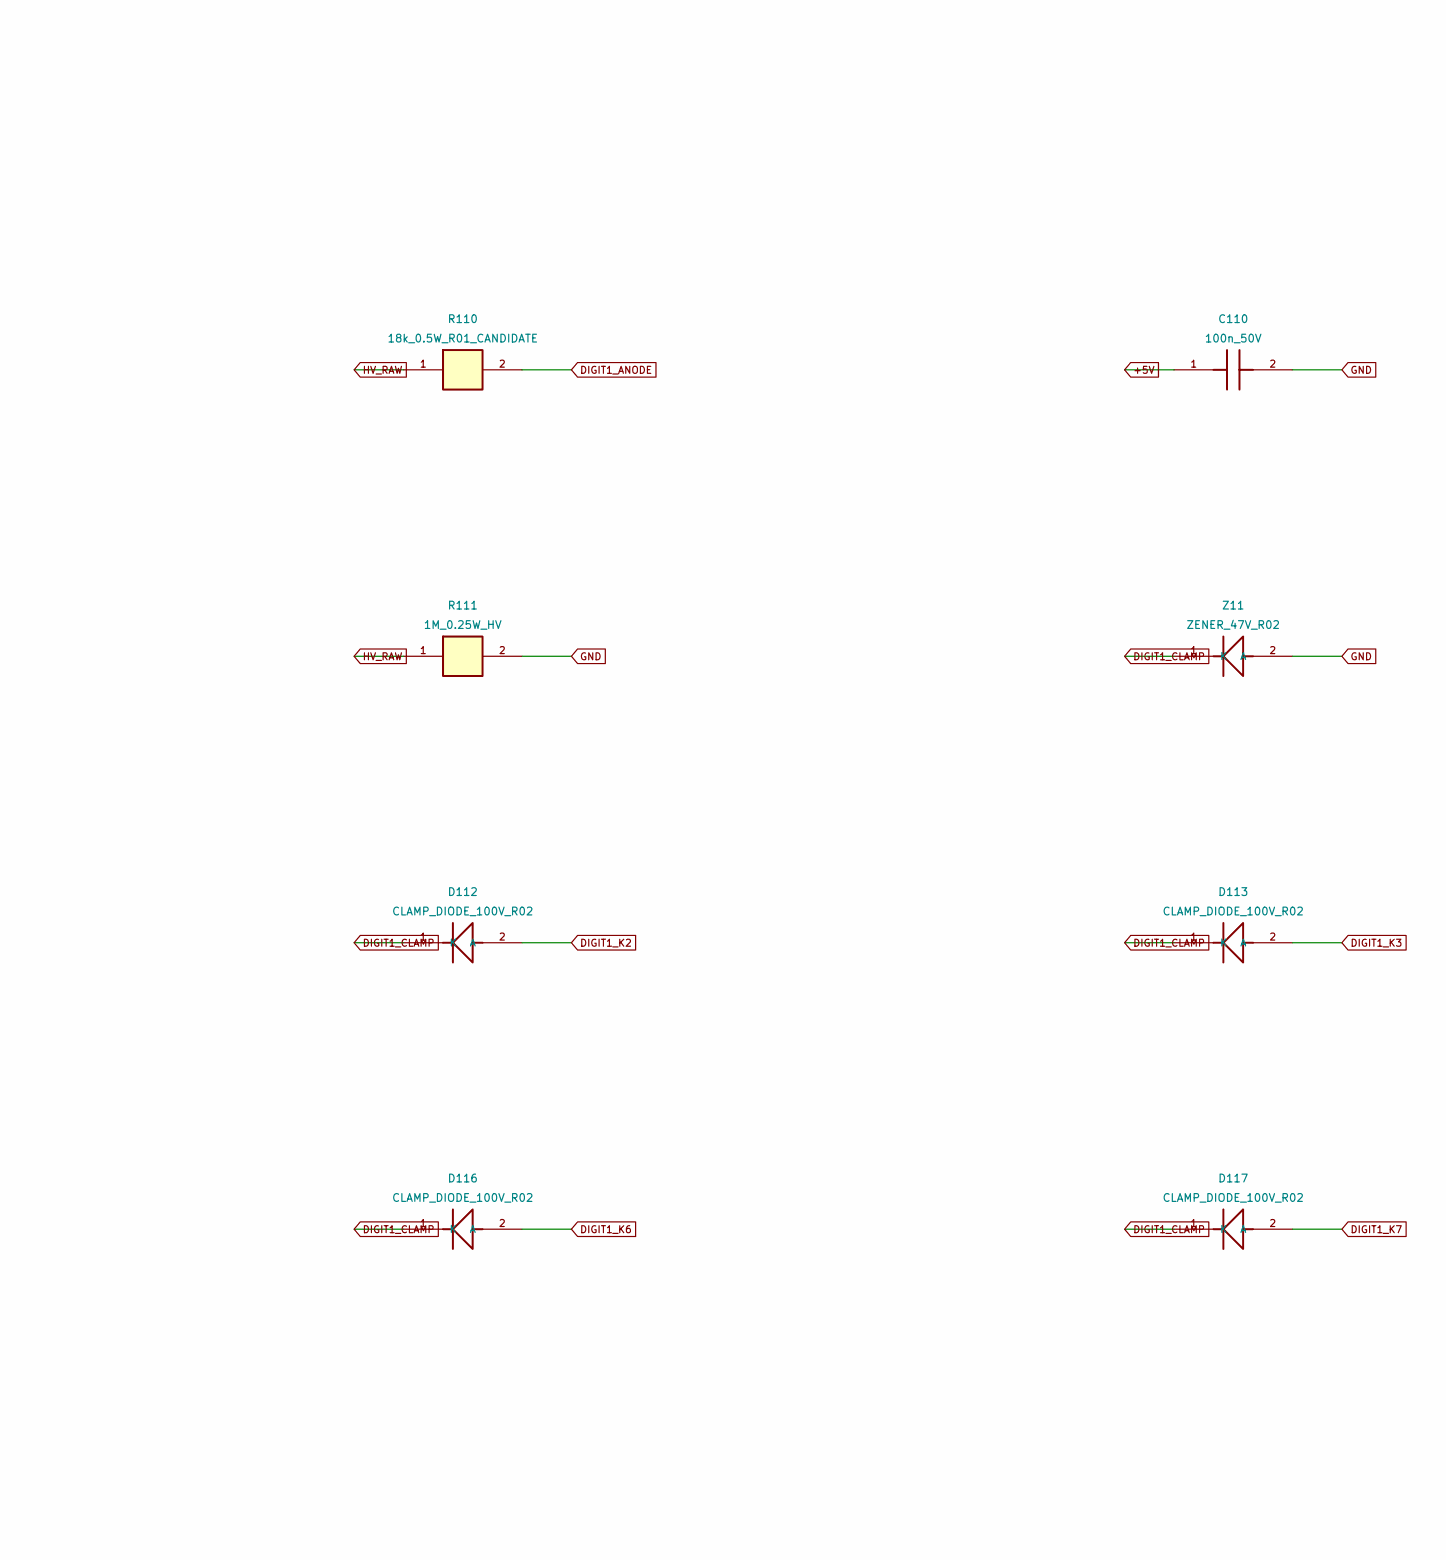
[picture p37: schematic display_1.kicad_sch, part in row 1, column 2]

Parts:
C110: 100n_50V; C_0805_2012Metric
D110, D111, D112, D113, D114, D115, D116, D117, D118, D119: CLAMP_DIODE_100V_R02; D_SOD-123
J11: DIGIT1_LOGIC; PinHeader_1x06_P2.54mm_Vertical
J21: DIGIT1_HV_GUARDED; PhoenixContact_MSTBVA_2,5_2-G-5,08_1x02_P5.08mm_Vertical
R110: 18k_0.5W_R01_CANDIDATE; R_Axial_DIN0309_L9.0mm_D3.2mm_P12.70mm_Horizontal
R111: 1M_0.25W_HV; R_Axial_DIN0309_L9.0mm_D3.2mm_P5.08mm_Vertical
U11: K155ID1_R02_HOLD; DIP-16_W7.62mm
V2: IN-12B_SOCKET_R04; IN-12B_Socket_Candidate
Z11: ZENER_47V_R02; D_SOD-123

Connections:
+5V: C110.1, J11.1, U11.5 (VCC)
BCD1_0: J11.3, U11.3 (X1/1)
BCD1_1: J11.4, U11.6 (X2/2)
BCD1_2: J11.5, U11.7 (X3/4)
BCD1_3: J11.6, U11.4 (X4/8)
DIGIT1_ANODE: R110.2, V2.1 (ANODE)
DIGIT1_CLAMP: D110.1 (K), D111.1 (K), D112.1 (K), D113.1 (K), D114.1 (K), D115.1 (K), D116.1 (K), D117.1 (K), D118.1 (K), D119.1 (K), Z11.1 (K)
DIGIT1_K0: D110.2 (A), U11.16 (Y0), V2.2 (K0)
DIGIT1_K1: D111.2 (A), U11.15 (Y1), V2.11 (K1)
DIGIT1_K2: D112.2 (A), U11.8 (Y2), V2.10 (K2)
DIGIT1_K3: D113.2 (A), U11.9 (Y3), V2.9 (K3)
DIGIT1_K4: D114.2 (A), U11.13 (Y4), V2.8 (K4)
DIGIT1_K5: D115.2 (A), U11.14 (Y5), V2.7 (K5)
DIGIT1_K6: D116.2 (A), U11.11 (Y6), V2.6 (K6)
DIGIT1_K7: D117.2 (A), U11.10 (Y7), V2.5 (K7)
DIGIT1_K8: D118.2 (A), U11.1 (Y8), V2.4 (K8)
DIGIT1_K9: D119.2 (A), U11.2 (Y9), V2.3 (K9)
GND: C110.2, J11.2, J21.2, R111.2, U11.12 (GND), Z11.2 (A)
HV_RAW: J21.1, R110.1, R111.1

Notes on the sheet:
表示子2・IN-12Bソケット候補
R01/R02未閉：HV200V候補と47Vクランプは計算上の候補で未実測。接続検討図であり通電・発注用ではない。
同名のネットラベルは階層を越えて接続。未確定値/TBDは発注不可。端子配置はSources欄を参照。
