nexus4812/nixie-jjy-clock/hardware/schematic/generated/display_2.kicad_sch

## KiCad design hardware/schematic/generated/display_2.kicad_sch (2026-11-08)

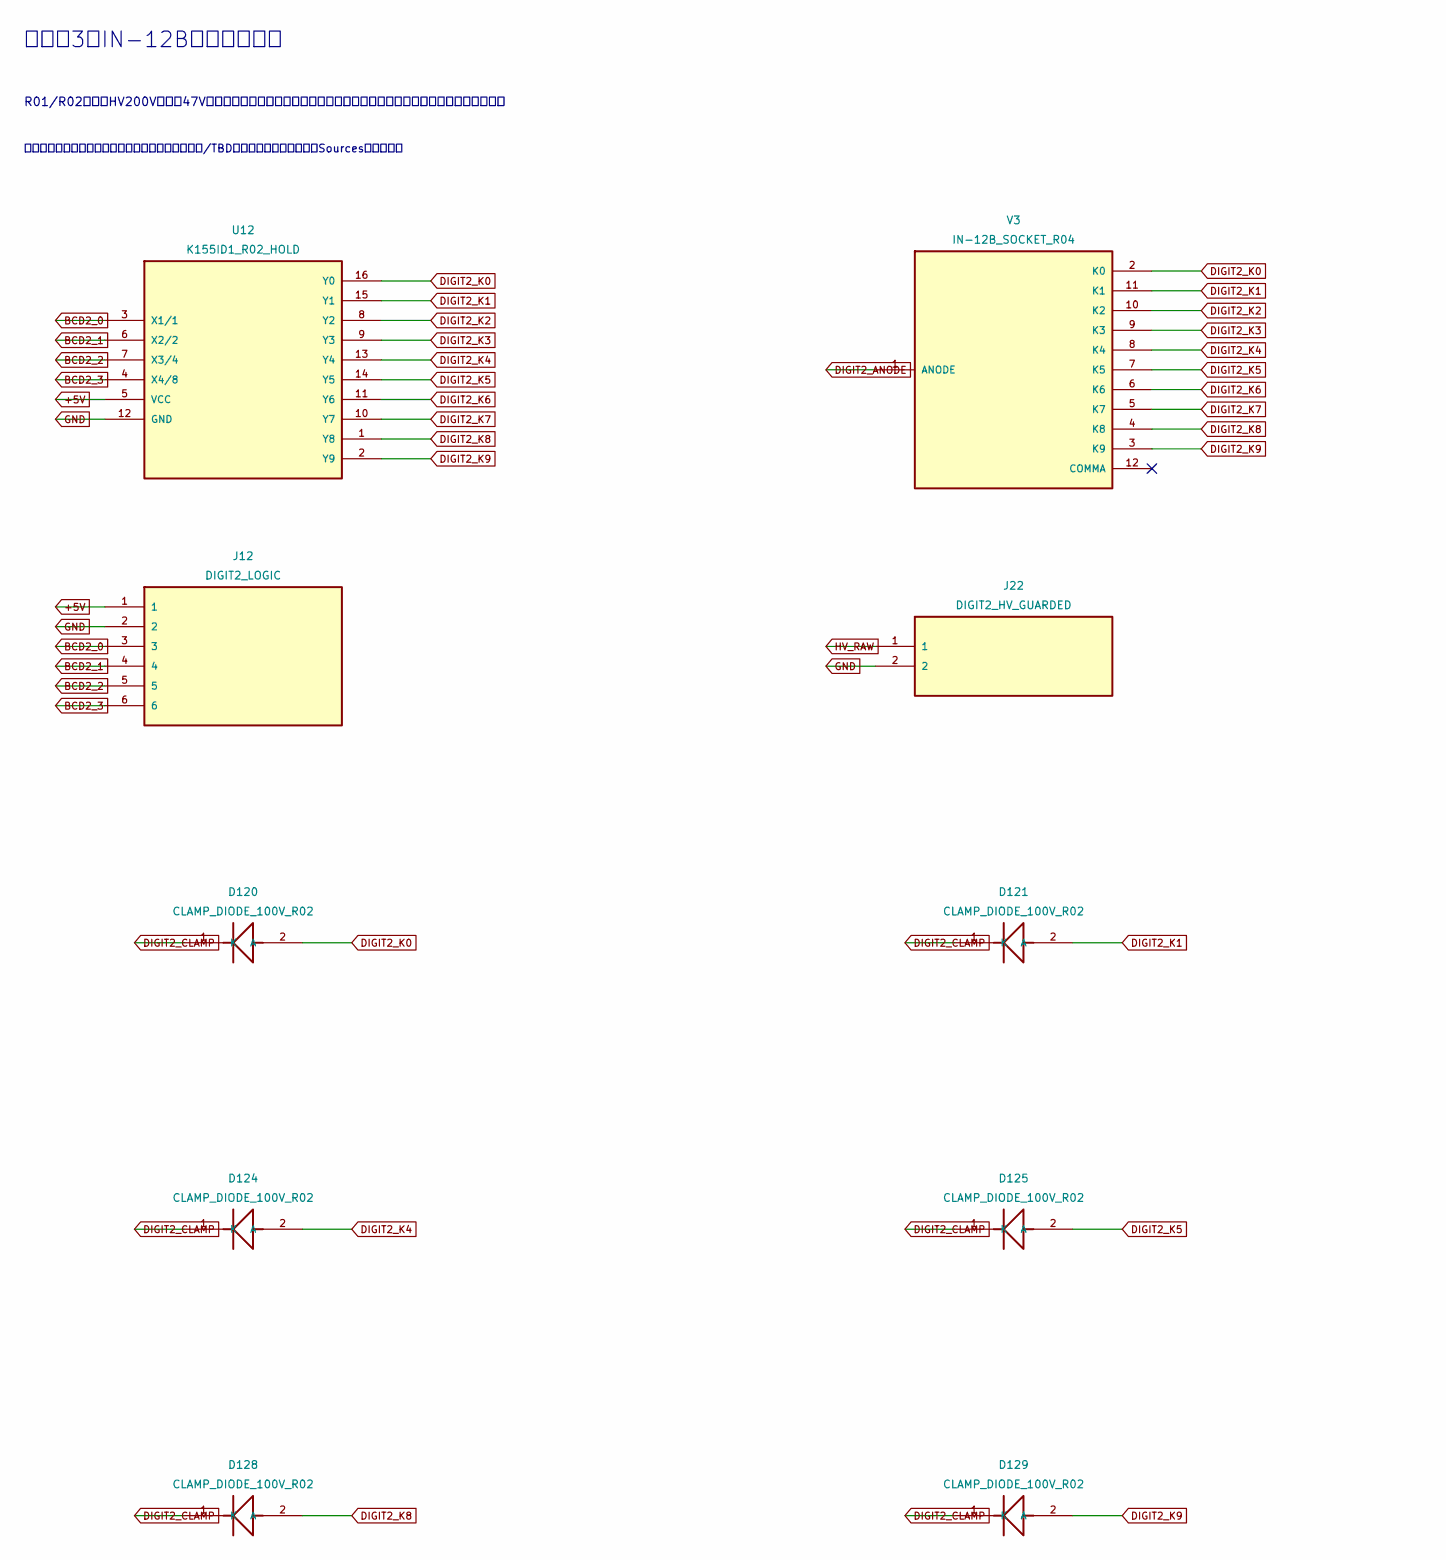
[picture p38: schematic display_2.kicad_sch, part in row 1, column 1]

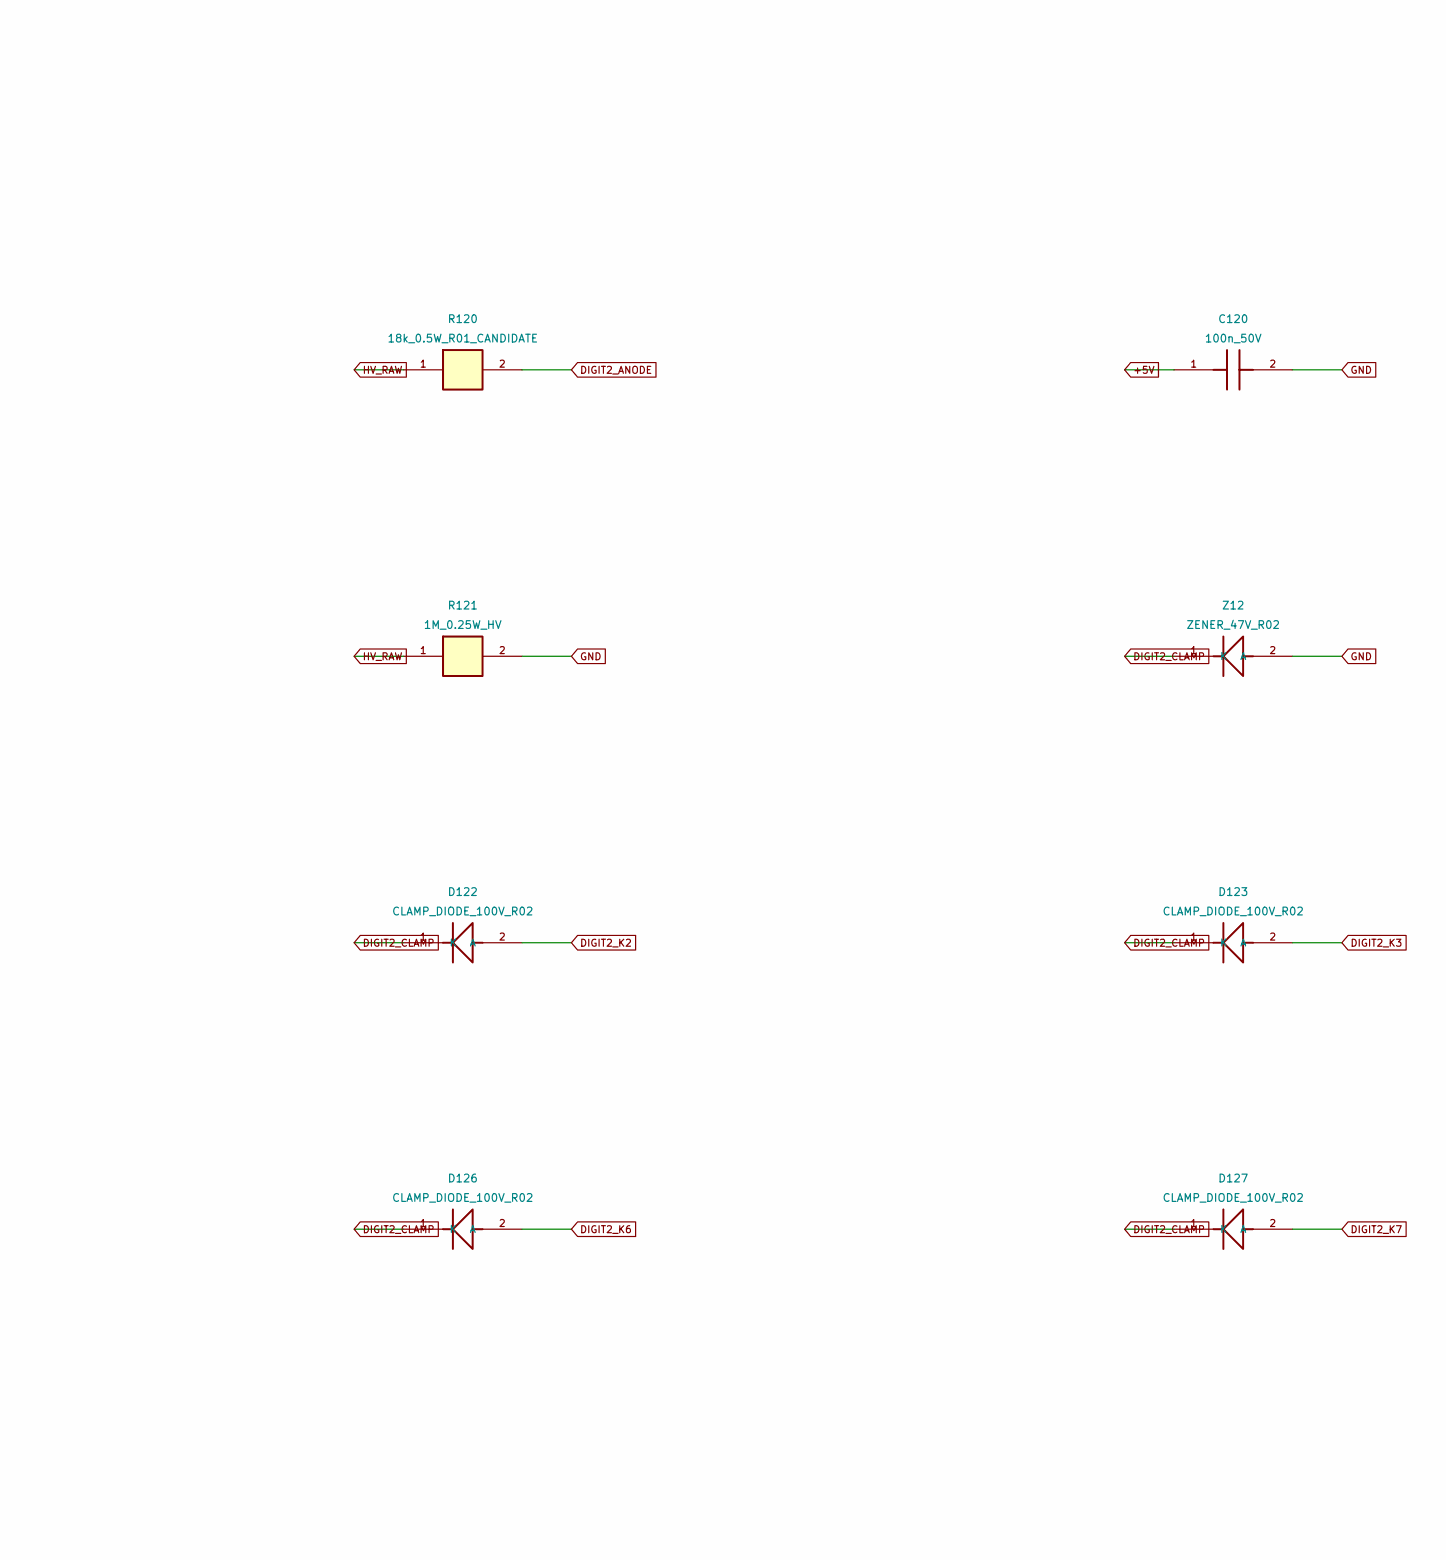
[picture p39: schematic display_2.kicad_sch, part in row 1, column 2]

Parts:
C120: 100n_50V; C_0805_2012Metric
D120, D121, D122, D123, D124, D125, D126, D127, D128, D129: CLAMP_DIODE_100V_R02; D_SOD-123
J12: DIGIT2_LOGIC; PinHeader_1x06_P2.54mm_Vertical
J22: DIGIT2_HV_GUARDED; PhoenixContact_MSTBVA_2,5_2-G-5,08_1x02_P5.08mm_Vertical
R120: 18k_0.5W_R01_CANDIDATE; R_Axial_DIN0309_L9.0mm_D3.2mm_P12.70mm_Horizontal
R121: 1M_0.25W_HV; R_Axial_DIN0309_L9.0mm_D3.2mm_P5.08mm_Vertical
U12: K155ID1_R02_HOLD; DIP-16_W7.62mm
V3: IN-12B_SOCKET_R04; IN-12B_Socket_Candidate
Z12: ZENER_47V_R02; D_SOD-123

Connections:
+5V: C120.1, J12.1, U12.5 (VCC)
BCD2_0: J12.3, U12.3 (X1/1)
BCD2_1: J12.4, U12.6 (X2/2)
BCD2_2: J12.5, U12.7 (X3/4)
BCD2_3: J12.6, U12.4 (X4/8)
DIGIT2_ANODE: R120.2, V3.1 (ANODE)
DIGIT2_CLAMP: D120.1 (K), D121.1 (K), D122.1 (K), D123.1 (K), D124.1 (K), D125.1 (K), D126.1 (K), D127.1 (K), D128.1 (K), D129.1 (K), Z12.1 (K)
DIGIT2_K0: D120.2 (A), U12.16 (Y0), V3.2 (K0)
DIGIT2_K1: D121.2 (A), U12.15 (Y1), V3.11 (K1)
DIGIT2_K2: D122.2 (A), U12.8 (Y2), V3.10 (K2)
DIGIT2_K3: D123.2 (A), U12.9 (Y3), V3.9 (K3)
DIGIT2_K4: D124.2 (A), U12.13 (Y4), V3.8 (K4)
DIGIT2_K5: D125.2 (A), U12.14 (Y5), V3.7 (K5)
DIGIT2_K6: D126.2 (A), U12.11 (Y6), V3.6 (K6)
DIGIT2_K7: D127.2 (A), U12.10 (Y7), V3.5 (K7)
DIGIT2_K8: D128.2 (A), U12.1 (Y8), V3.4 (K8)
DIGIT2_K9: D129.2 (A), U12.2 (Y9), V3.3 (K9)
GND: C120.2, J12.2, J22.2, R121.2, U12.12 (GND), Z12.2 (A)
HV_RAW: J22.1, R120.1, R121.1

Notes on the sheet:
表示子3・IN-12Bソケット候補
R01/R02未閉：HV200V候補と47Vクランプは計算上の候補で未実測。接続検討図であり通電・発注用ではない。
同名のネットラベルは階層を越えて接続。未確定値/TBDは発注不可。端子配置はSources欄を参照。
