nexus4812/nixie-jjy-clock/hardware/schematic/generated/display_3.kicad_sch

## KiCad design hardware/schematic/generated/display_3.kicad_sch (2026-11-08)

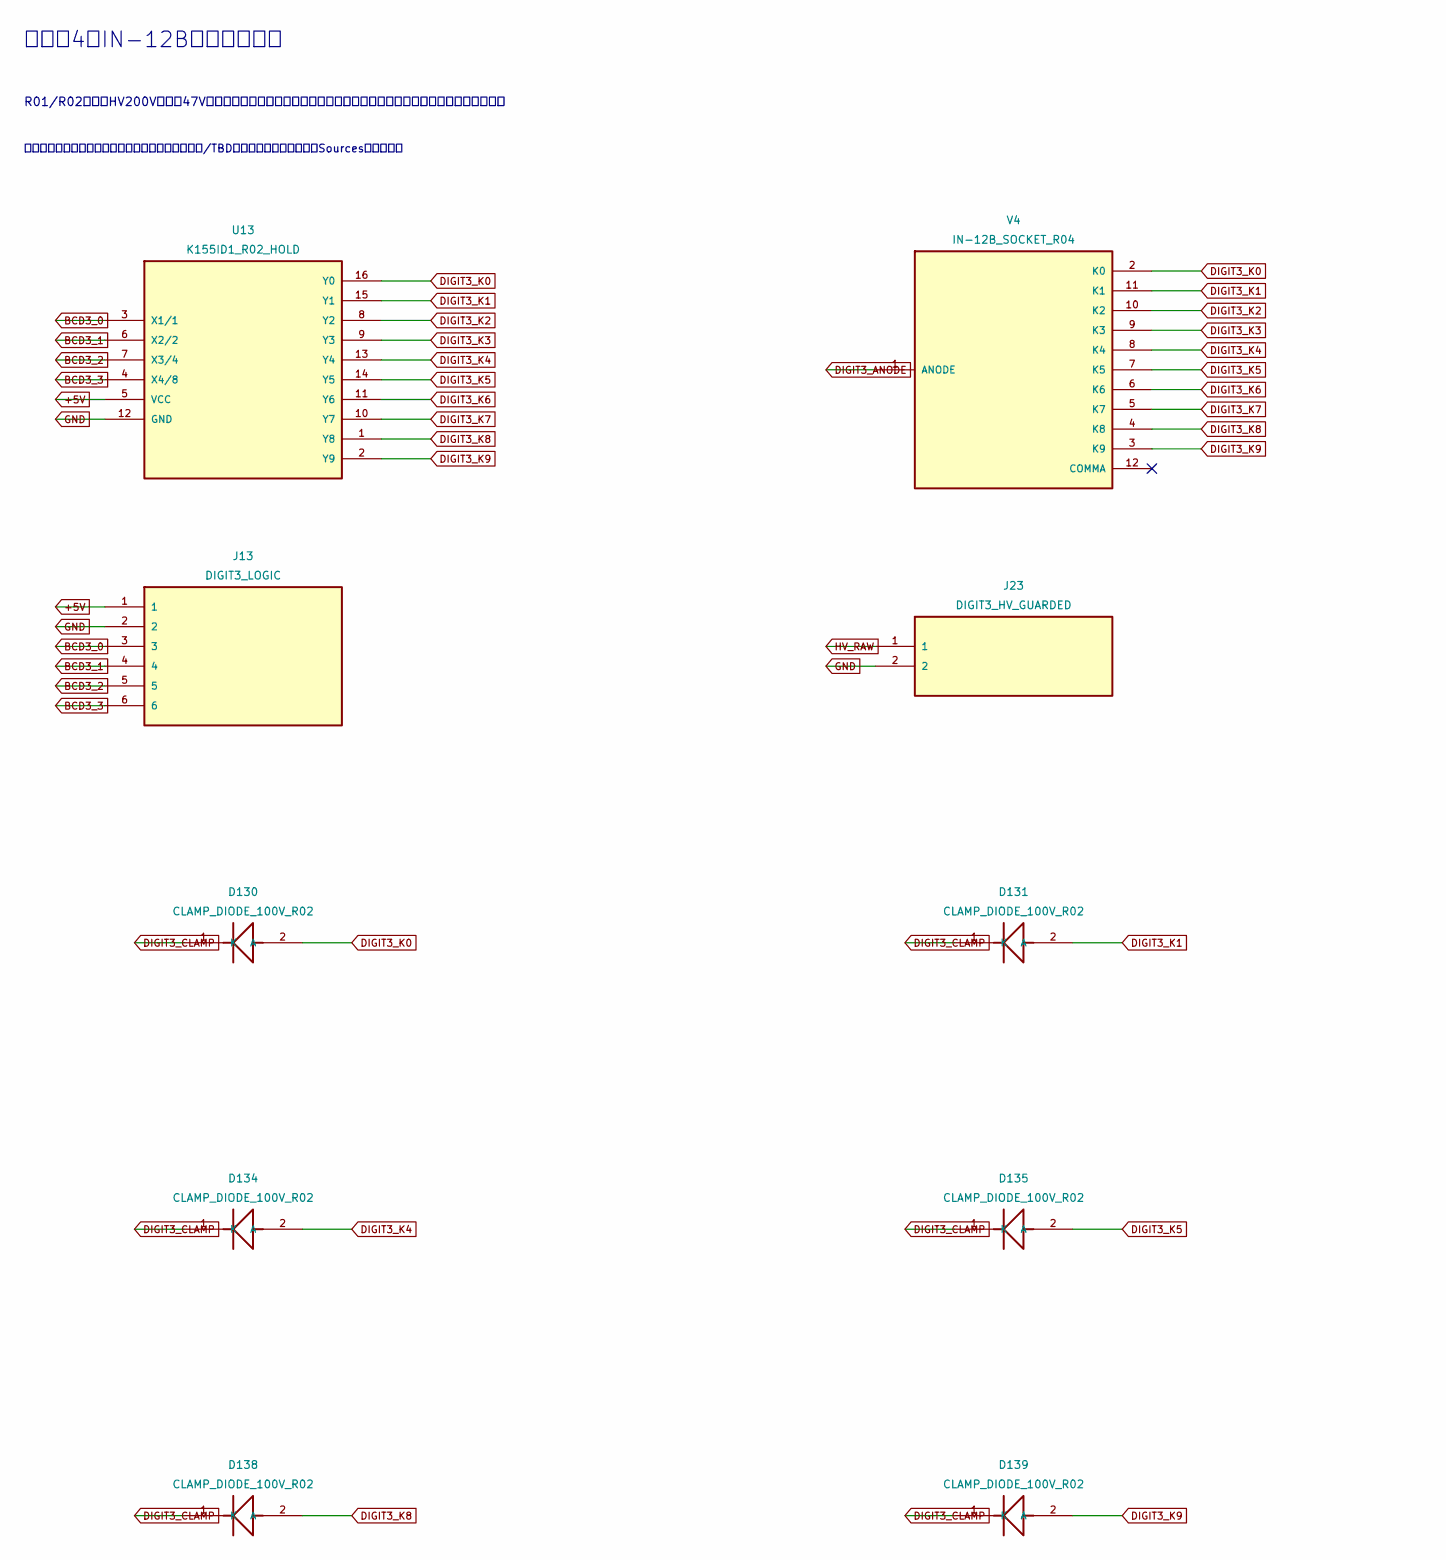
[picture p40: schematic display_3.kicad_sch, part in row 1, column 1]

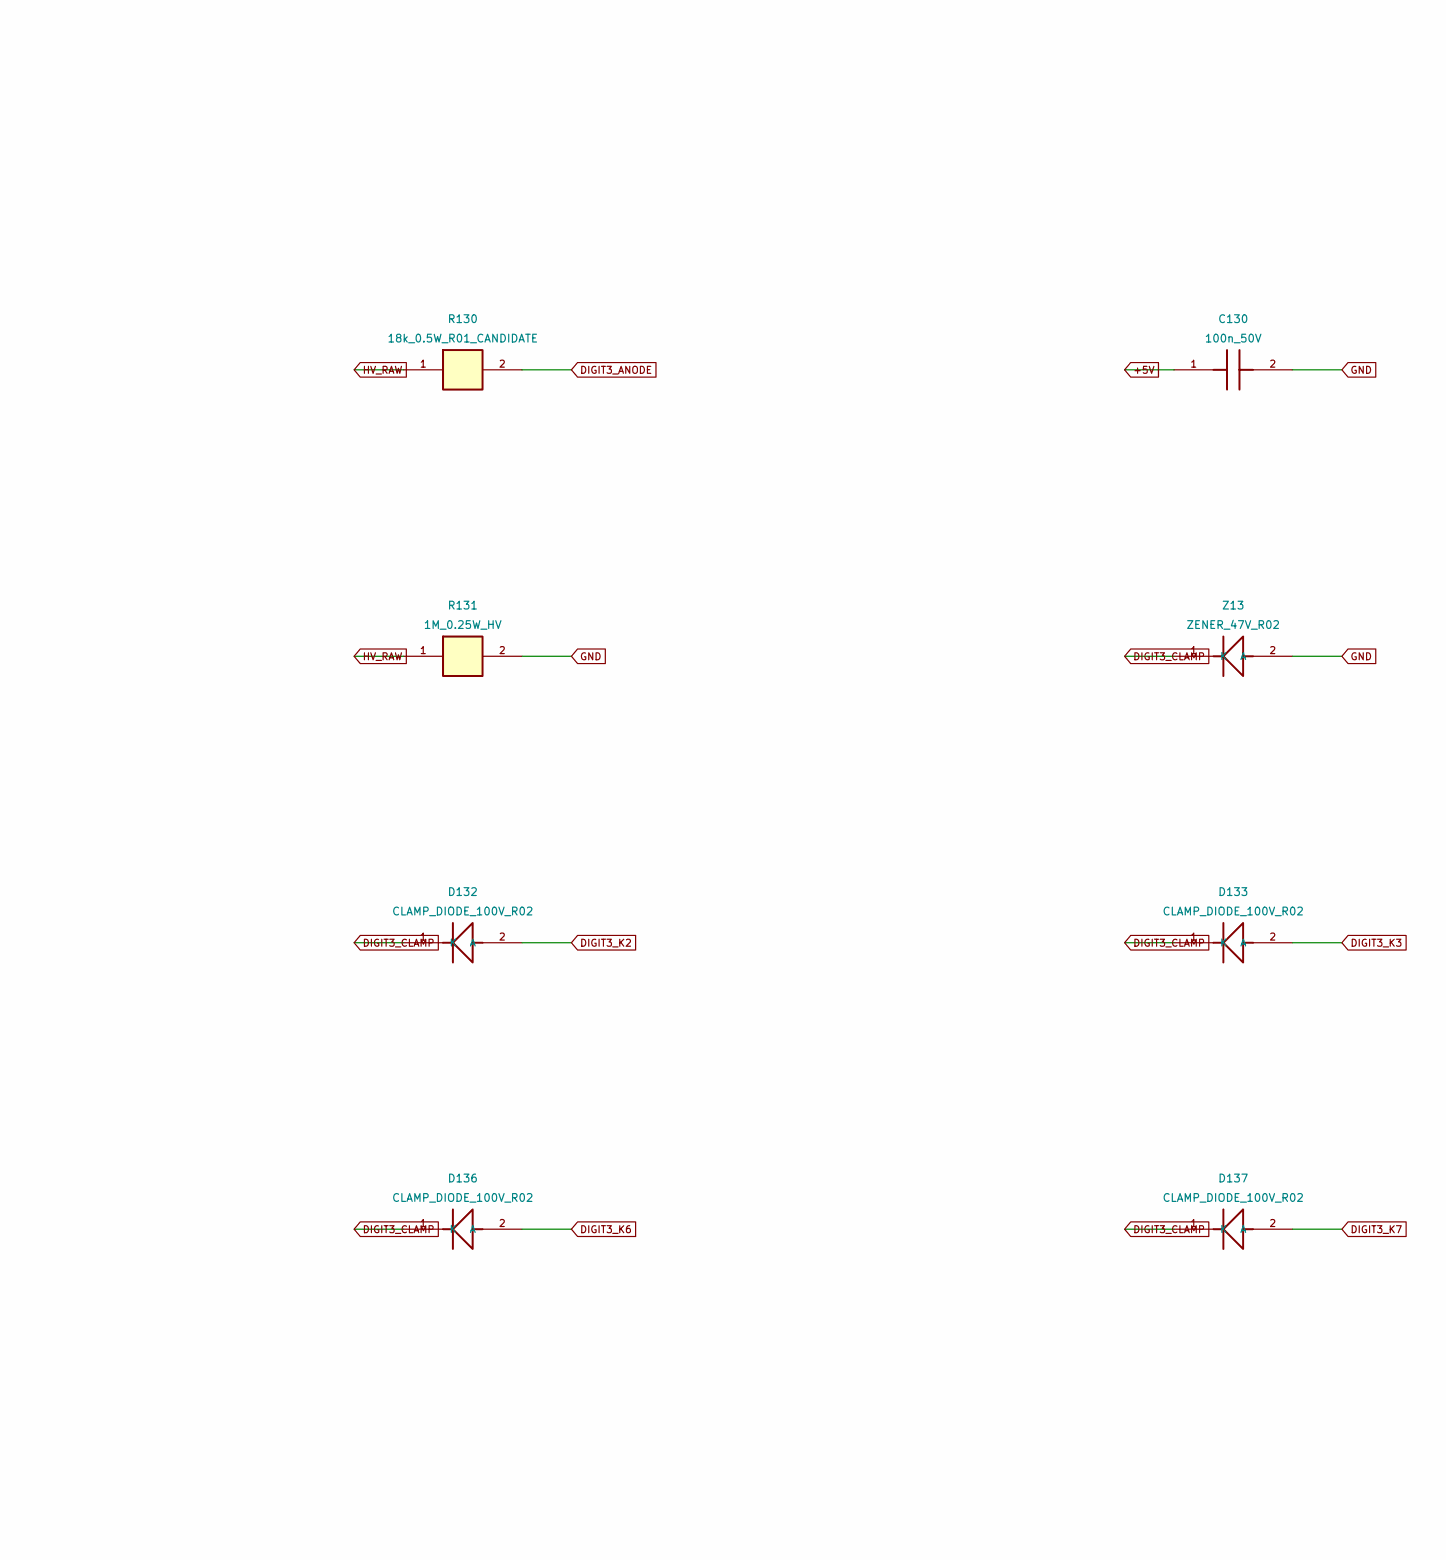
[picture p41: schematic display_3.kicad_sch, part in row 1, column 2]

Parts:
C130: 100n_50V; C_0805_2012Metric
D130, D131, D132, D133, D134, D135, D136, D137, D138, D139: CLAMP_DIODE_100V_R02; D_SOD-123
J13: DIGIT3_LOGIC; PinHeader_1x06_P2.54mm_Vertical
J23: DIGIT3_HV_GUARDED; PhoenixContact_MSTBVA_2,5_2-G-5,08_1x02_P5.08mm_Vertical
R130: 18k_0.5W_R01_CANDIDATE; R_Axial_DIN0309_L9.0mm_D3.2mm_P12.70mm_Horizontal
R131: 1M_0.25W_HV; R_Axial_DIN0309_L9.0mm_D3.2mm_P5.08mm_Vertical
U13: K155ID1_R02_HOLD; DIP-16_W7.62mm
V4: IN-12B_SOCKET_R04; IN-12B_Socket_Candidate
Z13: ZENER_47V_R02; D_SOD-123

Connections:
+5V: C130.1, J13.1, U13.5 (VCC)
BCD3_0: J13.3, U13.3 (X1/1)
BCD3_1: J13.4, U13.6 (X2/2)
BCD3_2: J13.5, U13.7 (X3/4)
BCD3_3: J13.6, U13.4 (X4/8)
DIGIT3_ANODE: R130.2, V4.1 (ANODE)
DIGIT3_CLAMP: D130.1 (K), D131.1 (K), D132.1 (K), D133.1 (K), D134.1 (K), D135.1 (K), D136.1 (K), D137.1 (K), D138.1 (K), D139.1 (K), Z13.1 (K)
DIGIT3_K0: D130.2 (A), U13.16 (Y0), V4.2 (K0)
DIGIT3_K1: D131.2 (A), U13.15 (Y1), V4.11 (K1)
DIGIT3_K2: D132.2 (A), U13.8 (Y2), V4.10 (K2)
DIGIT3_K3: D133.2 (A), U13.9 (Y3), V4.9 (K3)
DIGIT3_K4: D134.2 (A), U13.13 (Y4), V4.8 (K4)
DIGIT3_K5: D135.2 (A), U13.14 (Y5), V4.7 (K5)
DIGIT3_K6: D136.2 (A), U13.11 (Y6), V4.6 (K6)
DIGIT3_K7: D137.2 (A), U13.10 (Y7), V4.5 (K7)
DIGIT3_K8: D138.2 (A), U13.1 (Y8), V4.4 (K8)
DIGIT3_K9: D139.2 (A), U13.2 (Y9), V4.3 (K9)
GND: C130.2, J13.2, J23.2, R131.2, U13.12 (GND), Z13.2 (A)
HV_RAW: J23.1, R130.1, R131.1

Notes on the sheet:
表示子4・IN-12Bソケット候補
R01/R02未閉：HV200V候補と47Vクランプは計算上の候補で未実測。接続検討図であり通電・発注用ではない。
同名のネットラベルは階層を越えて接続。未確定値/TBDは発注不可。端子配置はSources欄を参照。
