nexus4812/nixie-jjy-clock/hardware/schematic/generated/jjy.kicad_sch

## KiCad design hardware/schematic/generated/jjy.kicad_sch (2026-11-08)

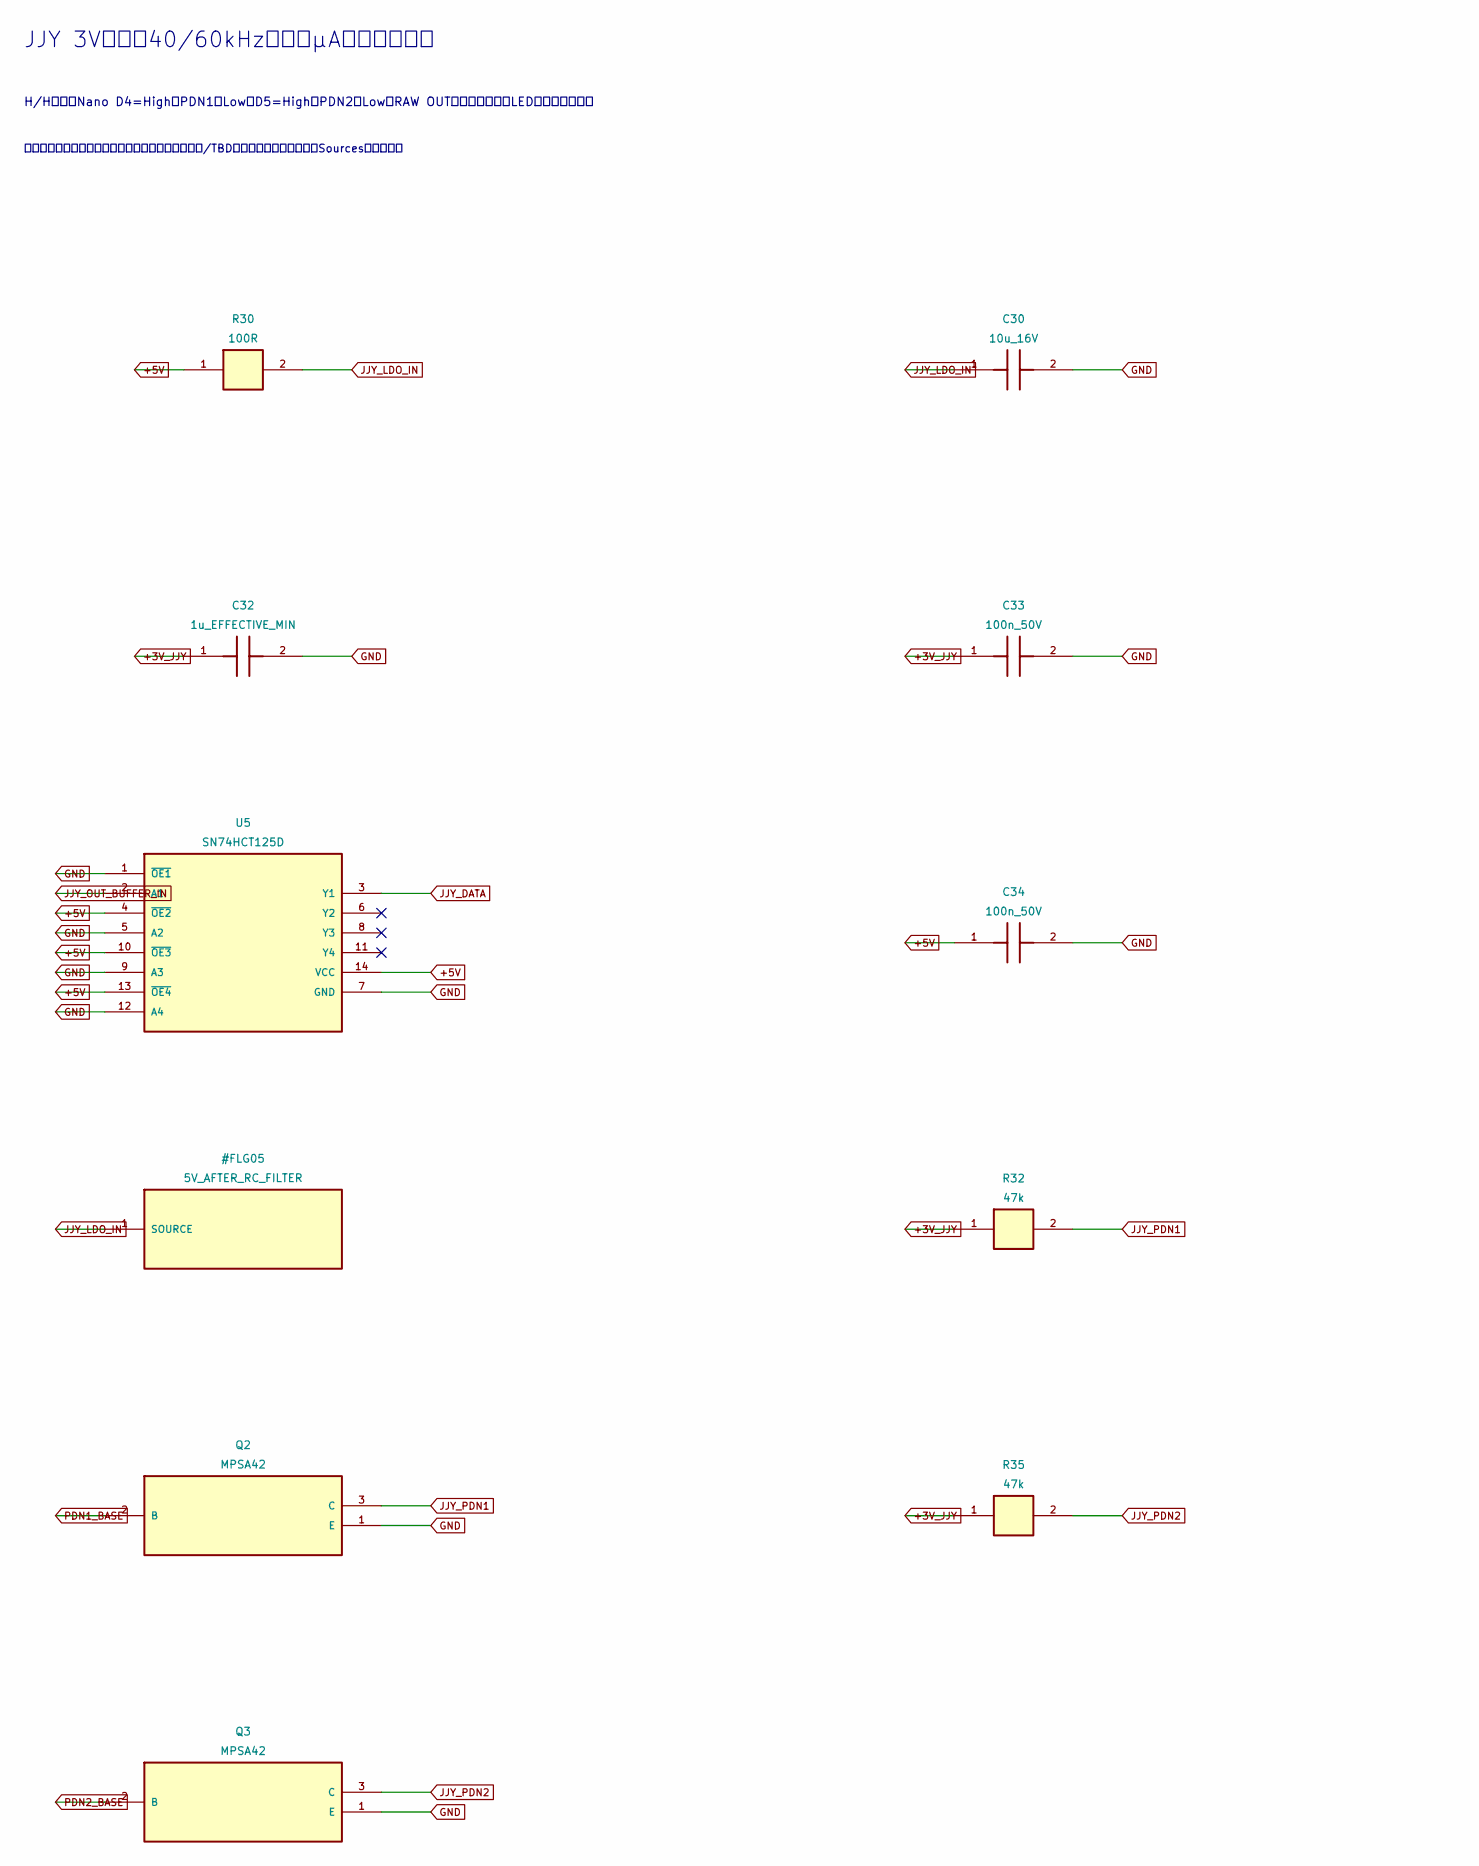
[picture p42: schematic jjy.kicad_sch, part in row 1, column 1]

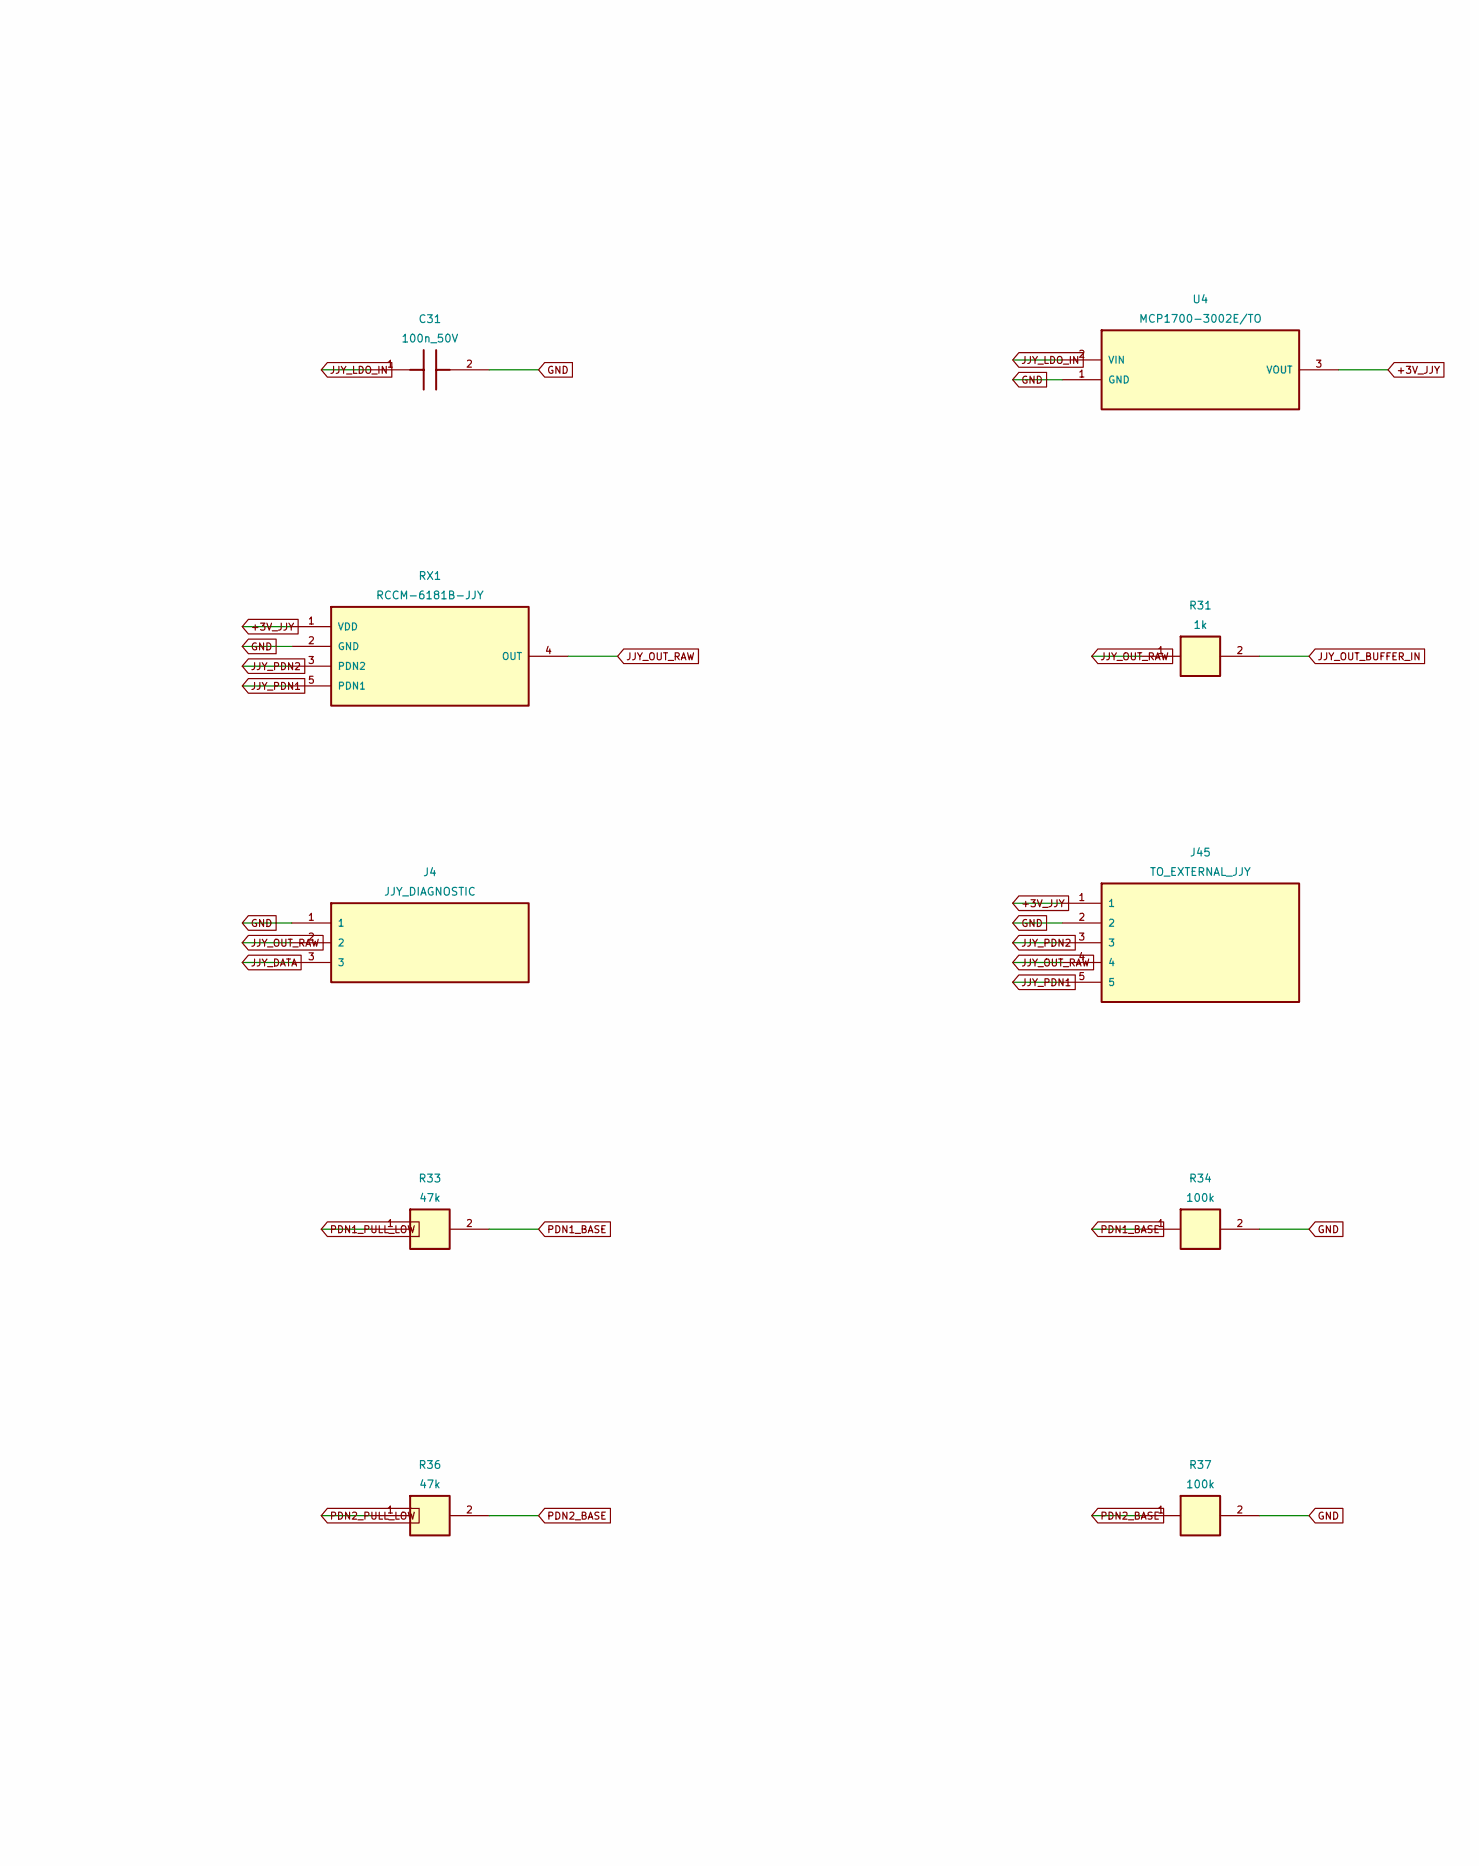
[picture p43: schematic jjy.kicad_sch, part in row 1, column 2]

Parts:
C30: 10u_16V; C_0805_2012Metric
C31, C33, C34: 100n_50V; C_0805_2012Metric
C32: 1u_EFFECTIVE_MIN; C_0805_2012Metric
J4: JJY_DIAGNOSTIC; PinHeader_1x03_P2.54mm_Vertical
J45: TO_EXTERNAL_JJY; PinHeader_1x05_P2.54mm_Vertical
Q2, Q3: MPSA42; TO-92_Inline_Wide
R30: 100R; R_0805_2012Metric
R31: 1k; R_0805_2012Metric
R32, R33, R35, R36: 47k; R_0805_2012Metric
R34, R37: 100k; R_0805_2012Metric
RX1: RCCM-6181B-JJY
U4: MCP1700-3002E/TO; TO-92_Inline_Wide
U5: SN74HCT125D; SOIC-14_3.9x8.7mm_P1.27mm

Connections:
+3V_JJY: C32.1, C33.1, J45.1, R32.1, R35.1, RX1.1 (VDD), U4.3 (VOUT)
+5V: C34.1, R30.1, U5.4 (~OE2), U5.10 (~OE3), U5.13 (~OE4), U5.14 (VCC)
GND: C30.2, C31.2, C32.2, C33.2, C34.2, J4.1, J45.2, Q2.1 (E), Q3.1 (E), R34.2, R37.2, RX1.2 (GND), U4.1 (GND), U5.1 (~OE1), U5.5 (A2), U5.7 (GND), U5.9 (A3), U5.12 (A4)
JJY_DATA: J4.3, U5.3 (Y1)
JJY_LDO_IN: C30.1, C31.1, R30.2, U4.2 (VIN)
JJY_OUT_BUFFER_IN: R31.2, U5.2 (A1)
JJY_OUT_RAW: J4.2, J45.4, R31.1, RX1.4 (OUT)
JJY_PDN1: J45.5, Q2.3 (C), R32.2, RX1.5 (PDN1)
JJY_PDN2: J45.3, Q3.3 (C), R35.2, RX1.3 (PDN2)
PDN1_BASE: Q2.2 (B), R33.2, R34.1
PDN1_PULL_LOW: R33.1
PDN2_BASE: Q3.2 (B), R36.2, R37.1
PDN2_PULL_LOW: R36.1

Notes on the sheet:
JJY 3V電源・40/60kHz選局・µA出力バッファ
H/H停止。Nano D4=HighでPDN1をLow、D5=HighでPDN2をLow。RAW OUTへプルアップやLEDを接続しない。
同名のネットラベルは階層を越えて接続。未確定値/TBDは発注不可。端子配置はSources欄を参照。
