nexus4812/nixie-jjy-clock/hardware/schematic/generated/power.kicad_sch

## KiCad design hardware/schematic/generated/power.kicad_sch (2026-11-08)

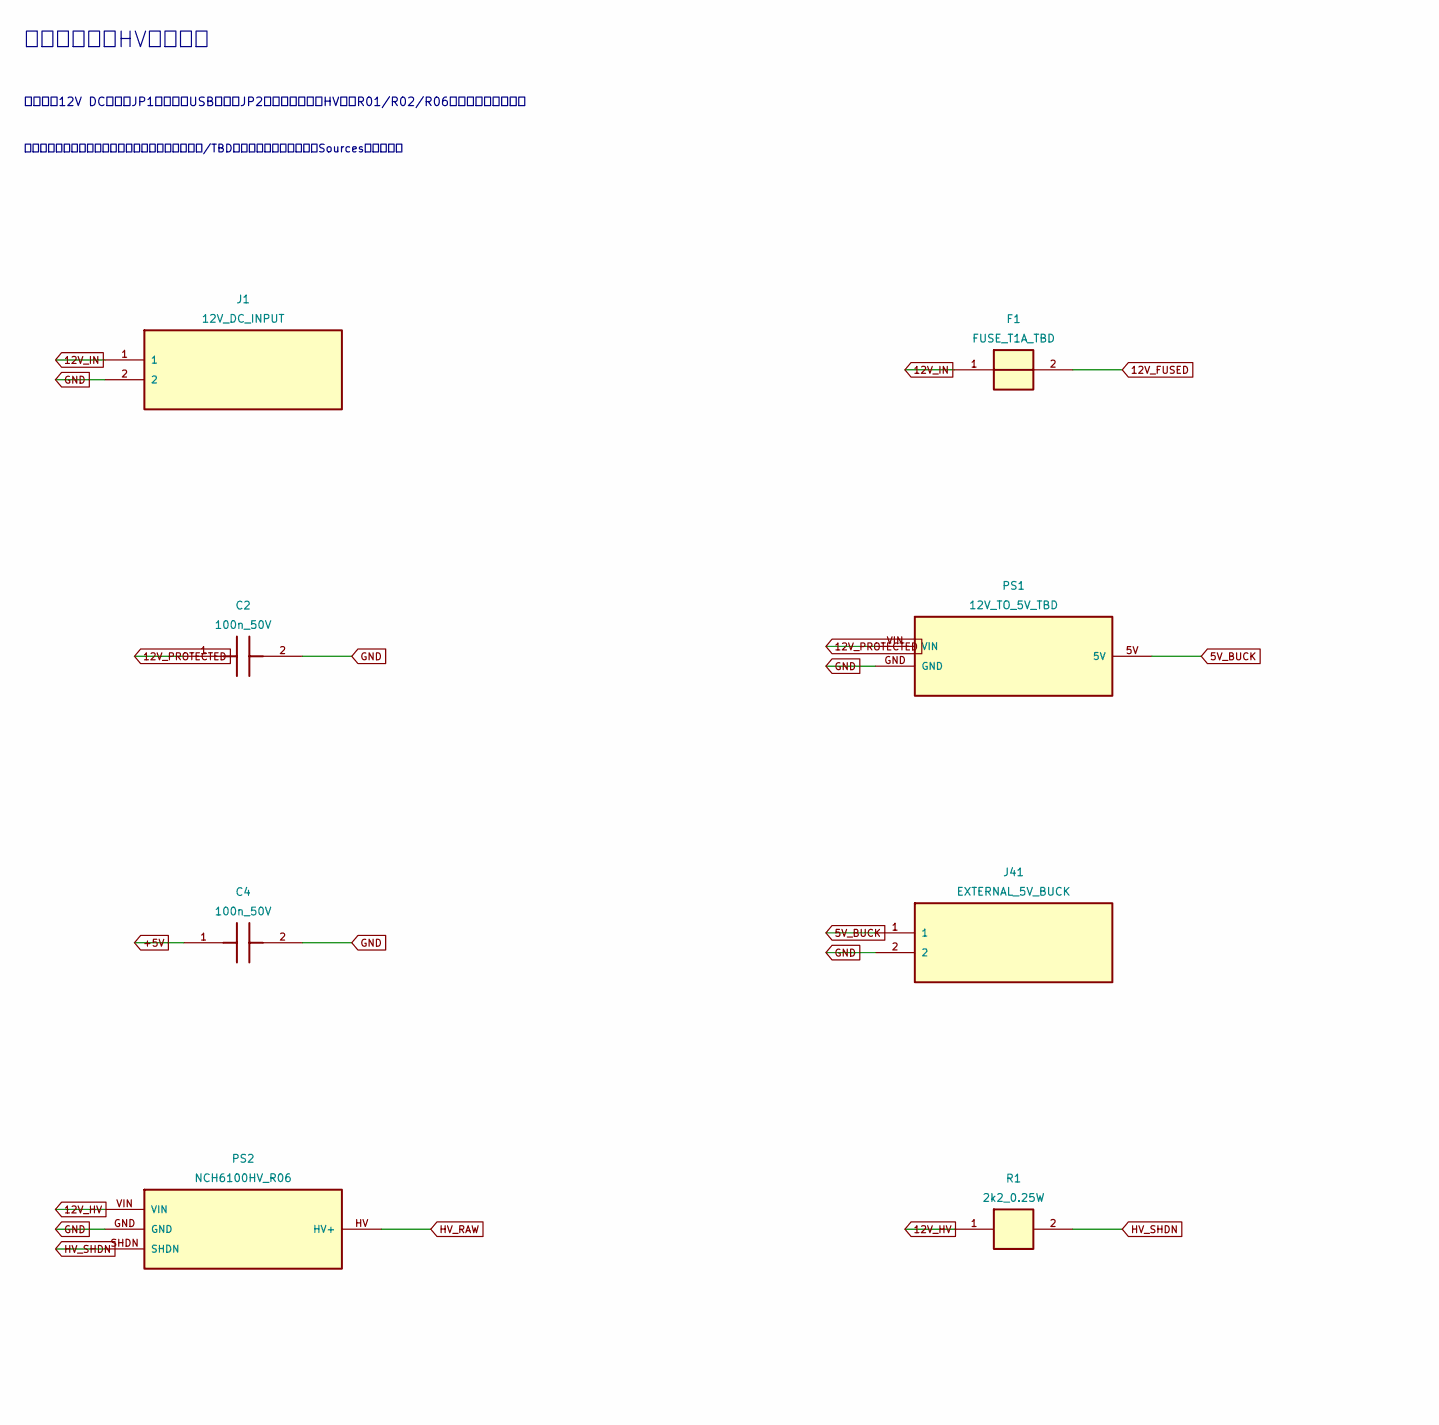
[picture p44: schematic power.kicad_sch, part in row 1, column 1]

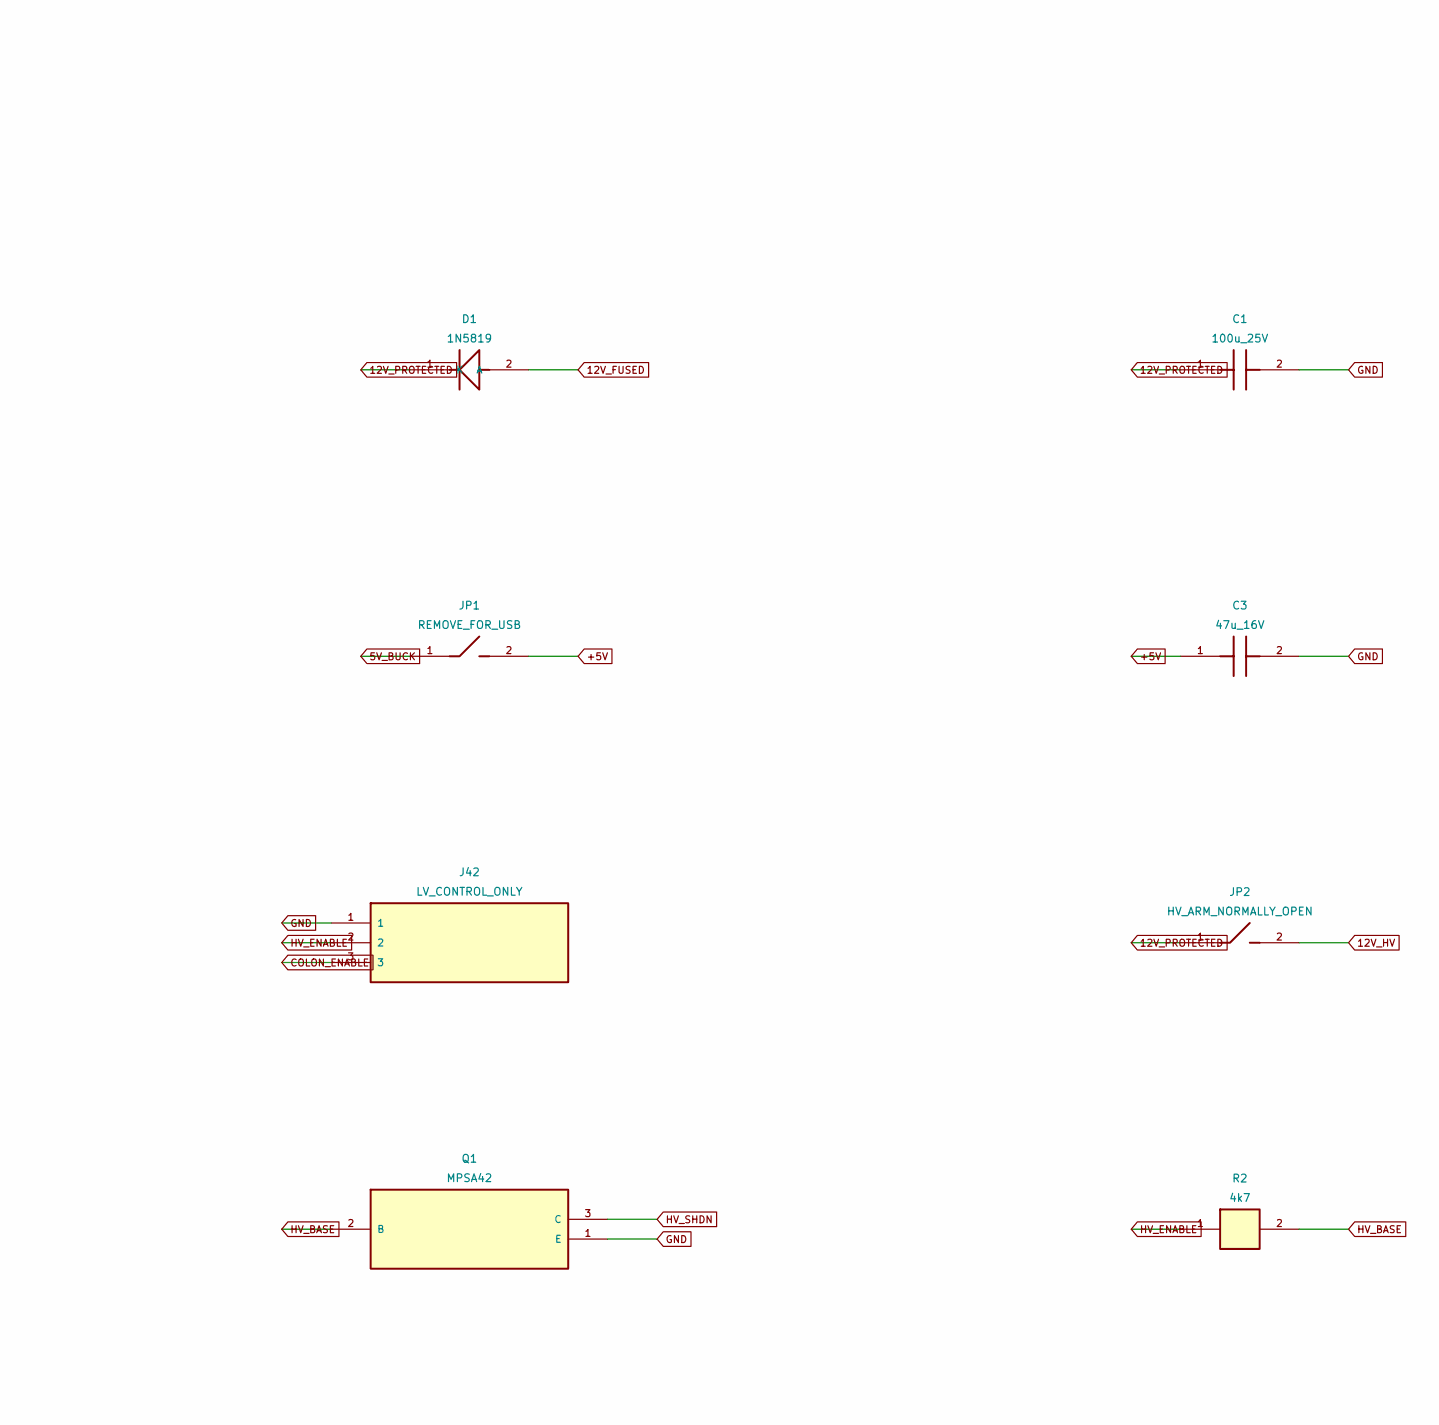
[picture p45: schematic power.kicad_sch, part in row 1, column 2]

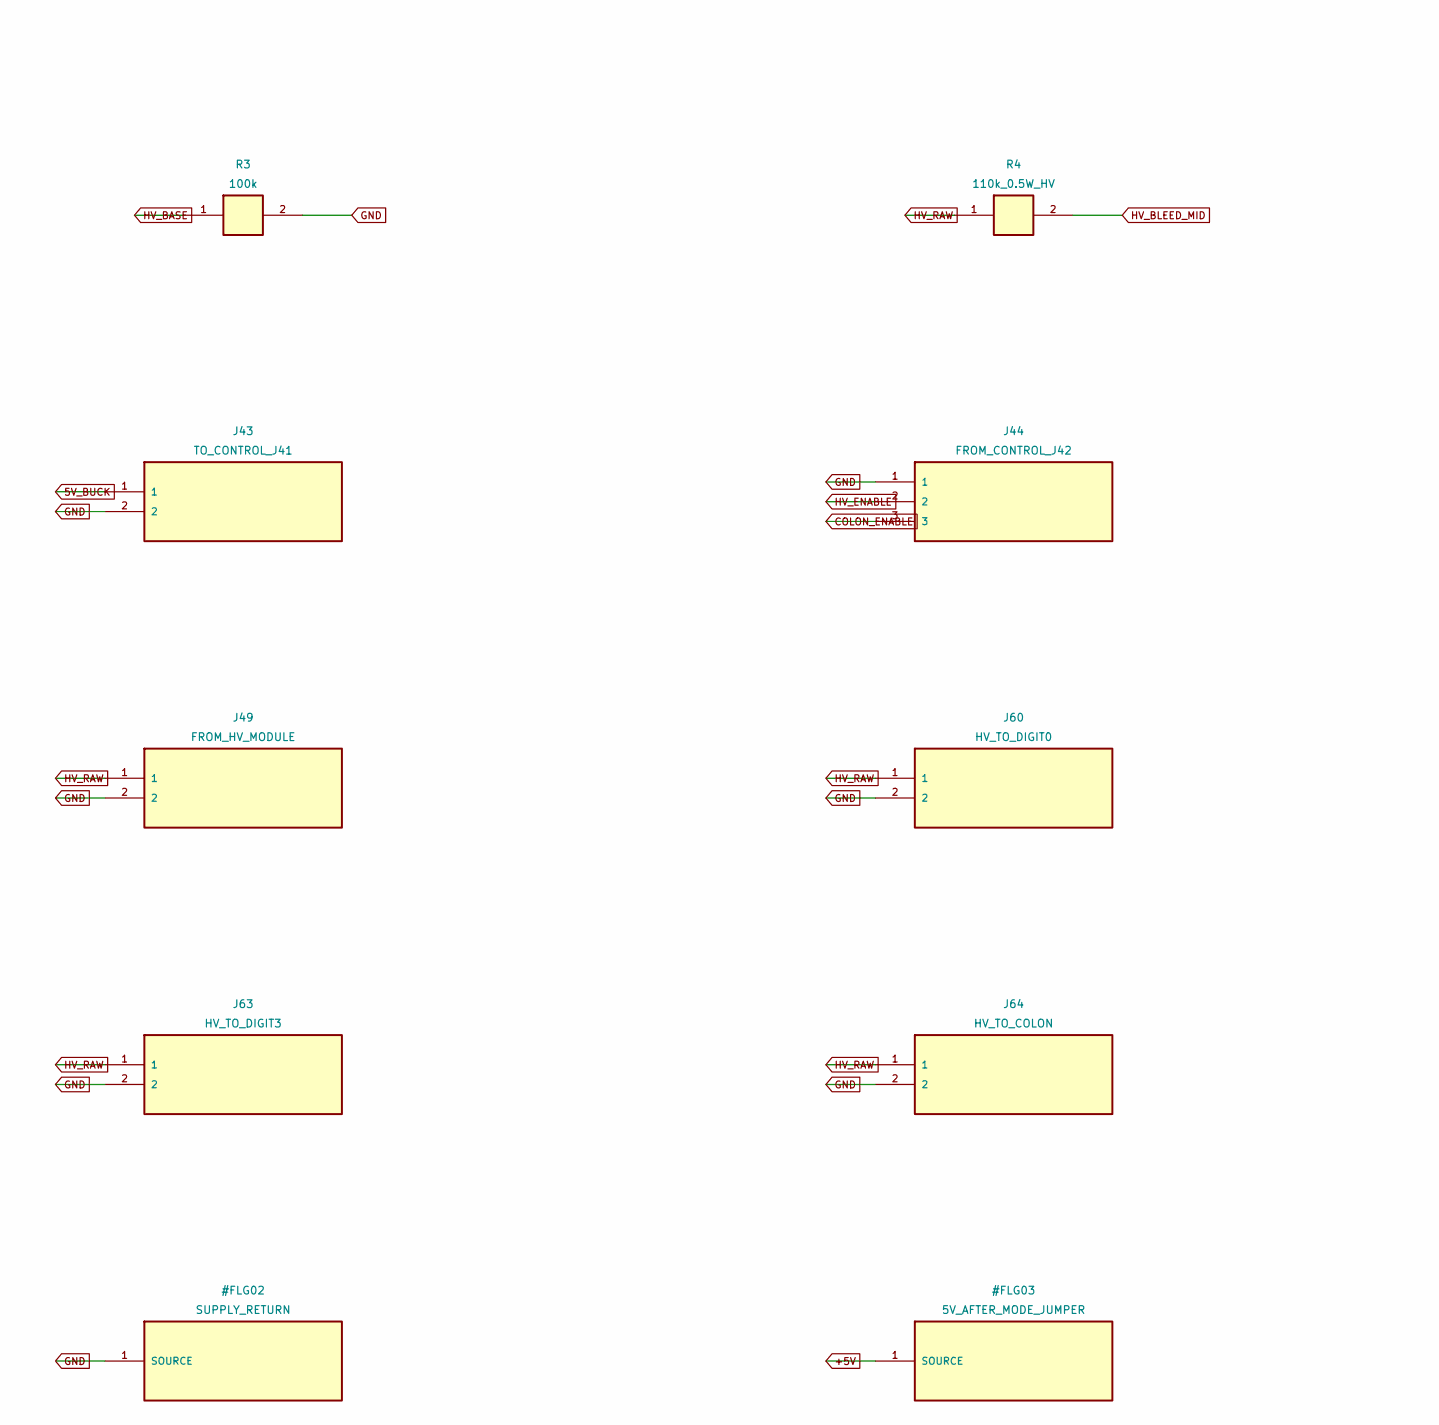
[picture p46: schematic power.kicad_sch, part in row 2, column 1]

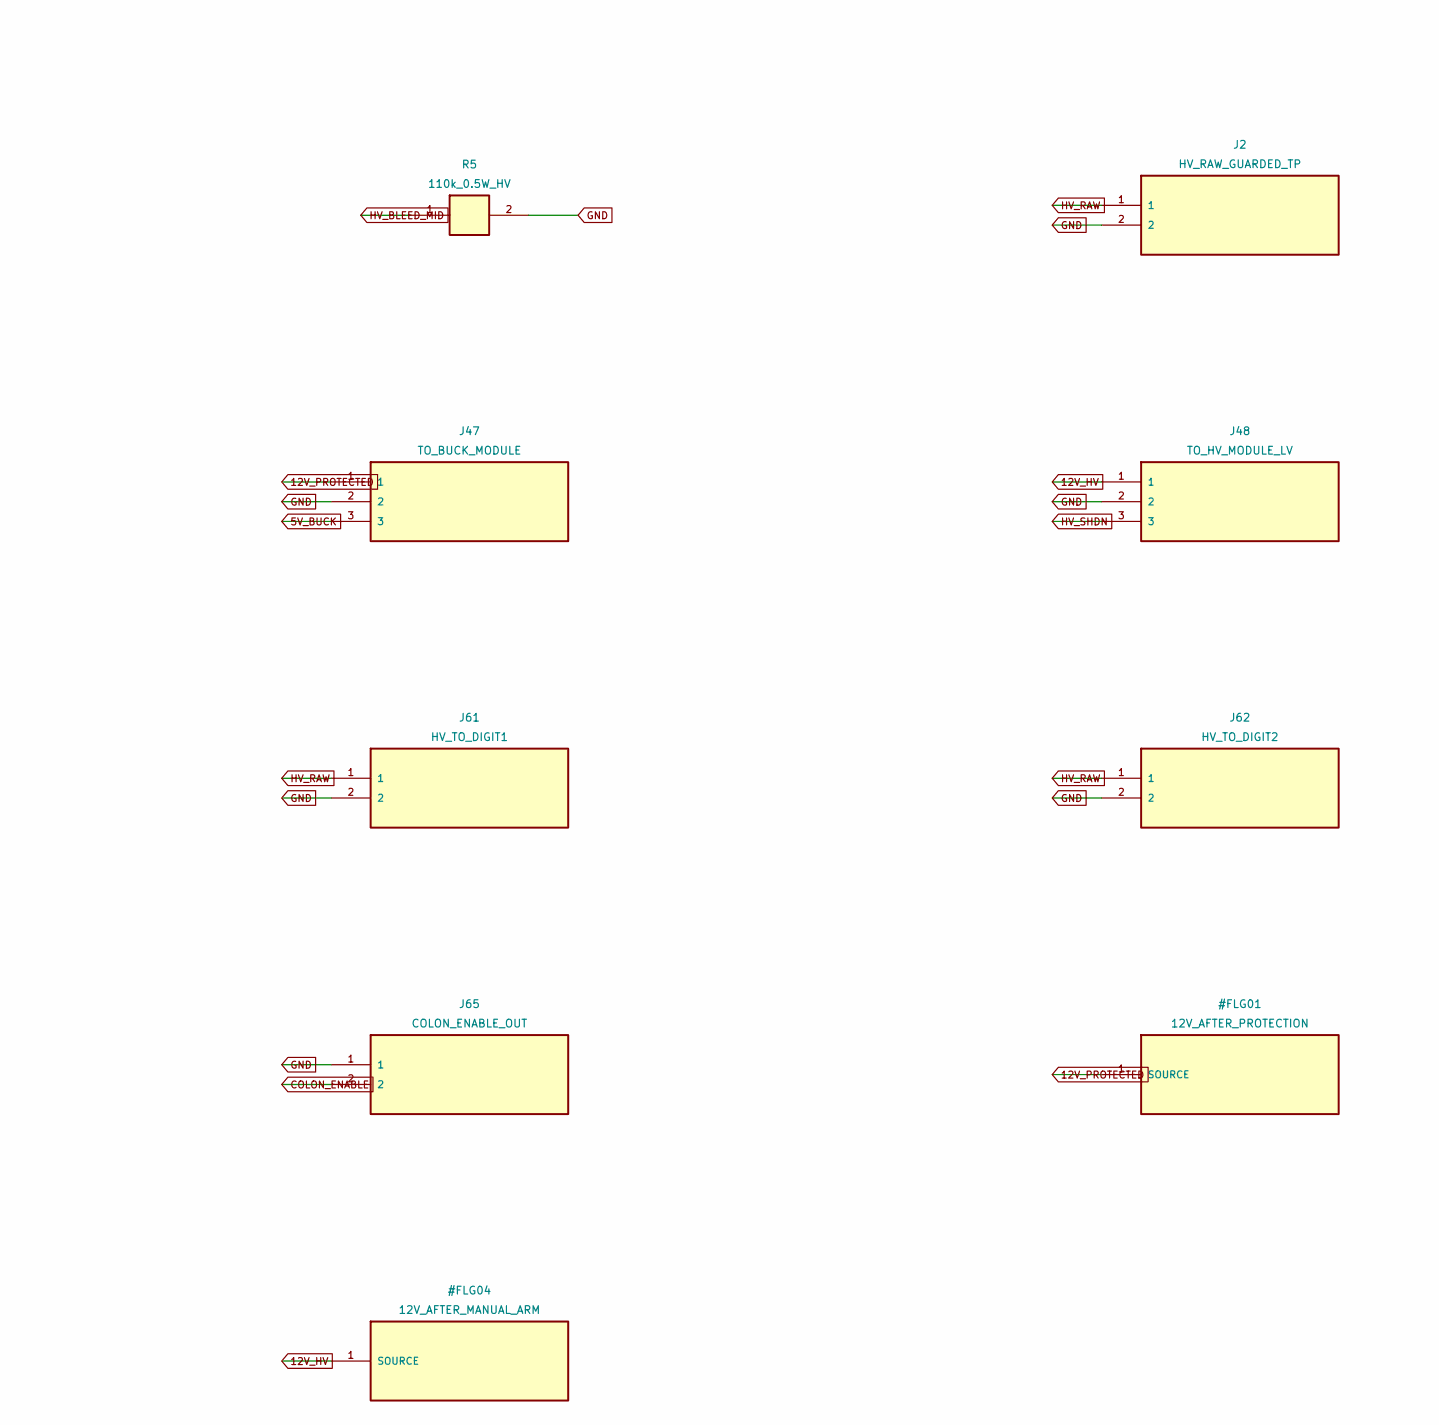
[picture p47: schematic power.kicad_sch, part in row 2, column 2]

Parts:
C1: 100u_25V; CP_Radial_D8.0mm_P3.50mm
C2, C4: 100n_50V; C_0805_2012Metric
C3: 47u_16V; CP_Radial_D5.0mm_P2.00mm
D1: 1N5819; D_DO-41_SOD81_P10.16mm_Horizontal
F1: FUSE_T1A_TBD; Fuseholder_Clip-5x20mm_Bel_FC-203-22_Lateral_P17.80x5.00mm_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
J1: 12V_DC_INPUT; JST_VH_B2P-VH_1x02_P3.96mm_Vertical
J2: HV_RAW_GUARDED_TP; PhoenixContact_MSTBVA_2,5_2-G-5,08_1x02_P5.08mm_Vertical
J41: EXTERNAL_5V_BUCK; PinHeader_1x02_P2.54mm_Vertical
J42: LV_CONTROL_ONLY; PinHeader_1x03_P2.54mm_Vertical
J43: TO_CONTROL_J41; PinHeader_1x02_P2.54mm_Vertical
J44: FROM_CONTROL_J42; PinHeader_1x03_P2.54mm_Vertical
J47: TO_BUCK_MODULE; PinHeader_1x03_P2.54mm_Vertical
J48: TO_HV_MODULE_LV; PinHeader_1x03_P2.54mm_Vertical
J49: FROM_HV_MODULE; PhoenixContact_MSTBVA_2,5_2-G-5,08_1x02_P5.08mm_Vertical
J60: HV_TO_DIGIT0; PhoenixContact_MSTBVA_2,5_2-G-5,08_1x02_P5.08mm_Vertical
J61: HV_TO_DIGIT1; PhoenixContact_MSTBVA_2,5_2-G-5,08_1x02_P5.08mm_Vertical
J62: HV_TO_DIGIT2; PhoenixContact_MSTBVA_2,5_2-G-5,08_1x02_P5.08mm_Vertical
J63: HV_TO_DIGIT3; PhoenixContact_MSTBVA_2,5_2-G-5,08_1x02_P5.08mm_Vertical
J64: HV_TO_COLON; PhoenixContact_MSTBVA_2,5_2-G-5,08_1x02_P5.08mm_Vertical
J65: COLON_ENABLE_OUT; PinHeader_1x02_P2.54mm_Vertical
JP1: REMOVE_FOR_USB; PinHeader_1x02_P2.54mm_Vertical
JP2: HV_ARM_NORMALLY_OPEN; PinHeader_1x02_P2.54mm_Vertical
PS1: 12V_TO_5V_TBD
PS2: NCH6100HV_R06
Q1: MPSA42; TO-92_Inline_Wide
R1: 2k2_0.25W; R_Axial_DIN0207_L6.3mm_D2.5mm_P7.62mm_Horizontal
R2: 4k7; R_0805_2012Metric
R3: 100k; R_0805_2012Metric
R4, R5: 110k_0.5W_HV; R_Axial_DIN0309_L9.0mm_D3.2mm_P12.70mm_Horizontal

Connections:
5V_BUCK: J41.1, J43.1, J47.3, JP1.1, PS1.5V
12V_FUSED: D1.2 (A), F1.2
12V_HV: J48.1, JP2.2, PS2.VIN, R1.1
12V_IN: F1.1, J1.1
12V_PROTECTED: C1.1, C2.1, D1.1 (K), J47.1, JP2.1, PS1.VIN
+5V: C3.1, C4.1, JP1.2
COLON_ENABLE: J42.3, J44.3, J65.2
GND: C1.2, C2.2, C3.2, C4.2, J1.2, J2.2, J41.2, J42.1, J43.2, J44.1, J47.2, J48.2, J49.2, J60.2, J61.2, J62.2, J63.2, J64.2, J65.1, PS1.GND, PS2.GND, Q1.1 (E), R3.2, R5.2
HV_BASE: Q1.2 (B), R2.2, R3.1
HV_BLEED_MID: R4.2, R5.1
HV_ENABLE: J42.2, J44.2, R2.1
HV_RAW: J2.1, J49.1, J60.1, J61.1, J62.1, J63.1, J64.1, PS2.HV (HV+), R4.1
HV_SHDN: J48.3, PS2.SHDN, Q1.3 (C), R1.2

Notes on the sheet:
電源・保護・HV停止制御
市販絶縁12V DCのみ。JP1を外してUSB書込。JP2は通常未挿入。HV部はR01/R02/R06未解決・通電不可。
同名のネットラベルは階層を越えて接続。未確定値/TBDは発注不可。端子配置はSources欄を参照。
