nexus4812/nixie-jjy-clock/hardware/schematic/generated/rtc.kicad_sch

## KiCad design hardware/schematic/generated/rtc.kicad_sch (2026-11-08)


Parts:
BT1: Keystone 1060; BatteryHolder_Keystone_1060_1x2032
C20: 100n_50V; C_0805_2012Metric
J3: I2C_TEST; PinHeader_1x04_P2.54mm_Vertical
R20, R21: 4k7; R_0805_2012Metric
R22: 10k; R_0805_2012Metric
U3: DS3231SN#; SOIC-16W_7.5x10.3mm_P1.27mm

Connections:
+5V: C20.1, J3.1, R20.1, R21.1, R22.1, U3.2 (VCC)
GND: BT1.2 (-), C20.2, J3.2, U3.5 (N.C._GND), U3.6 (N.C._GND), U3.7 (N.C._GND), U3.8 (N.C._GND), U3.9 (N.C._GND), U3.10 (N.C._GND), U3.11 (N.C._GND), U3.12 (N.C._GND), U3.13 (GND)
I2C_SCL: J3.4, R21.2, U3.16 (SCL)
I2C_SDA: J3.3, R20.2, U3.15 (SDA)
RTC_SQW: R22.2, U3.3 (INT/SQW)
VBAT: BT1.1 (+), U3.14 (VBAT)

Notes on the sheet:
DS3231・非充電バックアップ
DS3231S/SN。N.C.の5〜12番はGND。CR2032は充電しない。RST外部プルアップなし。
同名のネットラベルは階層を越えて接続。未確定値/TBDは発注不可。端子配置はSources欄を参照。
