nexus4812/nixie-jjy-clock/hardware/schematic/generated/ui.kicad_sch

## KiCad design hardware/schematic/generated/ui.kicad_sch (2026-11-08)

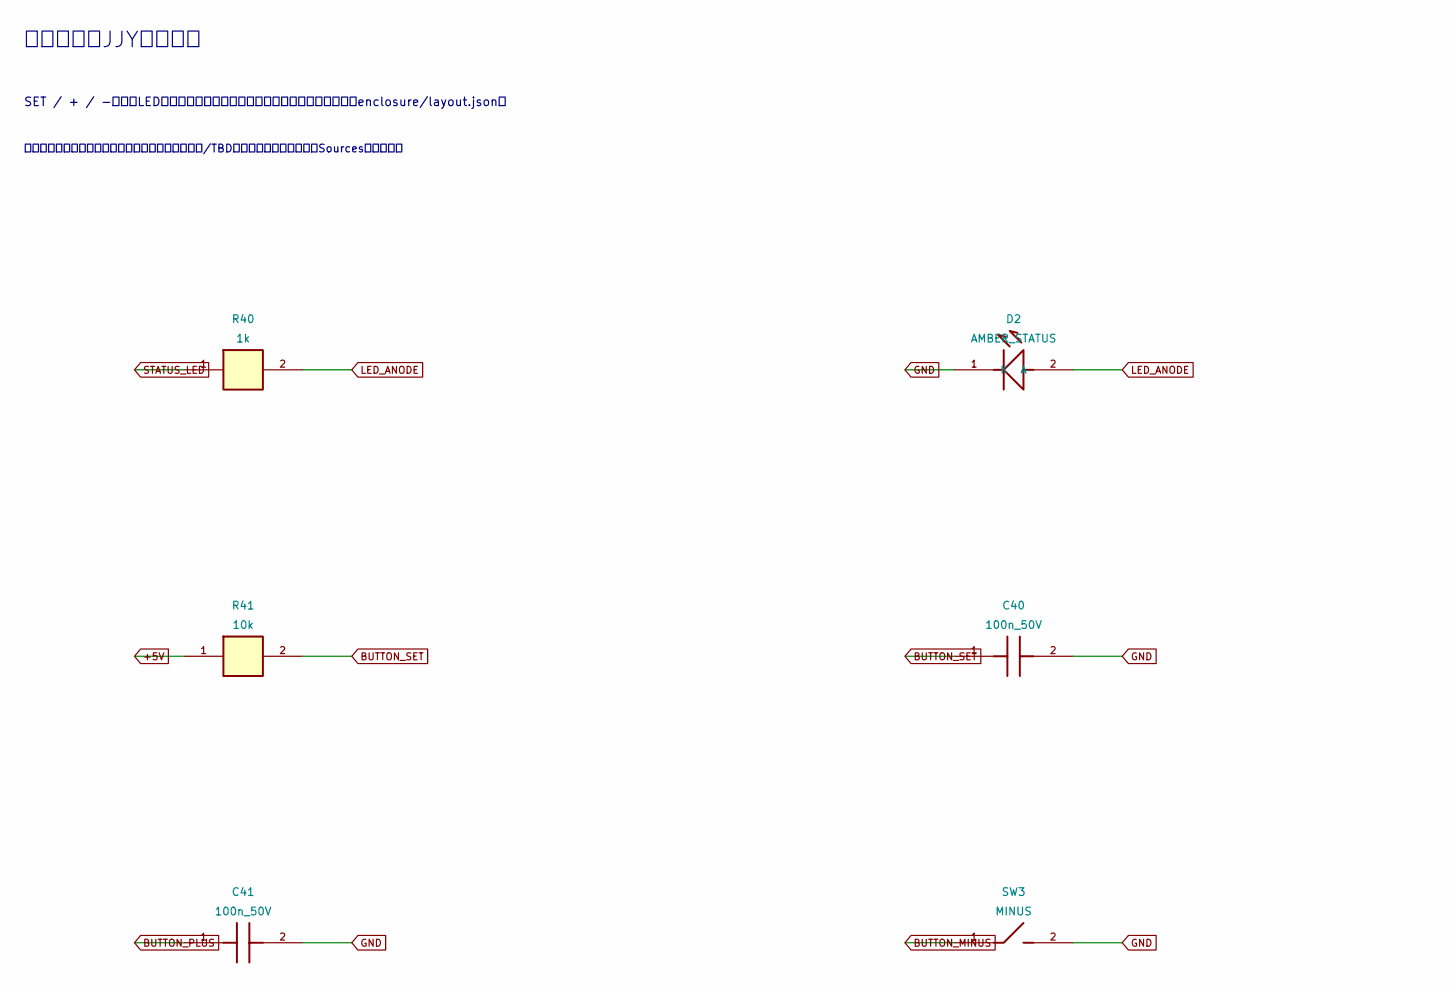
[picture p48: schematic ui.kicad_sch, part in row 1, column 1]

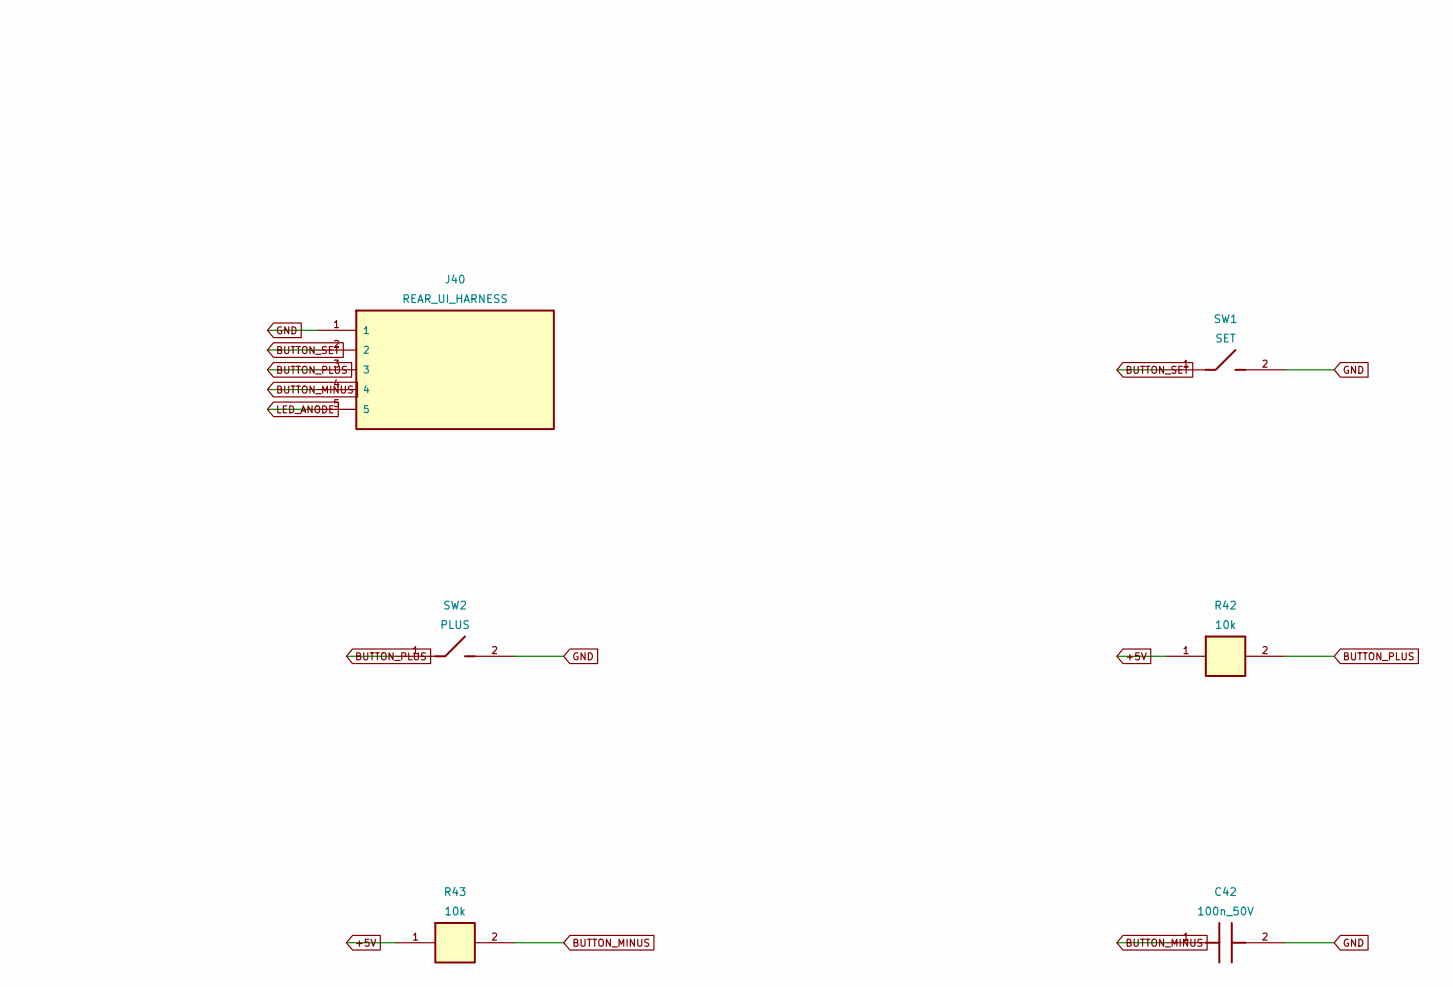
[picture p49: schematic ui.kicad_sch, part in row 1, column 2]

Parts:
C40, C41, C42: 100n_50V; C_0805_2012Metric
D2: AMBER_STATUS
J40: REAR_UI_HARNESS; PinHeader_1x05_P2.54mm_Vertical
R40: 1k; R_0805_2012Metric
R41, R42, R43: 10k; R_0805_2012Metric
SW1: SET
SW2: PLUS
SW3: MINUS

Connections:
+5V: R41.1, R42.1, R43.1
BUTTON_MINUS: C42.1, J40.4, R43.2, SW3.1
BUTTON_PLUS: C41.1, J40.3, R42.2, SW2.1
BUTTON_SET: C40.1, J40.2, R41.2, SW1.1
GND: C40.2, C41.2, C42.2, D2.1 (K), J40.1, SW1.2, SW2.2, SW3.2
LED_ANODE: D2.2 (A), J40.5, R40.2
STATUS_LED: R40.1

Notes on the sheet:
背面操作・JJY状態表示
SET / + / -。状態LEDの点滅はファームウェアで定義。共有位置データはenclosure/layout.json。
同名のネットラベルは階層を越えて接続。未確定値/TBDは発注不可。端子配置はSources欄を参照。
