nexus4812/nixie-jjy-clock/(commit log)

2026-11-08 JJY時計の設計初版・制御基板とケース案・引き継ぎ資料を追加
    [bom.csv, clock.scad, colon.kicad_pcb, colon.kicad_sch, control-board.dsn, control-board.kicad_pcb, control-board.kicad_sch, control.kicad_pcb]
2026-11-08 HV表示・コロン・電源基板の候補配置/配線とクランプ回路を追加
    - 表示/コロン/電源PCBの候補配置・配線とERC/DRC検査を追加
    - K155ID1の閉出力クランプ、HV200V/18kΩ候補を回路へ反映
    - コロン板の寸法変更と電源板追加で共通寸法を更新
    - HANDOFF.mdを削除しCLAUDE.mdからAGENTS.mdを参照
    製造・通電は未承認。現物照合と実測は未実施。
    [colon-board.dsn, colon-board.kicad_pcb, colon-board.kicad_sch, colon.kicad_pcb, colon.kicad_sch, control-board.kicad_pcb, control.kicad_pcb, display-board.dsn]
